bgobbato/spacer_shoulder/research/01_artigo_referencia.md

# 01 — Artigo de referência: Klosterman et al. 2021 (Arthroscopy Techniques), leitura integral + vídeo

> Pesquisa paralela ao SchulterPlan (não é código do produto). Escopo: espaçador umeral de PMMA com
> antibiótico, em dois tempos, com molde de duas metades para o segmento proximal (corpo + cabeça).
> Tudo que não pude confirmar numa fonte primária está marcado **NÃO VERIFICADO**.
> Data da leitura: 25/set/2026.

## 0. Resumo em 12 linhas

1. O artigo **não usa molde impresso nem feito sob medida**. Usa um **molde metálico comercial** da Wright Medical:
   "Aequalis Ascend Flex Convertible Shoulder System Molds", com **4 tamanhos de haste (2, 4, 6, 8)** e
   **3 cabeças (43 × 16, 48 × 18, 52 × 23 mm)**. O "custom" do título é o **comprimento**, feito com um
   **tubo torácico** como forma do segmento distal.
2. O molde tem **4 peças por conjunto montado**: 2 blocos de haste (metades) e 2 meias-cúpulas de cabeça. Cada
   meia-cúpula é **aparafusada** ao seu bloco de haste na face oblíqua proximal (o plano de ressecção), com 2
   parafusos Allen por metade (chave sextavada de 3,5 mm).
3. **Plano de partição**: é o plano que contém o eixo da haste e o eixo do colo. As metades são anterior e
   posterior do implante, exatamente o que o Dr. Bruno quer.
4. **Registro**: há **2 pinos machos de ponta abaulada numa metade** (canto próximo-lateral e canto
   disto-medial, em diagonal) e **2 furos passantes na outra**. Um único **grampo em C de aço inox** fecha
   o molde apertando as faces externas, que são planas e paralelas.
5. **Não há canal de injeção nem respiros**. Cada metade é enchida **a céu aberto**, com o cimento fluido
   ("manteiga de amendoim mole"). O molde é fechado por compressão e o excesso sai pela linha de partição
   e é removido. A extremidade distal tem um **cone (funil)** que **não se enche**: por ali saem o fio-guia
   e o tubo.
6. **Reforço**: é uma **haste de fresagem de 2,5 mm com ponta em bola** (DePuy Synthes). Ela vai da ponta
   distal do tubo até dentro da cabeça. A bola fica na cabeça. **Não há pino de Steinmann** nem outro
   reforço.
7. **Cimento**: Palacos R (pacote de 40,3 g de pó + 20 mL de líquido). Por pacote vão **3,6 g de
   tobramicina + 2,0 g de vancomicina**. Com 2 pacotes usam 2,5 "doses" de monômero, e com 3 pacotes
   usam 3,5. Os antibióticos são misturados primeiro ao monômero. Na primeira vez, planejar 3 pacotes.
8. **Tubo torácico**: tenha à mão tubos de **24 a 34 Fr**. A conversão é **1 mm = 3 Fr**. O texto do
   artigo diz "3 mm = 1 French", mas a Fig 2 e o vídeo dizem o contrário; ver §4.2. Fr é o diâmetro
   **externo**, então a haste de cimento sai **mais fina** que o Fr indica.
9. **Presa em cerca de 16 min** na mesa auxiliar. O **óleo mineral** no molde e dentro do tubo é, nas
   palavras dos autores, "crucial" para a desmoldagem.
10. **Desmoldagem**: abre-se o tubo com lâmina 10 e descola-se com Freer. Tira-se o grampo, soltam-se os
    parafusos e separam-se as metades. O espaçador sai com impactor de cabeça e martelo. O excesso de
    comprimento é cortado com alicate de corte (bolt cutter). A rebarba é lixada com a ponta serrilhada de
    um Darrach ou com lima, **com atenção especial à superfície articular**.
11. A técnica **não tem dados clínicos próprios**. As complicações foram inferidas da literatura de
    espaçadores comerciais: erosão óssea, fratura do espaçador, rotação, luxação e fratura do úmero.
12. Trabalhos posteriores que citam o artigo **criticam a haste feita em tubo torácico**: falta de rigidez,
    fratura do espaçador, poucos diâmetros e instabilidade rotacional. Eles propõem reforço com haste
    intramedular (Rush rod ou haste bloqueada). Ver §12.

---

## 1. Referência e acesso às fontes primárias

- Klosterman EL, Cotter EJ, Squire MW, Grogan BF. *Creation of a Custom-Length, Humeral Antibiotic Cement
  Spacer for Use in Treatment of Shoulder Periprosthetic Joint Infection.* Arthrosc Tech. 2021;10(2):e481–e486.
  doi:10.1016/j.eats.2020.10.027. PMID 33680782. PMCID PMC7917196. Licença CC BY-NC-ND 4.0.
  - Texto: https://pmc.ncbi.nlm.nih.gov/articles/PMC7917196/
  - PubMed: https://pubmed.ncbi.nlm.nih.gov/33680782/
  - DOI: https://doi.org/10.1016/j.eats.2020.10.027
  - XML integral (Europe PMC), usado para reconstruir as tabelas com as colunas certas:
    https://www.ebi.ac.uk/europepmc/webservices/rest/PMC7917196/fullTextXML
  - Vídeo (link do usuário): https://pmc.ncbi.nlm.nih.gov/articles/instance/7917196/bin/mmc1.mp4
    O `curl` direto no PMC devolveu uma página HTML de proteção anti-robô de 1,8 kB, não o vídeo. O arquivo
    foi baixado do pacote de material suplementar do próprio artigo no Europe PMC:
    https://www.ebi.ac.uk/europepmc/webservices/rest/PMC7917196/supplementaryFiles
    (zip de 33,2 MB com `mmc1.mp4`, `mmc2.pdf` = formulários ICMJE e `gr1–gr6`). É o mesmo arquivo do PMC.
  - `mmc1.mp4`: 31.718.342 bytes, MD5 `05728be46ee8528ca3083b8e5aec11c3`, 260,4 s, H.264 960×540 a
    29,97 fps, áudio AAC estéreo 48 kHz.
- Instituição: Department of Orthopedics and Rehabilitation, University of Wisconsin (Madison).
  Conflitos: M.W. Squire recebe royalties da Biomet e é consultor pago de Biomet e Heraeus. Isso aparece no
  cartão de conflitos do vídeo, aos ~12 s. A Heraeus fabrica o Palacos.

## 2. Indicação e racional (o que o artigo defende)

- IAP do ombro tratada em dois tempos, ou com espaçador definitivo. O caso típico é a retirada de uma
  **haste umeral longa bem fixa** que exige **osteotomia umeral estendida**. Nesse caso o espaçador deve ter
  haste "aproximadamente tão longa quanto o material retirado". Com isso a osteotomia pode ser fechada por
  cima dele, com várias cerclagens FiberTape (Arthrex).
- Vantagens (Tabela 3): comprimento e tamanho de cabeça sob medida para manter a tensão de partes moles e o
  comprimento do braço; superfície articular lisa; estabilidade para a osteotomia; depósito de antibiótico
  em todo o comprimento do canal; mistura de antibiótico escolhida conforme o germe.
- Desvantagens: tempo de confecção e de presa do cimento; muitos insumos.
- Limitação declarada: a utilidade clínica **não foi estudada**. Os riscos foram inferidos de McFarland
  2018: erosão óssea, fratura do espaçador, rotação, luxação, fratura na explantação e cimento distal retido.
  O artigo cita um único estudo de desenho de espaçador (Padegimas 2017: haste versus sem haste, sem
  diferença).

## 3. Materiais (lista do artigo, com o que o vídeo mostra)

| Item | Marca/modelo citado | Função | Observação no vídeo/figuras |
|---|---|---|---|
| Moldes de espaçador umeral proximal | *Aequalis Ascend Flex Convertible Shoulder System Molds*, Wright Medical Technology (Escondido, CA) | Moldar corpo + cabeça | Blocos metálicos polidos, "SIZE 2/4/6/8" gravado; meias-cúpulas de cabeça gravadas "43", "52 × 23" |
| Provas de cabeça (azuis) | "associated humeral head trials" (Fig 1) | Escolher o tamanho da cabeça in situ | 3 na Fig 1, 4 na mesa do vídeo, com furo central |
| Haste-guia metálica | *2.5-mm Reaming Rod with ball tip*, DePuy Synthes | Reforço/ligação entre corpo e tubo | Diâmetro da bola e comprimento de fábrica **NÃO VERIFICADOS** |
| Tubos torácicos | *Thoracic Catheter, Straight, Argyle* | Forma do segmento distal | Tubo transparente com linha radiopaca e marcas de profundidade |
| Óleo mineral | *Muri-Lube*, Fresenius Kabi | Desmoldante | Aplicado com seringa no molde e girando dentro do tubo |
| Cimento | *Palacos*, Zimmer Biomet (Warsaw, IN) | Matriz | No vídeo o envelope é **PALACOS®R** com logotipo Heraeus |
| Antibióticos em pó | vancomicina + tobramicina | Carga local | Não usados no vídeo (economia de material, dito no texto) |
| Chave Allen 3,5 mm | DePuy Synthes | Aparafusar cabeça ao bloco | Cabo azul |
| Cortadores de pino | DePuy Synthes, end-biting ou double-action | Cortar a haste-guia | Na mesa |
| Seringa 60 mL, com a ponta cortada | — | Encher o tubo com ~15 mL de cimento | Carregada pela traseira, com o êmbolo retirado |
| Pinça hemostática | — | Fechar a ponta distal do tubo cheio | Visível de 196 a 212 s |
| Grampo em C | não citado no texto; gravado "STAINLESS" | Fechar o molde | Um único grampo |
| Lâmina 10 + Freer, impactor de cabeça (cabo "BIOMET"), martelo, alicate de corte, Darrach ou lima | — | Desmoldar e acabar | Vídeo de 217 a 244 s e Fig 6 |

## 4. Técnica passo a passo (texto do artigo + vídeo)

### 4.1 Anestesia e posição
Cadeira de praia, anestesia geral e bloqueio interescalênico recomendado. Acesso deltopeitoral pela
incisão prévia.

### 4.2 Medição intraoperatória
- Retirada a haste infectada, o **diâmetro e o comprimento** do canal são medidos com as fresas retas do
  *Aequalis Flex Revive* e conferidos com radiografia ou TC pré-operatória.
- O diâmetro distal é convertido em tamanho de tubo. **Errata interna do artigo**: o texto e a legenda da
  Fig 2 dizem "3 millimeters = 1 French Gauge", o que está **invertido**. A tabela da própria Fig 2
  (24 Fr = 8,0 mm … 34 Fr = 11,3 mm) e o letreiro do vídeo aos ~88–92 s ("1 mm = 3 French Gauge") estão
  corretos: **Fr = 3 × diâmetro em mm**.
- Tabela da Fig 2: 24 Fr = 8,0 mm (0,315 in); 26 = 8,7 (0,341); 28 = 9,3 (0,367); 30 = 10,0 (0,393);
  32 = 10,7 (0,419); 34 = 11,3 (0,445).
- **Atenção de projeto**: o French de um tubo torácico é o **diâmetro externo**. No catálogo Argyle
  (Cardinal Health) o tubo reto de PVC vai de 12 a 40 Fr, com O.D. de 4,0 a 13,3 mm, 51 cm de comprimento,
  4 a 6 furos laterais e extremidade de conector chanfrada
  (https://www.henryschein.com/assets/Medical/2690515.pdf). O **diâmetro interno**, que é o diâmetro real da
  haste de cimento, **não é publicado: NÃO VERIFICADO**. Na prática, a haste distal sai mais fina que a
  fresa. O artigo não comenta isso.
- O tamanho do molde proximal sai da **raspa (broach) do Ascend Flex, componente longo**, com cabeça de
  prova, redução e teste de amplitude de movimento. Depois tiram-se da caixa os "jigs" de haste e de cabeça
  correspondentes.

### 4.3 Montagem do molde (vídeo 44–68 s; Fig 3)
Em cada metade, a meia-cúpula da cabeça é aparafusada ao bloco de haste com 2 parafusos Allen de cabeça
cilíndrica. São 4 parafusos por conjunto, e a Fig 1 mostra exatamente 4. A chave é sextavada de 3,5 mm.

### 4.4 Aumento distal com tubo torácico (vídeo 68–106 s; Fig 4)
- Comprimento do tubo = comprimento total desejado − comprimento da haste do molde. "Melhor sobrar; o
  excesso se corta depois."
- **Descarta-se a extremidade cônica do tubo**, a do conector (anotação da Fig 4).
- A **haste-guia** é colocada **dentro do molde aberto** para facilitar a medida, com a bola dentro da
  cúpula da cabeça. A ponta plana é cortada no **comprimento total** do componente.
- No vídeo, o tubo é marcado com caneta ao lado de uma régua de 15 cm e cortado com tesoura (73–101 s).

### 4.5 Desmoldante (vídeo 106–120 s)
As duas metades recebem óleo mineral. O tubo é lubrificado **por dentro**: injeta-se óleo com seringa
pequena e o tubo é invertido e girado. Segundo o texto, isso "facilita a extração e é crucial".

### 4.6 Mistura do cimento (vídeo 120–141 s; Tabela 2)
- O monômero pode ser **refrigerado** para retardar a presa. Antibiótico + monômero entram primeiro na
  cuba, os grumos são desfeitos com Freer e só então entra o pó. No vídeo o monômero vai primeiro, o pó
  depois, e a mistura é feita numa cuba com tampa e manivela. Consistência-alvo: "runny peanut butter".
- Receita da instituição: **2 pacotes de Palacos + 4,0 g de vancomicina + 7,2 g de tobramicina + 2,5 doses
  de monômero**, ou seja, 3,6 g de tobramicina e 2,0 g de vancomicina por pacote. Com 3 pacotes, usam-se
  3,5 doses. Recomenda-se misturar 3 pacotes na primeira vez.
- Contas minhas: 5,6 g de antibiótico por pacote de 40,3 g de pó dá ~13,9 % da massa de pó, ou ~12,2 % da
  massa pó + antibiótico. Uma "dose" deve ser uma ampola de 20 mL (a bula americana do Palacos R traz
  **40,3 g de pó + 20 mL de líquido** por unidade). Se for isso, 2 pacotes levam 50 mL de monômero em vez
  de 40 mL. O artigo **não define "dose": NÃO VERIFICADO**.
- O pó de 3,6 g de tobramicina corresponde a 3 frascos de 1,2 g. Isso é inferência minha e está **NÃO
  VERIFICADO**.

### 4.7 Enchimento e montagem (vídeo 141–212 s; Fig 5)
1. Corta-se a ponta de uma seringa de 60 mL, carregam-se ~15 mL de cimento ainda fluido, **enche-se o
   tubo** e fecha-se uma ponta com hemostática.
2. **Cada metade do molde é enchida** a céu aberto, com espátula ou com os dedos. **"Não encher o cone mais
   distal."**
3. Com o cimento mais viscoso, mas ainda mole, **insere-se a ponta cortada da haste-guia no tubo cheio**,
   centrada. O segmento com a bola fica exposto.
4. A parte da bola é **deitada ao longo da haste de uma metade**. A outra metade é fechada por cima e
   presa com o grampo. O excesso é removido e **confere-se se o tubo está centrado no molde**.
5. Uma amostra de cimento fica na mesa para acompanhar a presa, que é variável e leva "habitualmente
   ~16 min".
- **Alternativa em dois tempos**: primeiro se molda o corpo com a haste-guia saindo pela ponta distal.
  Depois de endurecer e desmoldar, mistura-se o segundo lote, enche-se o tubo e **enfia-se o tubo sobre a
  haste exposta**. É mais fácil, porém mais demorado.

### 4.8 Extração (vídeo 212–245 s)
Abre-se o tubo com lâmina 10 e Freer. Tira-se o grampo e abre-se o molde. No vídeo os parafusos da
cúpula são soltos, a metade superior sai e o espaçador é empurrado para fora da metade inferior com
**impactor de cabeça** e martelo. O comprimento é aparado com bolt cutter. As arestas são alisadas com a
ponta serrilhada de um Darrach ou com lima. "Particular attention is paid to the articulating surface."

### 4.9 Implantação
O espaçador é implantado "da forma padrão". Havendo osteotomia, ela é fechada sobre o implante com várias
cerclagens FiberTape.

## 5. Tabelas do artigo (colunas reconstruídas a partir do XML)

**Tabela 1: Pearls and Pitfalls.** A versão HTML embaralha as colunas; no XML elas estão assim:

| Etapa | Pérolas | Armadilhas |
|---|---|---|
| Planejamento | Combinar com a equipe para ter o material | — |
| Medida intraoperatória | Ter tubos de **24–34 F** | — |
| Montagem do molde | — | — |
| Aumento distal (tubo) | — | Melhor superestimar o comprimento; óleo mineral é essencial para tirar o tubo |
| Mistura do cimento | — | Misturar em 2 lotes ou usar 3 pacotes |
| Enchimento/montagem | — | Óleo mineral é essencial para tirar o espaçador |
| Extração | Ter impactor de cabeça | — |

**Tabela 2: receita.** 3,6 g de tobramicina + 2,0 g de vancomicina por pacote de Palacos; 2 pacotes para
2,5 doses de monômero; 3 pacotes para 3,5 doses; antibiótico + monômero primeiro, depois o Palacos.

**Tabela 3: vantagens e desvantagens.** Resumida no §2.

## 6. Figuras do artigo (vistas uma a uma)

- **Fig 1**: kit. Quatro blocos de haste de tamanhos crescentes, três meias-cúpulas de cabeça, três provas
  azuis, um grampo em C gravado "STAINLESS" e quatro parafusos Allen. Os blocos têm 2 furos grandes, um
  próximo-lateral e outro distal.
- **Fig 2**: tabela Fr → mm → polegadas, de 24 a 34 Fr.
- **Fig 3**: duas metades (esquerda e direita), cada uma com bloco de haste + meia-cúpula e 2 parafusos,
  mais a chave DePuy Synthes. Metade direita: 2 pinos abaulados (próximo-lateral e disto-medial). Metade
  esquerda: 2 furos. Cavidade da haste lisa e polida, com alargamento metafisário, curva medial (calcar) e
  ombro lateral. Na ponta distal fica o **cone em V**.
- **Fig 4**: haste-guia deitada no molde aberto e tubo sendo marcado ao lado da régua. Anotações: "Discard
  conical end of chest tube" e "Lay metal guidewire in mold for easy measuring".
- **Fig 5A–E**: seringa enchendo o tubo; metades cheias de cimento verde; haste-guia no tubo e deitada na
  metade; grampo; conjunto montado com **"SIZE 4"** gravado em letras grandes na face externa do bloco.
- **Fig 6**: espaçador final ao lado de régua Cardinal Health de 15 cm. Segmento distal fino e cilíndrico
  (o tubo). Um degrau/colar na junção com o corpo moldado. Corpo fusiforme sem aletas nem furos. Cabeça em
  calota com borda plana que ultrapassa o colo, como a cabeça de uma prótese.

## 7. Vídeo: linha do tempo pelos letreiros (cortes de cena medidos com ffmpeg)

| Tempo (s) | Letreiro ou conteúdo |
|---|---|
| 0–~12 | Título + autores (UW Orthopedics and Rehabilitation) |
| ~12–17,8 | Conflitos de interesse |
| 17,8–43,7 | Mesa montada: todas as peças, Palacos R, cuba, seringas, grampo, provas azuis |
| 43,7–46,8 | **"Assemble the humeral mold"** |
| 46,8–68,5 | Montagem cabeça + haste com chave Allen, tamanho 4 |
| 68,5–71,3 | **"Prepare the distal chest tube augment"** |
| 71,3–105,9 | Haste-guia no molde, régua, marcação e corte do tubo; letreiro **"1 mm = 3 French Gauge"** aos ~88–92 s |
| 105,9–108,7 | **"Coat chest tube and mold in mineral oil"** |
| 108,7–120,3 | Óleo com seringa nas metades e no tubo |
| 120,3–122,9 | **"Mix antibiotic cement"** |
| 122,9–141,2 | Monômero na cuba, pó por cima, mistura com manivela |
| 141,2–143,6 | **"Fill chest tube and mold with cement"** |
| 143,6–177,6 | Seringa enchendo o tubo; metades enchidas a céu aberto |
| 177,6–180,2 | **"Place guide rod to assemble spacer"** |
| 180,2–212,4 | Haste-guia no tubo, deitada na metade; fechamento; grampo em C; hemostática na ponta do tubo |
| 212,4–214,7 | **"Remove spacer from chest tube and mold"** |
| 214,7–245,5 | Tubo aberto com bisturi; grampo retirado; parafusos soltos; metade retirada; impactor "BIOMET" + martelo |
| 245,5–248,5 | **"Custom length, humeral antibiotic cement spacer"** |
| 248,5–257,4 | Espaçador pronto, cerca de 25–30 cm (estimativa visual) |
| 257,4–260,4 | "Thank you" |

- O áudio tem pausas curtas e irregulares, padrão de **narração falada**. **Não foi transcrito**, porque
  não há ferramenta de reconhecimento de fala instalada e a regra era não instalar nada. O conteúdo narrado
  fica **NÃO VERIFICADO**. Os letreiros na tela batem com os subtítulos do texto.

## 8. Descrição precisa do molde (o que interessa ao nosso gerador)

**Fabricante/produto**: "Aequalis Ascend Flex Convertible Shoulder System Molds", Wright Medical Technology,
segundo o artigo. Não encontrei esses moldes no catálogo de implantes e instrumentais da técnica cirúrgica
Ascend Flex (versão BMG,
https://www.bmgorthopaedics.com/wp-content/uploads/2020/01/95_Ascend-flex-surgical-technique_file1.pdf,
busca por "spacer/mold"). Se é item de catálogo, instrumental especial ou peça fora de linha, e quais
são o número de referência e o material, fica **NÃO VERIFICADO**. O cabo do impactor diz "BIOMET". Nenhuma
marca do fabricante é legível nos blocos do molde.

| Aspecto | O que se vê / o que diz o texto | Confiança |
|---|---|---|
| Material/acabamento | Metal polido espelhado. Parece aço inox no vídeo; nas Figs 1 e 3 o tom dourado deve ser balanço de branco. A liga não é informada | média (aparência); liga NÃO VERIFICADA |
| Número de peças | Por conjunto montado: **2 blocos de haste + 2 meias-cúpulas + 4 parafusos + 1 grampo** | alta |
| Modularidade | 4 blocos de haste (2, 4, 6, 8) × 3 cabeças (43 × 16, 48 × 18, 52 × 23), combináveis porque a cúpula é aparafusada na **face oblíqua proximal do bloco (plano de ressecção)** | alta |
| Plano de partição | Plano que contém o eixo da haste e o eixo do colo, o plano da inclinação cervicodiafisária. As metades são **anterior/posterior do implante**. A partição corta a cabeça num meridiano e **passa pela superfície articular** | alta |
| Registro | **2 pinos machos de ponta abaulada numa metade**, em diagonal (próximo-lateral e disto-medial), e **2 furos passantes** na outra | alta (Fig 3) |
| Fechamento | **1 grampo em C** apertando as faces externas planas e paralelas dos blocos | alta |
| Enchimento | **A céu aberto, metade por metade**, sem canal de injeção (sprue) nem respiros. Fecha-se por compressão e o excesso sai pela partição ("Remove any excess cement") | alta |
| Cone distal | Funil em V na ponta distal (meio cone em cada metade), com orifício estreito na ponta da cavidade. **Não se enche**: é o encaixe/saída do fio-guia e do tubo | alta (texto + Fig 3) |
| Fenda lateral | Ranhura curta de fundo arredondado na face de partição, na borda medial da metade da haste, nas duas metades e na mesma altura. **Não comunica com a cavidade**. Provável fenda para alavanca de abertura; o artigo não diz a função | média; função NÃO VERIFICADA |
| Gravações | "SIZE 2/4/6/8" em letras grandes na face externa do bloco; "43", "52 × 23" na face externa da meia-cúpula (um terceiro número está ilegível no vídeo) | alta |
| Ângulo colo-diáfise | **Não informado**. Pela Fig 3 estimei ~130–140°, com erro de perspectiva grande. Coerente com os 132,5° das hastes Ascend Flex "B", e as hastes longas só existem em "B" (catálogo) | estimativa, NÃO VERIFICADO |
| Forma do corpo | Replica o corpo de uma haste Ascend Flex: alargamento metafisário, calcar medial curvo, ombro lateral, afilamento distal. O espaçador (Fig 6) é **maciço, sem aletas nem furos** | média |
| Cabeça | Calota esférica com base plana (borda) que ultrapassa o colo. O "altura" dos tamanhos é a altura da calota | alta (catálogo: diâmetro × altura) |
| Junção com o tubo | Fio de 2,5 mm contínuo do tubo até a bola dentro da cabeça. O tubo encosta no cone distal. Na Fig 6 há **degrau/colar** na junção | alta |
| Desmoldagem | Abrir o tubo; tirar o grampo; soltar os parafusos da cúpula; separar as metades; **empurrar com impactor e martelo**; aparar e limar a rebarba | alta |

**Medidas estimadas por fotogrametria (Fig 6, régua de 15 cm ≈ 20,6 px/cm)**: base da cabeça ~51 mm e
altura ~19 mm, compatível com a cabeça **48 × 18**, considerando que a cabeça fica mais perto da câmera
que a régua. Segmento moldado (corpo + cabeça) com ~13 cm de comprimento. Espaçador inteiro com ≥ 27 cm.
**Tudo isso é estimativa: NÃO VERIFICADO.**

**Correspondência com o catálogo Ascend Flex (só referência de tamanho, NÃO copiar)**. Pela técnica
cirúrgica (BMG, link acima):
- As hastes **cimentadas** existem justamente nos tamanhos **2, 4, 6, 8**. Standard: 66/74/82/90 mm.
  Longas: 88/98/109/120 mm, só a 132,5°.
- As **cabeças do catálogo** incluem 43 × 16, 48 × 18 e 52 × 23 (diâmetro × altura), com offsets de 1,5,
  3,5 ou 4 mm.
- Inclinações das hastes curtas: 127,5°, 132,5° e 137,5°.
- Qual comprimento de haste cada bloco reproduz fica **NÃO VERIFICADO**.

## 9. Fatos de insumos conferidos em fonte primária

- **Palacos R (bula EUA, Heraeus)**: pó 40,3 g + líquido 20 mL. Pó com 84 % de copolímero de PMMA, 15 % de
  ZrO₂ e 1 % de peróxido de benzoíla. Líquido com 98 % de MMA e 2 % de DMPT. Corante de clorofila (daí o
  verde). A bula **proíbe misturar qualquer substância** ("especially aqueous (e.g., antibiotic containing)
  solutions") e **contraindica o uso na presença de infecção ativa**. Portanto o espaçador artesanal com
  antibiótico é **uso fora da bula**, sob responsabilidade do cirurgião.
  https://www.heraeus-medical.com/dam/jcr:d86b70e4-3d53-457d-9ce6-91f1a107a9a2/palacos-r-ifu-us.pdf
- **Tubo Argyle reto (Cardinal Health)**: O.D. = Fr/3 mm, 51 cm, 4 a 6 furos laterais, conector chanfrado.
  O I.D. não é publicado. https://www.henryschein.com/assets/Medical/2690515.pdf
- **Slane, Gietman, Squire 2018** (Squire é coautor do nosso artigo): em Palacos R, **3 g de tobramicina +
  2 g de vancomicina** deram a **maior liberação acumulada em 28 d**. O custo foi **queda das propriedades
  mecânicas e aumento da porosidade**. Mais antibiótico não significou mais liberação. É a base provável da
  receita 3,6 + 2,0 g. https://pubmed.ncbi.nlm.nih.gov/28876459/

## 10. Fichamento da literatura citada pelo artigo

| # | Referência | Acesso lido | O que importa para o projeto |
|---|---|---|---|
| 5 | Patrick 2019, JSES 28:1658 — https://pubmed.ncbi.nlm.nih.gov/31208895/ | resumo | 47 pacientes: 27 em dois tempos, 20 com espaçador definitivo. Recidiva 3 vs 2 (NS). Constant 58,1 vs 33,3 e elevação 94° vs 49° a favor dos dois tempos |
| 6 | Pellegrini 2018, AOTS 138:605 — https://pubmed.ncbi.nlm.nih.gov/29335894/ | resumo | 19 espaçadores articulados definitivos em idosos de baixa demanda, sem recidiva |
| 7 | Pellegrini 2019, OTSR 105:237 — https://pubmed.ncbi.nlm.nih.gov/30497888/ | resumo | 30 pacientes com seguimento médio de 8 anos: função melhor com revisão, mais complicações; espaçador definitivo para alto risco |
| 8 | Cronin 2020, JSES 29:e325 — https://pubmed.ncbi.nlm.nih.gov/32245728/ | resumo | 12 espaçadores retidos por ≥ 2 anos (média 5,6): ASES 54, EVA 2,8, FE 68° |
| 9 | Fink & Sevelda 2017, Biomed Res Int — https://pmc.ncbi.nlm.nih.gov/articles/PMC5750516/ | integral | O espaçador mantém a tensão de partes moles e o comprimento do braço. No espaçador temporário "a qualidade mecânica não é primária", o que permite mais antibiótico. Antibiótico conforme o germe |
| 10 | Marcheggiani Muccioli 2017, Int Orthop — https://pubmed.ncbi.nlm.nih.gov/28124103/ | resumo | Revisão sistemática com 287 pacientes. Infecção persistente: espaçador 6,1 %, dois tempos 14,3 %, um tempo 3,9 %. Constant do espaçador 31 |
| 11 | McFarland 2018, JSES 27:1996 — https://pubmed.ncbi.nlm.nih.gov/29778591/ | resumo | 60 espaçadores **comerciais**: erosão (6 glenoide, 2 diáfise), **fratura do espaçador (4)**, **rotação (3)**, fratura do úmero (3). Retidos: 3 erosões da diáfise e 1 fratura |
| 12 | Duey 2012, Iowa Orthop J — https://pmc.ncbi.nlm.nih.gov/articles/PMC3565390/ | resumo (PMC só tem PDF) | Área e volume **não** mudaram a taxa de eluição de forma significativa. UCS > 70 MPa em todos os corpos de prova |
| 13 | Citak 2014 (ICM, "Spacers"), J Orthop Res 32 S1 — https://pubmed.ncbi.nlm.nih.gov/24464885/ | sem resumo | Não lido: NÃO VERIFICADO |
| 14 | Slane 2018 | resumo | ver §9 |
| 16 | Padegimas 2017, Clin Orthop Surg 9:489 — https://pmc.ncbi.nlm.nih.gov/articles/PMC5705308/ | integral | 37 espaçadores **artesanais** (22 sem haste, 15 com haste; todos com tobramicina + vancomicina). A haste era moldada à mão "no formato de uma haste umeral, com ou sem fio central pré-dobrado". Sem diferença em reimplante, complicações, tempo cirúrgico e FE |
| 2, 3 | Cooper 2019 (JBJS Rev, https://pubmed.ncbi.nlm.nih.gov/31291202/); Garrigues 2019 (ICM) | sem resumo | contexto diagnóstico; não lidos |

## 11. Trabalhos posteriores que citam o artigo (Europe PMC, "CITES")

- **Beady et al. 2025, "The Frankenspacer"**, JSES Rev Rep Tech — https://pmc.ncbi.nlm.nih.gov/articles/PMC12573618/
  (integral). **Crítica explícita**: hastes longas em tubo torácico "podem fraturar antes ou durante o
  segundo tempo por falta de rigidez", com "diâmetros limitados" e "instabilidade rotacional". A
  alternativa deles: cabeça pré-fabricada (OsteoRemedies, 40/45/50 mm) + **pino de Steinmann rosqueado a
  135°** + haste umeral intramedular canulada + 1 lote de cimento com 1 g de ceftazidima e 3 g de
  vancomicina por 40 g formando o corpo proximal, afilado para encaixar sob pressão no canal residual, a 30°
  de retroversão. Resultados em 18 ombros: nenhuma fratura do espaçador; **luxação em 56 %**, erosão da
  glenoide em 83 %, soltura em 11 %.
- **Adan et al. 2026**, JSES Rev Rep Tech — https://pmc.ncbi.nlm.nih.gov/articles/PMC13332471/ (integral).
  27 espaçadores umerais custom em 306. Usam **Rush rod** como arcabouço intramedular. Pérolas: **centralizar
  o pino para não criar concentrador de tensão na cortical**, confirmar o bypass distal com fluoroscopia,
  construto mais longo em obesos, carga de antibiótico conforme o germe. "Head size is shaped to
  approximate native tension while avoiding overstuffing."
- **Saíz Guzmán & Sarmiento Guzmán 2025**, WJARR 26(1):1964 —
  https://journalwjarr.com/sites/default/files/fulltext_pdf/WJARR-2025-1237.pdf (integral). A haste é uma
  **haste intramedular umeral cortada**, encaixada no núcleo metálico de um espaçador curto comercial e
  revestida de cimento **dentro de um tubo torácico de 36–38 Fr como molde**. O texto descreve o núcleo do
  Klosterman como "Steinman nail", o que é impreciso: é a haste de fresagem de 2,5 mm.
- **Chulsomlee et al. 2026**, Int Orthop — https://pmc.ncbi.nlm.nih.gov/articles/PMC13275629/ (integral).
  Cimento com vancomicina **pré-fabricado e esterilizado em formaldeído** perde atividade só na fase inicial
  (dias 1–7). Com 4 g, dá para guardar por até 7 dias. Diz que moldar o espaçador na hora acrescenta 20–30
  min à cirurgia. Tem relação com fazer o espaçador antes da cirurgia.

Outras fontes clínicas lidas (resumos) que ajudam a situar o desenho:
- Namdari 2022, JAAOS (revisão de espaçadores: com/sem haste, pré-fabricado/artesanal, antibióticos) —
  https://pubmed.ncbi.nlm.nih.gov/35452429/
- Grubhofer 2018, CORR (38 pacientes, controle da infecção em 95 %, espaçador com gentamicina +
  vancomicina) — https://pubmed.ncbi.nlm.nih.gov/29389759/
- Stine 2010, JSES (espaçador articulado fixo, 30 casos, erradicação em 100 %) — https://pubmed.ncbi.nlm.nih.gov/20137977/
- Levy 2015, Orthopedics (espaçador funcional: hemiartroplastia com haste revestida de cimento sem fixar) —
  https://pubmed.ncbi.nlm.nih.gov/26091225/
- Mahure 2016, Orthopedics (9 espaçadores definitivos, ASES 57) — https://pubmed.ncbi.nlm.nih.gov/27359283/
- List 2023, Oper Orthop Traumatol ("patient-specific articulating spacer" para o ombro; só o resumo, a
  técnica de moldagem **NÃO VERIFICADA**) — https://pubmed.ncbi.nlm.nih.gov/37133809/

## 12. Implicações para o gerador paramétrico

1. **O conceito do Dr. Bruno é o mesmo do molde comercial**: duas metades, anterior e posterior, partidas
   no plano haste + colo, com pinos de registro, para o corpo + cabeça, e a haste distal feita em tubo
   torácico. A diferença é que o nosso é paramétrico e impresso. **Não copiar a geometria Ascend Flex**:
   usar os tamanhos só como faixa de referência (cabeças de 43–52 mm, alturas de 16–23 mm).
2. **Registro**: o comercial põe os 2 machos na mesma metade, em diagonal. A especificação do usuário é 1
   macho + 1 fêmea por metade. Manter a **disposição diagonal e afastada** (próximo-lateral e disto-medial)
   para travar a rotação no plano.
3. **Faces externas planas e paralelas**, dimensionadas para um grampo em C, ou prever furos para
   parafusos/porcas passantes. O comercial usa um só grampo sobre a região metafisária.
4. **Enchimento a céu aberto com excesso**: prever uma **faixa de rebarba fina** e canais de escape ao
   redor da cavidade, longe da superfície articular. O comercial não tem, e a rebarba é limada à mão. A
   linha de partição **atravessa a cabeça**, então a precisão do encaixe define a qualidade articular.
5. **Porta distal**: ter um **cone ou funil distal** que receba o tubo torácico (O.D. de 8,0 a 11,3 mm para
   24–34 Fr) e/ou o pino de reforço. Na interface, parametrizar o diâmetro do tubo em Fr.
6. **Canal do reforço**: o comercial deixa o fio solto no cimento, e Adan 2026 recomenda centralizar. Um
   rebaixo ou guia que mantenha o pino **centrado** no eixo da haste até dentro da cabeça faria diferença.
   A bitola do pino é decisão clínica: 2,5 mm (Klosterman), Steinmann rosqueado (Beady) ou haste
   intramedular (WJARR/Beady).
7. **Desmoldagem**: óleo mineral é essencial. Prever **fendas de alavanca** na partição (como a ranhura do
   comercial), **ângulo de saída** e cavidade lisa. Pensar num **acesso para impactor**: o comercial
   precisou de impactor e martelo.
8. **A junção corpo–haste distal é o ponto fraco**, com degrau visível na Fig 6 e fraturas relatadas com
   tubo torácico (Beady). Uma **transição gradual** (sem degrau) na saída distal do molde e um reforço
   contínuo reduziriam o concentrador de tensão.
9. **Corpo maciço, sem furos ou aletas**, como pede o usuário. Coincide com o espaçador da Fig 6.
10. **Volume de cimento**: o artigo gastou de 2 a 3 pacotes de 40 g para molde + tubo. O gerador deve
    **calcular o volume da cavidade (mL)** e mostrar ao cirurgião. Converter em pacotes exige a densidade
    do Palacos curado, que eu **não verifiquei**.
11. **Tempo e temperatura**: presa de ~16 min na mesa. O comportamento térmico do material impresso diante
    da exotermia do PMMA **não foi verificado aqui** (fica para o tópico de materiais do molde).
12. **Cabeça**: calota esférica lisa com base plana e borda que ultrapassa o colo. O cirurgião quer a
    cabeça maior que a de uma prótese. Adan 2026 alerta para evitar o "overstuffing". A decisão é clínica.

## 13. Pontos NÃO VERIFICADOS e perguntas abertas

- Status de catálogo, número de referência, material e disponibilidade atual dos "Ascend Flex spacer molds".
  A Wright Medical foi comprada pela Stryker e não achei página de produto.
- Diâmetro da bola e comprimento da haste de fresagem de 2,5 mm (DePuy Synthes).
- Diâmetro interno dos tubos Argyle por tamanho Fr, que define o diâmetro real da haste distal.
- O que é uma "dose" de monômero (provavelmente uma ampola de 20 mL).
- O ângulo colo-diáfise e o comprimento que cada bloco reproduz. Só tenho estimativa fotográfica e
  inferência pelo catálogo.
- A função da ranhura lateral (alavanca ou outra).
- Qual cabeça foi usada no vídeo. A mais provável é 48 × 18: é a que falta entre as sobras da mesa e bate
  com a medida da Fig 6.
- A narração do vídeo não foi transcrita.
- Como os furos laterais do tubo torácico são tratados (vazamento de cimento). O artigo não comenta.

## 14. Arquivos de quadros usados (e o que cada um mostra)

Os quadros extraídos do artigo e do vídeo **não são publicados neste repositório** (licença CC BY-NC-ND 4.0,
© Arthroscopy Association of North America). Para ver: artigo e vídeo suplementar em
https://pmc.ncbi.nlm.nih.gov/articles/PMC7917196/ . A tabela abaixo só descreve o que cada figura ou trecho
do vídeo mostra.

| Quadro (não publicado) | Origem | Mostra |
|---|---|---|
| `fig1_kit_moldes.jpg` | Fig 1 | Kit: 4 blocos de haste, 3 meias-cúpulas, 3 provas azuis, grampo "STAINLESS", 4 parafusos |
| `fig2_tabela_french_mm.jpg` | Fig 2 | Tabela 24–34 Fr em mm e polegadas |
| `fig3_metades_montadas.jpg` | Fig 3 | As duas metades montadas, pinos × furos, cavidade, cone distal |
| `fig3_zoom_fenda_lateral.jpg` | recorte da Fig 3 | Ranhura cega na borda medial da face de partição (sem ligação com a cavidade) |
| `fig3_zoom_cone_distal_pinos.jpg` | recorte da Fig 3 | Cone em V distal; furo passante (esquerda); pino abaulado (direita) |
| `fig4_medida_tubo_fio.jpg` | Fig 4 | Haste-guia no molde; tubo sendo marcado; "discard conical end" |
| `fig5_enchimento_fechamento.jpg` | Fig 5A–E | Seringa no tubo; metades cheias; fio deitado; grampo; "SIZE 4" |
| `fig6_espacador_final.jpg` | Fig 6 | Espaçador final com régua de 15 cm |
| `fig6_grade_medida_cabeca.jpg` | Fig 6 com grade | Grade de 20 px usada para estimar a cabeça (~51 × 19 mm) |
| `v020s_mesa_setup.jpg` | vídeo 20 s | Mesa completa: blocos, cúpulas, provas, grampo, envelope PALACOS R, cuba |
| `v020s_zoom_blocos_haste_cabeca.jpg` | vídeo 20 s | 4 blocos de haste com furos de registro e cone distal; 4 cúpulas; provas azuis |
| `v045-066s_montagem_cabeca_haste.jpg` | vídeo 45–66 s | Aparafusando a meia-cúpula no bloco com chave Allen |
| `v052s_gravacao_SIZE2_SIZE6.jpg` | vídeo 52 s | Face externa plana com "SIZE 2" e "SIZE 6"; furos passantes |
| `v073-101s_medida_corte_tubo.jpg` | vídeo 73–101 s | Metades em pé; fio no molde; marcação e corte do tubo |
| `v076-098s_gravacao_cabecas_43_52x23.jpg` | vídeo 76–98 s | Cúpulas com "43" e "52 × 23" (primeira ilegível) |
| `v090s_overlay_1mm_3Fr.jpg` | vídeo 90 s | Letreiro "1 mm = 3 French Gauge"; blocos SIZE 2/6/8 |
| `v110-155s_oleo_mistura.jpg` | vídeo 110–155 s | Óleo com seringa nas metades; cimento verde na cuba |
| `v160-177s_enchimento_tubo_metades.jpg` | vídeo 160–177 s | Seringa de 60 mL enchendo o tubo; metades enchidas à mão |
| `v182-202s_fio_guia_fechamento.jpg` | vídeo 182–202 s | Fio-guia entrando no tubo cheio; fechamento das metades |
| `v196-212s_grampo_C.jpg` | vídeo 196–212 s | Grampo em C aplicado; tubo saindo da ponta distal; hemostática |
| `v222s_face_distal_tubo_saindo.jpg` | vídeo 222 s | Face distal do molde fechado; linha de partição; tubo saindo |
| `v217-244s_desmoldagem.jpg` | vídeo 217–244 s | Tubo aberto com bisturi; "SIZE 4"; parafusos soltos; impactor "BIOMET" |
| `v250-253s_espacador_pronto.jpg` | vídeo 250–253 s | Espaçador final na mão (cabeça, corpo, degrau da junção, haste em tubo) |

Licença das figuras e do vídeo: CC BY-NC-ND 4.0 (© Arthroscopy Association of North America).
