bgobbato/spacer_shoulder/research/02_opcoes_comerciais.md

# 02 — Opções comerciais: espaçadores de ombro (úmero) com cimento antibiótico e moldes

Pesquisa feita em 25/09/2026, para apoiar o gerador paramétrico de moldes do espaçador umeral
(cabeça lisa + corpo proximal em duas metades, anterior e posterior, com pinos de registro).
**Este documento não é especificação de produto.** Serve de referência de mercado, de tamanhos e de taxas de falha.

Convenções: medidas em mm. "NÃO VERIFICADO" = não consegui confirmar numa fonte primária.
Fontes primárias usadas: IFUs, catálogos, sumários 510(k) do FDA, base GUDID/openFDA e resumos no PubMed.
Parte do texto completo dos artigos está atrás de paywall; nesses casos só uso o resumo e digo isso.

---

## 0. Resumo em 12 linhas

1. **Pré-formados de ombro no mercado (com núcleo de aço inox e gentamicina):** Tecres **Spacer-S / InterSpace Shoulder** (cabeças de 41 e 46 mm),
   OsteoRemedies **REMEDY Shoulder** (modular, com cabeças de 40, 45 e 50 mm e 3 hastes), Synimed **SYNICEM Shoulder** (40 e 48 mm) e
   G21 **SpaceFix / Arthrex CeMend Shoulder Spacer** (4 tamanhos, liberado pelo FDA em 15/09/2025).
2. **Moldes intraoperatórios de ombro:** Zimmer Biomet **StageOne Shoulder** (silicone, **sem núcleo metálico**, 5 tamanhos, cabeças de 42 a 58 mm),
   G21 **SpaceFlex Shoulder** = Arthrex **CeMend Shoulder Spacer Mold** (**duas meias-moldes plásticas** + haste de aço inox com 2 pinos de centragem) e
   **Osartis Shoulder Spacer Molds** (liberação FDA K240856, 2024; hastes de inox com centralizadores).
   Klosterman 2021 usou moldes da Wright/Tornier (Aequalis Ascend Flex), que não achei em catálogo atual.
3. A **maior cabeça comercial** encontrada é a do StageOne: **58 × 24 mm**. Nos pré-formados, a maior é 50 mm (REMEDY).
4. O ângulo cervicodiafisário dos pré-formados é **130°** (InterSpace e REMEDY). O comprimento total vai de 99 a 131 mm e o diâmetro distal da haste de 7 a 14 mm.
5. **Todos os pré-formados e dois dos três kits de molde levam alma de aço inox.** A Tecres acrescentou o núcleo metálico ao InterSpace Shoulder em 2011 (K112983).
   Na série PROSTALAC de Jawa, as 3 fraturas foram todas em construções com placa um-terço tubular, e a equipe trocou para LC-DCP 3,5.
6. **Falhas publicadas:** fratura do espaçador em cerca de **5–8 %**. As séries: revisão sistemática 5,6 %; McFarland 4 fraturas em 50 espaçadores revisados;
   REMEDY 5,7 %. A **luxação é mais variável**: 0,7 % na revisão sistemática, 13,2 % com o REMEDY e 56 % no Frankenspacer, com perda óssea umeral.
   A **rotação da haste** e a **erosão da glenoide e do úmero** são frequentes.
7. Nenhum estudo comparou marcas de ombro entre si. A única comparação direta encontrada (Porcellini, Itália, 48 pacientes) é **pré-formado modular × feito à mão**:
   função melhor no pré-formado e 1 fratura em cada grupo. A marca do pré-formado não aparece no resumo.
8. **Preço público:** quase nenhum. Achei um único, de revendedor dos EUA: molde StageOne 431408 a **US$ 9.836,99**.
   Moerenhout 2021 (quadril e joelho) calcula que o espaçador feito à mão sai **pelo menos 40–50 % mais barato** que o pré-formado ou o molde comercial.
9. **Patentes vigentes que citam molde de espaçador de ombro:** Heraeus US 11,865,006 (molde em 2 partes, cabeça + haste, com núcleo de flange; até 2041)
   e US 11,998,451 (válvula de enchimento; até 2042). A Tecres tem US 10,123,877 (espaçador de ombro modular anatômico/reverso; até 2035).
   O nosso conceito (metades anterior e posterior com cilindros macho/fêmea) é diferente da reivindicação 1 da Heraeus, mas **precisa de análise de liberdade de operação (FTO)** antes de qualquer uso comercial.
10. **Brasil/ANVISA:** não consegui confirmar nenhum espaçador de **ombro** registrado. A consulta da ANVISA bloqueou o acesso automatizado.
    Existe registro de espaçador pré-formado de **joelho** (Víncula/Subiton, ANVISA 81361440028, PMMA + gentamicina + aço 316L).
11. **"InSpace" NÃO é espaçador antibiótico.** É o balão subacromial biodegradável da OrthoSpace/Stryker para lesão maciça do manguito. Não entra nesta comparação.
12. Implicações de projeto: seção 9 (usar o envelope de tamanhos comercial, prever alma metálica e centragem, porta de injeção, respiro e estimativa de cimento).

---

## 1. Espaçadores PRÉ-FORMADOS de ombro

### 1.1 Tecres Spacer-S / InterSpace Shoulder (Itália; nos EUA, distribuído antes pela Exactech e hoje pela OsteoRemedies)

- **O que é:** hemiartroplastia monobloco de PMMA radiopaco com gentamicina, moldada sobre uma **estrutura de aço inox**.
  O IFU descreve o desenho como imitação de uma prótese de hemiombro.
- **Tamanhos (tabela do IFU OsteoRemedies OST008, 2024):**

  | REF | A = Ø da cabeça | B = altura da cabeça | C = comprimento total | D = Ø distal da haste | Gentamicina base |
  |---|---|---|---|---|---|
  | SPS0021 | 46 | 22 | 125 | 11 | 0,8 g |
  | SPS0121 (small) | 41 | 16 | 99 | 7 | 0,4 g |

  O desenho do IFU marca **130°** entre o eixo do colo e o da haste. A camada externa tem **1,87 % de gentamicina base**.
- **Eluição in vitro em 7 dias:** 49,3 mg (SPS0021) e 34,3 mg (SPS0121). No 1º dia saem 24,8 e 25,5 mg.
- **Técnica (IFU):** posicionar a cabeça com ~40° de retroversão ("como nas próteses metálicas").
  Se a haste ficar instável, **cimentar a parte proximal com Cemex Genta** para evitar rotação. Reconstruir o manguito e o subescapular. Usar órtese de abdução nos casos de risco.
  Uso máximo de **180 dias**.
- **Riscos listados no IFU:** quebra, luxação e soltura do dispositivo, liberação de detritos e dificuldade de remoção.
- **Regulatório:** 510(k) **K060535** (2006, "SPACER-S temporary shoulder spacer") e **K112983** (2011).
  O K112983 foi submetido "para a introdução de uma estrutura metálica de reforço no dispositivo". Ou seja, a versão original não tinha núcleo metálico.
  Há uma prova de tamanho (trial) SPS90Z1 no GUDID.
- **Clínica:** Coffey 2010 (16 ombros, 15 pacientes, sem recidiva de infecção em 20,5 meses). O resumo não traz taxas de fratura e luxação: NÃO VERIFICADO.
  Magnan 2014 (7 ombros, 40,7 meses). O site da Tecres afirma erradicação acima de 91 % em 56 meses (alegação do fabricante).
- Fontes: [Tecres Spacer-S](https://www.tecres.com/product_details/spacer-s) ·
  [IFU InterSpace Shoulder (OsteoRemedies)](https://osteoremedies.com/wp-content/uploads/2024/01/OST008-Rev-00-01-2024_InterSpace-Shoulder-IFU.pdf) ·
  [K112983](https://www.accessdata.fda.gov/cdrh_docs/pdf11/K112983.pdf) · [Coffey 2010, PMID 20392651](https://pubmed.ncbi.nlm.nih.gov/20392651/) ·
  [Magnan 2014, PMID 23670275](https://pubmed.ncbi.nlm.nih.gov/23670275/)

### 1.2 OsteoRemedies REMEDY Shoulder Spacer (EUA)

- **O que é:** espaçador **modular** pré-formado: a cabeça é **rosqueada** no munhão da haste, e a rosca ajusta offset e altura em até 9 mm.
  PMMA com gentamicina. **Só a haste tem alma de aço inox** (AISI 316 ESR, segundo o 510(k)).
- **Tamanhos (ficha MKT020, 2019, cotas numeradas do desenho):**

  | Peça | Catálogo | Ø cabeça (1) | Altura cabeça (2) | Comprimento (3) | Ø distal (4) | ML prox. (5) | AP prox. (6) | Colo (7) | Munhão/rosca (8) | Gentamicina |
  |---|---|---|---|---|---|---|---|---|---|---|
  | Cabeça 40 | RSHHSM | 40 | 25 | | | | | | | 0,5 g |
  | Cabeça 45 | RSHHMD | 45 | 25 | | | | | | | 0,5 g |
  | Cabeça 50 | RSHHLG | 50 | 25 | | | | | | | 0,6 g |
  | Haste S | RSHSSM | | | 101 | 7 | 9,4 | 7,8 | 19 | 9 | 0,1 g |
  | Haste M | RSHSMD | | | 116 | 10,5 | 12,6 | 10,5 | 19 | 9 | 0,3 g |
  | Haste L | RSHSLG | | | 131 | 14 | 15,8 | 14 | 19 | 9 | 0,5 g |

  O 510(k) K152267 confirma: cabeças de 40, 45 e 50 mm, hastes 101/7, 116/10,5 e 131/14, **ângulo haste–colo de 130°** e alma de aço só na haste.
  Da Silva 2025 relata **2,8 % de gentamicina em peso**, ou 0,8 g por espaçador.
- **Técnica:** molhar a rosca da cabeça com o monômero e rosqueá-la até passar a "linha de segurança".
  **O cimento na parte proximal da haste é obrigatório**, para evitar rotação, luxação e soltura. O kit tem provas em Radel (PPSU).
- **Clínica (Da Silva 2025, Utah, 55 ombros e 53 com radiografia):** fratura **3/53 (5,7 %)**, luxação **7/53 (13,2 %)** e soltura 4/53 (7,5 %).
  Houve desgaste superior da glenoide em 13/53. A reinfecção, com definição conservadora, foi de **38,2 %**.
- Fontes: [REMEDY Shoulder](https://osteoremedies.com/remedy-shoulder-system/) ·
  [Ficha técnica MKT020](https://osteoremedies.com/wp-content/uploads/2019/11/WEB-Shoulder-Product-Info_MKT020.pdf) ·
  [Técnica MKT000](https://osteoremedies.com/wp-content/uploads/2019/11/MKT000_Shoulder-Technique.pdf) ·
  [IFU das provas em Radel](https://osteoremedies.com/wp-content/uploads/2025/05/OST152-Rev-05-04-2025_RADEL-SHOULDER-IFU.pdf) ·
  [K152267](https://www.accessdata.fda.gov/cdrh_docs/pdf15/K152267.pdf) · [Da Silva 2025, PMC12490687](https://pmc.ncbi.nlm.nih.gov/articles/PMC12490687/)

### 1.3 Synimed SYNICEM Shoulder (França; distribuído pela Biocomposites; 510(k) K242865 de 2025)

- **O que é:** hemiartroplastia pré-formada com **alma de aço inox 316L**, gentamicina e cabeça "perfeitamente esférica e polida".
  Tem **pontos de ancoragem para sutura** do manguito. O distribuidor francês descreve o perfil como "NEER" (arredondado).
- **Tamanhos:** **40H** com cabeça de 40 mm, haste de 120 mm e 1,0 g de gentamicina (código 885446).
  **48H** com cabeça de 48 mm, haste de 120 mm e 1,5 g de gentamicina (885447). O conteúdo varia ±5 %. Há bandeja de provas reutilizável (882052).
- **Clínica específica de ombro:** nenhuma série encontrada (NÃO VERIFICADO).
- Fontes: [Folheto EUA MA0500R1 (2025)](https://smithbucklin.expocad.com/Events/25aahks/ex/T0000020/docs/USA%20Synicem%20spacer%20brochure%20MA0500R1.pdf) ·
  [Biocomposites](https://biocomposites.com/our-products/synicem-spacers/synicem-shoulder-spacer/) ·
  [Prothys (FR)](https://www.prothys.com/product/spacer-d-epaule-synicem/) · GUDID via [openFDA UDI](https://api.fda.gov/device/udi.json?search=brand_name:%22SYNICEM%22)

### 1.4 G21 SpaceFix Shoulder = Arthrex CeMend Shoulder Spacer (pré-moldado)

- **O que é:** a versão **pré-moldada de fábrica** do SpaceFlex. Leva cimento G3A com gentamicina e **núcleo de aço inox AISI 316LVM**, o mesmo do SpaceFlex.
  O sumário 510(k) **K252443** (15/09/2025) diz que existem **4 tamanhos** (combinações de Ø da haste, Ø da cabeça e comprimento da haste).
- O GUDID lista as referências **AR-902-0842, -1042, -1048 e -1248** como "CeMend Shoulder Spacer", com a G21 SRL como fabricante.
  A leitura "Ø da haste–Ø da cabeça" (8/42, 10/42, 10/48, 12/48) é minha inferência pela nomenclatura dos moldes (seção 2.2): NÃO VERIFICADO.
- **Clínica:** nenhuma (produto novo).
- Fontes: [K252443](https://www.accessdata.fda.gov/cdrh_docs/pdf25/K252443.pdf) · [openFDA UDI "CeMend"](https://api.fda.gov/device/udi.json?search=brand_name:%22CeMend%22&limit=100)

---

## 2. KITS DE MOLDE intraoperatório de ombro

### 2.1 Zimmer Biomet StageOne Shoulder Cement Spacer Molds (EUA)

- **Material:** silicone de grau médico, descartável e estéril. **Não tem núcleo metálico.**
  O 510(k) K131135 registra textualmente que o InterSpace tem reforço de aço e o StageOne não.
  Mesmo assim, o StageOne foi julgado equivalente ao InterSpace em fadiga, resistência estática e eluição de gentamicina.
- **Tamanhos (folheto 5426.1, 2025).** Os tamanhos seguem a haste padrão do Comprehensive:

  | Código | Haste | Cabeça (como o folheto escreve) | Nº de misturas de 40 g |
  |---|---|---|---|
  | 431406 | 6 mm | 42 × 18 × 46 | 1 |
  | 431408 | 8 mm | 46 × 18 × 53 | 2 |
  | 431410 | 10 mm | 50 × 21 × 57 | 2 |
  | 431412 | 12 mm | 54 × 21 × 64 | 2 |
  | 431414 | 14 mm | 58 × 24 × 64 | 2 |

  Um revendedor descreve a haste como "Standard Stem (122 mm)".
  O primeiro número deve ser o Ø da cabeça e o segundo a altura, como nas cabeças Comprehensive. **O significado do 3º número (46–64) é NÃO VERIFICADO.**
- **Recursos:** porta rosqueada para encaixar a pistola de cimento, textura com covinhas ("dimpled") para aumentar a área de eluição, gabarito radiográfico XRAY000256.
- **Cimento:** Cobalt HV G em 2013; Palacos R+G ou Refobacin R a partir de 2016 (K160071); só Refobacin Bone Cement R a partir de 2022 (K221968).
- **Preço público:** US$ 9.836,99 pelo 431408 (revendedor Grayline). Não se sabe se é o preço praticado pela Zimmer.
- Fontes: [Folheto StageOne Shoulder](https://www.zimmerbiomet.com/content/dam/zb-corporate/en/products/specialties/cement/stageone-cement-spacer-molds/5426.1-US-en%20StageOne%20Shoulder%20Brochure%20fin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) ·
  [K131135](https://www.accessdata.fda.gov/cdrh_docs/pdf13/K131135.pdf) · [K160071](https://www.accessdata.fda.gov/cdrh_docs/pdf16/K160071.pdf) ·
  [K221968](https://www.accessdata.fda.gov/cdrh_docs/pdf22/K221968.pdf) ·
  [Grayline 431408](https://www.graylinemedical.com/products/zimmer-biomet-stageone-shoulder-cement-spacer-mold-8-mm-standard-stem-122-mm-shoulder-mold-with-46-mm-x-18-mm-x-53-mm-head-4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)

### 2.2 G21 SpaceFlex Shoulder = Arthrex CeMend Shoulder Spacer Mold (Itália/EUA) — o mais próximo do nosso conceito

- **O que é:** "**duas meias-moldes plásticas e uma haste de aço inox com dois pinos de centragem**", preenchidas com PMMA de baixa viscosidade.
  A descrição é do guia de reembolso da Arthrex, que cita o 510(k) **K202338** do SpaceFlex.
  O kit reutilizável traz base de molde, prensas de inserção por tamanho, parafuso de compressão da base, insertos de cabeça de 42 e 48 mm, raspa e alicate.
  O GUDID registra a **G21 SRL como fabricante do CeMend**, o que confirma que CeMend é a marca Arthrex do SpaceFlex.
- **Tamanhos:** hastes de 8, 10, 12 e 14 mm. Cabeças de **42 mm (offset 15)** e **48 mm (offset 18)**. Comprimentos de haste de 90 a 170 mm, de 10 em 10.
  O fabricante fala em 46 configurações. Os moldes descartáveis são 900001 08 42 15, 10 42 15, 10 48 18, 12 42 15, 12 48 18 e 14 48 18; o kit reutilizável é o 900012.
  A CeMend tem ainda fresas de 8, 10, 12 e 14 mm.
- **Cimento:** só G3A de baixa viscosidade com gentamicina (Arthrex Bone Cement MVG). O fabricante diz que o espaçador fica pronto em 15 min.
- **Testes do 510(k):** fadiga, dimensional, usabilidade e eluição, com equivalência ao InterSpace (K112983).
- **Clínica:** Porcellini e colaboradores (Forlì/Modena) compararam "modular tailored preformed" (n = 35) com "hand-made" (n = 13).
  Tiveram 2 fraturas (1 em cada grupo) e 2 luxações, e Constant de 34 × 20. Que o espaçador modular seja o SpaceFlex é **inferência NÃO VERIFICADA**.
- Fontes: [G21 SpaceFlex](https://www.g-21.it/en/product/orthopedic-spaceflex-modular-spacers/) · [K202338](https://www.accessdata.fda.gov/cdrh_docs/pdf20/K202338.pdf) ·
  [Arthrex AR-902-S](https://www.arthrex.com/products/AR-902-S) ·
  [Guia de reembolso CeMend 2026](https://www.arthrex.com/resources/DOC1-002153-en-US/cemend-shoulder-spacer-mold-2026-coding-and-reimbursement-guidelines) ·
  [Osteotec (UK)](https://osteotec.com/product/spaceflex-shoulder/) · [Porcellini, Bone & Joint 2022](https://boneandjoint.org.uk/Article/10.1302/1358-992X.2022.10.046) ·
  [Semin Arthroplasty 2023 (resumo)](https://www.sciencedirect.com/science/article/abs/pii/S1045452723000421)

### 2.3 Osartis Shoulder Spacer Molds (Alemanha; grupo Tecres) — 510(k) K240856 (20/11/2024)

- Moldes estéreis e descartáveis, com **hastes de reforço em aço inox, centralizadores e insertos de cabeça**. O sistema é modular e usa o cimento Cemex Genta LV.
  Detalhe relevante para nós: na biocompatibilidade, o molde de ombro foi classificado como **"implant device" em contato indireto por mais de 30 dias (categoria C)**.
  Tamanhos e material do molde: NÃO VERIFICADO. O site da Osartis não mostra o produto.
- Fonte: [K240856](https://www.accessdata.fda.gov/cdrh_docs/pdf24/K240856.pdf)

### 2.4 Wright Medical/Tornier (hoje Stryker): moldes "Aequalis Ascend Flex Convertible Shoulder System"

- Klosterman 2021 (o artigo-base) usou "commercially available proximal humerus antibiotic spacer molds (Aequalis Ascend Flex … Molds; Wright Medical)".
  O artigo cita 4 tamanhos de haste (2, 4, 6, 8) e 3 cabeças: **43 × 16, 48 × 18 e 52 × 23 mm**.
  A parte distal é feita com dreno de tórax (Argyle) e guia de fresagem de 2,5 mm (DePuy Synthes) como alma.
- As técnicas cirúrgicas do Ascend Flex e do Tornier Flex que baixei não mencionam molde de espaçador.
  **Não há 510(k) de "shoulder spacer mold" da Wright/Tornier/Stryker no openFDA.**
  O status comercial atual e o material (metal ou silicone) são NÃO VERIFICADOS. Pode ser instrumental reutilizável fora da lista de 510(k).
- Fonte: [Klosterman 2021, PMC7917196](https://pmc.ncbi.nlm.nih.gov/articles/PMC7917196/)

### 2.5 Fabricantes pedidos sem produto de OMBRO encontrado

| Empresa | O que achei | Ombro? |
|---|---|---|
| Heraeus Medical | COPAL knee moulds, COPAL exchange G (quadril e joelho pré-formados), cimento COPAL spacem | Nenhum produto. **Há patentes que cobrem molde de ombro** (seção 7) |
| implantcast | Moldes de silicone Cempadic para quadril e joelho | Não encontrado |
| LimaCorporate | — | Não encontrado |
| DePuy Synthes | PROSTALAC é sistema de quadril e joelho. O "PROSTALAC de ombro" da literatura é montagem feita à mão (seção 3.1) | Não encontrado |
| Stryker | Só os moldes Ascend Flex da Wright citados em 2021 (seção 2.4) | NÃO VERIFICADO |
| Exactech | Distribuiu o InterSpace da Tecres nos EUA | Sem produto próprio |
| Arthrex | CeMend = G21 SpaceFlex/SpaceFix | Sim (seções 1.4 e 2.2) |

Fontes: [Heraeus COPAL](https://www.heraeus-medical.com/en/healthcare-professionals/brands/copal/) ·
[implantcast Cempadic](https://www.implantcast.de/en/medical-professionals/products/additional-products-/-miscellaneous/cempadicr-cement-spacer-knee/) ·
[Exactech op. technique (link morto hoje, listado em busca)](https://www.exac.com/wp-content/uploads/2021/12/715-06-30_Rev_F_InterSpace_Hip_Knee_Shoulder_Operative_Technique_Web.pdf)

**Atenção, "InSpace":** o InSpace™ (Ortho-Space/Stryker) é um **balão subacromial biodegradável** para lesão maciça do manguito, não um espaçador antibiótico.
O GUDID o lista como "shoulder spacer" só por causa do nome. Fonte: [protocolo NCT02493660](https://cdn.clinicaltrials.gov/large-docs/60/NCT02493660/Prot_SAP_000.pdf).

---

## 3. Técnicas feitas à mão e espaçadores com prótese

| Técnica | Como é feita | Dados | Fonte |
|---|---|---|---|
| **PROSTALAC de ombro (MGH/Warner)** | Molde hemisférico de 44 mm (custom) + **placa LC-DCP 3,5 dobrada a ~125°**. Na variante, um tubo de cultura estéril recheado de cimento reveste a haste. Antibióticos por pacote de 40 g: 2 g gentamicina + 3 g tobramicina + 1 g vancomicina | Jawa 2011: 28 pacientes, 9 complicações em 8 (29 %): **1 luxação e 3 fraturas**. **As 3 fraturas foram com placa um-terço tubular**, e a equipe trocou para LC-DCP | [Spang 2015 (PDF)](https://orthojournalhms.org/16/pdfs/volume16_107_111.pdf) · [Jawa 2011, JBJS](https://journals.lww.com/jbjsjournal/abstract/2011/11020/prosthesis_of_antibiotic_loaded_acrylic_cement.7.aspx) |
| **Klosterman (UW)** | Molde comercial proximal (Ascend Flex) + dreno de tórax para a haste de comprimento sob medida + alma de 2,5 mm. Palacos com 4 g vancomicina + 7,2 g tobramicina para 2 pacotes | Nota técnica, sem série | [PMC7917196](https://pmc.ncbi.nlm.nih.gov/articles/PMC7917196/) |
| **Frankenspacer (Utah)** | Cabeça pré-formada REMEDY (40/45/50) + haste intramedular reta, unidas por Steinmann rosqueado a 135°. Corpo proximal de cimento com 1 g ceftazidima + 3 g vancomicina por 40 g | 18 ombros com perda óssea umeral: **luxação 56 %**, erosão glenoidal 83 %, soltura 11 %, **nenhuma fratura** | [PMC12573618](https://pmc.ncbi.nlm.nih.gov/articles/PMC12573618/) |
| **Haste de Rush + cimento (Minnesota)** | Rush rod central e cimento com vancomicina moldado à mão. Cabeça dimensionada "sem overstuffing" | 5 casos, sem taxas | [PMC13332471](https://pmc.ncbi.nlm.nih.gov/articles/PMC13332471/) |
| **Molde anatômico intraoperatório (Mayo)** | Molde anatômico; marca NÃO VERIFICADA no resumo | 27 ombros; erradicação de 85 %. Houve **instabilidade rotacional em 3** com perda óssea proximal (o resumo diz "4 %", o que não bate com 3/27 = 11 %) | [Aibinder 2019, PMID 31323104](https://pubmed.ncbi.nlm.nih.gov/31323104/) |
| **Molde de silicone caseiro (Vietnã)** | Silicone de adição moldado sobre a prótese retirada e esterilizado com óxido de etileno. Casos de joelho | 3 casos, sem fratura ou luxação | [SICOT-J 2023](https://doi.org/10.1051/sicotj/2023032) |
| **Molde impresso em 3D** | Silicone ou molde impresso a partir de CAD/TC. Publicado em joelho, quadril, rádio e ulna, **não achei em ombro** | Quadril: 20 × 20 pacientes, Harris Hip Score melhor no grupo 3D | [Zhang 2024, PMID 38163551](https://pubmed.ncbi.nlm.nih.gov/38163551/) · [Kong 2021, PMC7884112](https://pmc.ncbi.nlm.nih.gov/articles/PMC7884112/) · [Exner 2021, PMID 34019491](https://pubmed.ncbi.nlm.nih.gov/34019491/) |
| **Espaçador "paciente-específico" de ombro** | Técnica de moldagem sob medida. O método exato (se usa impressão 3D) é NÃO VERIFICADO; só o resumo está disponível | Técnica, sem série | [List 2023, PMID 37133809](https://pubmed.ncbi.nlm.nih.gov/37133809/) |
| **"Functional composite spacer" (hemiartroplastia metálica com cimento só na haste)** | Haste fina + cabeça metálica, com Simplex P + tobramicina + vancomicina em volta da haste, sem cimentar no osso | Levy 2015: 9 mantidos, sem migração. Schodlbauer 2025: 13 com ≥ 5 anos, 0 reinfecção, 2/13 reoperados. Healio 2020: 31 pacientes, 74 % evitaram o 2º tempo | [PMID 26091225](https://pubmed.ncbi.nlm.nih.gov/26091225/) · [PMID 39089416](https://pubmed.ncbi.nlm.nih.gov/39089416/) · [Healio](https://www.healio.com/news/orthopedics/20201111/functional-antibiotic-spacer-can-be-used-to-treat-shoulder-prosthetic-joint-infection) |
| **Pirocarbono como espaçador (PISA/InSpyre)** | Esfera de pirocarbono interposta, sem cimento | 15 pacientes, 0 reinfecção em 55 meses | [PMC10837719](https://pmc.ncbi.nlm.nih.gov/articles/PMC10837719/) |

---

## 4. Taxas publicadas de fratura e luxação por tipo

Poucas séries identificam a marca. Onde o resumo não diz qual espaçador foi usado, marquei como NÃO VERIFICADO.

| Estudo | Tipo / marca | n | Fratura do espaçador | Luxação | Outras falhas mecânicas | Reinfecção |
|---|---|---|---|---|---|---|
| Alessio-Mazzola 2020, revisão sistemática (espaçadores permanentes) | 55 % comerciais (InterSpace e outros), 38 % feitos à mão, 6 % hemiartroplastia com cimento | 143 | **8 (5,6 %)** | **1** (o artigo imprime "0,1 %"; 1/143 = 0,7 %) | Fratura periprotética 3 (2,1 %) | 7,0 % |
| McFarland 2018 (Johns Hopkins) | "Comercialmente disponíveis"; marca NÃO VERIFICADA no resumo | 60 espaçadores, 50 revisados | **4** | não relatada no resumo | Erosão 8 (6 glenoide, 2 diáfise), **rotação 3**, fratura umeral 3 | — |
| Da Silva 2025 (Utah) | REMEDY (OsteoRemedies) | 53 | **3 (5,7 %)** | **7 (13,2 %)** | Soltura 4 (7,5 %) | 38,2 % (definição conservadora) |
| Beady 2025, Frankenspacer (Utah) | Cabeça REMEDY + haste intramedular | 18 | **0** | **10 (56 %)** | Erosão glenoidal 83 %, soltura 11 % | 16,7 % |
| Jawa 2011, PROSTALAC ombro | Feito à mão, molde de cabeça + placa | 28 | **3** (todas com placa um-terço tubular) | 1 | — | 5 reoperados por infecção |
| Porcellini 2022/2023 | Pré-formado modular (marca NÃO VERIFICADA) × feito à mão | 35 × 13 | 1 × 1 | 2 no total | — | — |
| Aibinder 2019 (Mayo) | Molde anatômico intraoperatório | 27 | não relatada | não relatada | Instabilidade rotacional 3 | 15 % |
| Themistocleous 2007 / Stine 2010 (USC) | Feito à mão | 11 / 30 | 0 (2007) / não relatada | — | — | 9/11 livres de infecção / 30/30 erradicados |
| Padegimas 2017 | Com haste × sem haste | 37 | não relatada | — | Paralisias nervosas | — |

Referência cruzada de quadril (não é ombro): Emmer 2023 viu que os espaçadores **pré-fabricados luxaram mais**
(10 × 6) e **quebraram menos** (0 × 4) que os feitos sob medida ([PMID 37750259](https://pubmed.ncbi.nlm.nih.gov/37750259/)).

Outros dados de contexto:
- **Mortalidade** com espaçador permanente: 52,9 % (9/17) em ≥ 2 anos ([Rondon 2021, PMID 34087272](https://pubmed.ncbi.nlm.nih.gov/34087272/)).
- Espaçador permanente × artroplastia de ressecção: erradicação de 85 % × 82 %, com função melhor no espaçador ([Xiao 2022, PMID 34774777](https://pubmed.ncbi.nlm.nih.gov/34774777/)).

Fontes: [Alessio-Mazzola, PMC7534885](https://pmc.ncbi.nlm.nih.gov/articles/PMC7534885/) ·
[McFarland, PMID 29778591](https://pubmed.ncbi.nlm.nih.gov/29778591/) · [Jawa, Semantic Scholar](https://www.semanticscholar.org/paper/Prosthesis-of-antibiotic-loaded-acrylic-cement-use-Jawa-Shi/1617884fbfd420da08f1ca71024be2fa1097fe8b) ·
[Themistocleous, PMID 17931905](https://pubmed.ncbi.nlm.nih.gov/17931905/) · [Stine, PMID 20137977](https://pubmed.ncbi.nlm.nih.gov/20137977/) ·
[Padegimas, PMID 29201302](https://pubmed.ncbi.nlm.nih.gov/29201302/) · [Pellegrini 2018, PMID 29335894](https://pubmed.ncbi.nlm.nih.gov/29335894/)

---

## 5. Comparação das abordagens

| | **Pré-formado** (InterSpace, REMEDY, SYNICEM, SpaceFix/CeMend) | **Kit de molde** (StageOne, SpaceFlex/CeMend, Osartis) | **Feito à mão** (bola de cimento, Rush/Steinmann, placa, dreno de tórax) | **Com prótese** (hemiartroplastia com cimento na haste; PROSTALAC-like; pirocarbono) |
|---|---|---|---|---|
| Geometria | Fixa, 2 a 3 tamanhos (REMEDY é modular: 3 × 3) | 5 a 46 configurações | Livre, depende do cirurgião | A da prótese |
| Cabeça (Ø) | 40–50 mm | 42–58 mm (StageOne); 42/48 (SpaceFlex) | Qualquer (44 mm no PROSTALAC do MGH) | A da prótese |
| Alma metálica | Sim, aço inox em todos | StageOne não; SpaceFlex, CeMend e Osartis sim | Improvisada (Steinmann, Rush, placa, guia de fresagem) | A haste metálica |
| Antibiótico | **Fixo: só gentamicina** (0,4–1,5 g; 1,87–2,8 %). O IFU da Tecres proíbe acrescentar antibiótico | Escolhido pelo cirurgião, mas o 510(k) limita o cimento (Refobacin, G3A, Cemex Genta LV) | Livre (vancomicina, tobramicina, gentamicina, ceftazidima) | Livre, na camada da haste |
| Tempo intraoperatório | ~1 min, segundo o fabricante | ~15 min (SpaceFlex) | ~14–16 min em quadril e joelho (Moerenhout) | Semelhante a uma hemiartroplastia |
| Uniformidade mecânica | Alta, controlada em fábrica | Intermediária | Baixa: depende da mistura, da porosidade e da alma | Alta (metal) |
| Custo | Alto; preço não público | Alto (um molde a US$ 9.836,99 no revendedor) | O mais barato: ≥ 40–50 % menos em quadril e joelho | Custo de uma prótese nova |
| Falha típica | Luxação (REMEDY 13 %), rotação | Rotação; fratura se não houver alma | Fratura com alma fraca (placa 1/3 tubular) | Pouca falha mecânica; o metal fica em contato com a glenoide |
| Regulatório | 510(k) classe II como prótese de ombro com cimento (KWS/HSD/MBB) | 510(k) classe II (MBB) com testes de fadiga e eluição comparados ao InterSpace | Uso do cimento fora do rótulo, sob responsabilidade do cirurgião | Uso fora do rótulo da prótese |

---

## 6. Preços públicos

- StageOne Shoulder 431408: **US$ 9.836,99** (Grayline Medical, revendedor; data da consulta 25/09/2026). É o único preço de produto de ombro que encontrei.
- InterSpace SPS0021 aparece em marketplaces de excedente (DOTmed, Synergy Surgical), mas **as páginas bloquearam a leitura (403)**: NÃO VERIFICADO.
- REMEDY: a RevMed não mostra preço.
- Custos de referência (quadril e joelho, Suíça): espaçador feito à mão a 450–760 EUR, **pelo menos 40–50 % mais barato** que o pré-formado ou o molde ([Moerenhout 2021, PMID 34808733](https://pubmed.ncbi.nlm.nih.gov/34808733/)).
- O reembolso nos EUA (CPT +20704 e C1602) está no guia da Arthrex. Não há código específico para o espaçador de ombro.

---

## 7. Regulatório e patentes (não é parecer jurídico)

**Todos os moldes comerciais de ombro foram liberados como dispositivo médico classe II nos EUA:**
K131135, K160071 e K221968 (StageOne), K202338 (SpaceFlex), K240856 (Osartis).
Os pré-formados também: K060535, K112983, K152267, K242865 e K252443.
Os testes exigidos se repetem: **fadiga, resistência estática, eluição de gentamicina, biocompatibilidade, esterilização e validade**.
O predicado é sempre o InterSpace (K112983).

**Patentes relevantes para um molde de ombro:**

| Patente | Titular | Validade estimada | O que protege | Relevância para o nosso projeto |
|---|---|---|---|---|
| [US 11,865,006 B2](https://patents.google.com/patent/US11865006B2/en) | Heraeus Medical | ~09/2041 | Molde em 2 partes (**molde de haste + molde de cabeça**) + núcleo metálico com **flange** entre haste e cabeça, que serve de batente para os dois moldes. Cobre ombro explicitamente | O nosso divide em metades **anterior e posterior** e registra por cilindros macho/fêmea, sem flange. É outra arquitetura, mas pede FTO |
| [US 11,998,451 B2](https://patents.google.com/patent/US11998451B2/en) | Heraeus Medical | ~04/2042 | Molde com **válvula rotativa** na abertura de enchimento. Cobre ombro | Evitar válvula rotativa na porta de injeção |
| [US 10,123,877 B2](https://patents.google.com/patent/US10123877B2/en) | Tecres | ~08/2035 | Espaçador de ombro modular que serve em configuração anatômica e reversa | O nosso é monobloco e anatômico |
| [US 7,789,646 B2](https://patents.google.com/patent/US7789646B2/en) | Zimmer | ~12/2028 | Molde de **quadril** com módulos de cabeça intercambiáveis | Não cobre ombro |
| [US 9,937,047 B2](https://patents.google.com/patent/US9937047B2/en) | Zimmer | Expirada (taxa) | Molde modular de quadril e joelho | Livre |

---

## 8. Brasil / ANVISA

- **Não consegui confirmar nenhum espaçador de ombro nem molde de ombro registrado na ANVISA.**
  A consulta pública (consultas.anvisa.gov.br) devolveu bloqueio Cloudflare ao acesso automatizado.
  O download do CSV de dados abertos (`TA_PRODUTO_SAUDE_SITE.csv`) falhou por certificado. Status: **NÃO VERIFICADO**.
- Existe registro ANVISA **81361440028** de "Espaçador Temporário para Joelho" (Víncula/Subiton): PMMA + gentamicina + aço 316L, tamanhos RF58, RF65 e RF79.
  Hip Charnley e Müller também estão no catálogo, mas a Víncula **não lista ombro**.
  Os tamanhos de joelho coincidem com os do SYNICEM (58/65/79). Que a Víncula seja a detentora do registro da Synimed no Brasil é inferência NÃO VERIFICADA.
- O Spacer-S da Tecres aparece em distribuidores da América Latina (Surgicorp, Peru), mas não achei distribuidor no Brasil (NÃO VERIFICADO).
- Como verificar: consultar "espaçador" e "ombro" em https://consultas.anvisa.gov.br (produtos para saúde),
  ou baixar `https://dados.anvisa.gov.br/dados/TA_PRODUTO_SAUDE_SITE.csv` num navegador.

---

## 9. Implicações para o gerador paramétrico (anatômico, só úmero, duas metades A/P)

1. **Faixas dos controles, pelo mercado:**
   - Ø da cabeça de 40 a 58 mm (o StageOne chega a 58 × 24).
   - Altura da cabeça de 16 a 25 mm.
   - Ângulo colo–haste de 130° como padrão (InterSpace e REMEDY).
   - Ø distal do corpo de 7 a 14 mm; ML/AP proximal de 9,4 × 7,8 a 15,8 × 14 mm (REMEDY).
   - Comprimento total pré-formado de 99 a 131 mm.

   Uma "cabeça maior que o normal", como o cirurgião quer, cabe no intervalo que o StageOne já oferece. Não precisa extrapolar além de 58 mm sem motivo clínico.
2. **Prever alma metálica** (Steinmann, Rush ou barra), com canal e **centragem** no molde: pinos ou espigas de centragem (CeMend) e centralizadores (Osartis).
   A literatura é consistente: alma fraca ou ausente acompanha as fraturas. O InterSpace ganhou alma em 2011, e as fraturas do PROSTALAC vieram com a placa um-terço tubular.
   O StageOne sem alma passou no teste de fadiga do FDA, então a alma é recomendável e não obrigatória. **Decisão do cirurgião.**
3. **Arquitetura do molde:** o CeMend confirma que **duas meias-moldes plásticas + alma com pinos de centragem** é um conceito aceito pelo FDA.
   Faltam ao nosso **porta de injeção compatível com o bico da pistola de cimento** (o StageOne tem "threaded port fitment"), **respiros** e **ângulo de saída** para desmoldar.
   **Evitar válvula rotativa** (patente Heraeus US 11,998,451).
4. **Superfície:** a cabeça deve sair **lisa e esférica** (o SYNICEM destaca cabeça "polida" para poupar o osso), e a impressão 3D precisa de acabamento.
   O StageOne usa textura de covinhas **no corpo** para aumentar a eluição. Pode virar uma opção só no corpo, nunca na cabeça.
5. **Estabilidade rotacional:** rotação e instabilidade rotacional aparecem em McFarland, Aibinder e nos IFUs; o REMEDY torna a cimentação proximal obrigatória.
   Como o cirurgião vetou aletas e furos, a seção do corpo proximal **não deve ser circular** (oval ou retangular arredondada, como a ML ≠ AP do REMEDY).
6. **Luxação é a principal falha do espaçador de ombro** (13 % com REMEDY; 56 % com perda óssea).
   Isso reforça poder escolher uma cabeça maior e mais alta. O SYNICEM tem pontos de sutura para o manguito; isso **conflita com a regra "sem furos"**, então fica como opção que o cirurgião decide.
7. **Volume de cimento:** mostrar o volume da cavidade e o número estimado de pacotes de 40 g. Referência: o StageOne pede 1 mistura no tamanho menor e 2 nos demais.
   A conversão de volume para massa precisa da densidade informada pelo fabricante do cimento escolhido. Não inventar esse número.
8. **Antibiótico:** o molde deixa o antibiótico livre. Exemplos da literatura: vancomicina + tobramicina (Klosterman), gentamicina + tobramicina + vancomicina (Spang).
   Carga alta de antibiótico reduz a resistência do cimento: o folheto SYNICEM cita Dunne 2007, **NÃO VERIFICADO** no original. A página deveria deixar esse aviso visível.
9. **Material do molde impresso:** a Osartis classificou o molde de ombro como biocompatibilidade de implante por mais de 30 dias (categoria C).
   Um molde impresso (PLA, PETG, resina) exige material biocompatível e esterilizável, e validação. Isso está fora do escopo do gerador, mas precisa constar como aviso.
10. **Regulatório:** um molde produzido no hospital é dispositivo sob medida. Os comerciais passaram por testes de fadiga, estática e eluição.
    O gerador deve se apresentar como **ferramenta de pesquisa e planejamento**, não como dispositivo liberado.
11. **Não copiar produto comercial:** as dimensões desta nota servem de **faixa de referência**. A geometria sai das entradas paramétricas e da anatomia normal, não de um produto específico.

---

## 10. Perguntas em aberto e itens NÃO VERIFICADOS

- ANVISA: existe algum espaçador pré-formado ou molde de **ombro** registrado no Brasil? Quem é o detentor do registro do SYNICEM e da Tecres no país?
- Significado do 3º número das cabeças do StageOne (42×18×**46** … 58×24×**64**).
- Tamanhos exatos dos 4 SpaceFix/CeMend pré-moldados (a leitura AR-902-0842 = haste 8 / cabeça 42 é inferência).
- Tamanhos e material dos moldes Osartis (K240856) e se já são vendidos.
- Status e material (metal ou silicone) dos moldes Wright/Tornier Ascend Flex usados por Klosterman. O vídeo do artigo mostra um molde metálico de duas metades? A outra pesquisa pode confirmar.
- Marca do espaçador em McFarland 2018 e Pellegrini 2018/2019 (provável Tecres/InterSpace) e em Porcellini (provável SpaceFlex): NÃO VERIFICADO.
- Taxas de fratura e luxação específicas de InterSpace, StageOne, SYNICEM e SpaceFlex. Não existe série comparativa entre marcas de ombro.
- Preços reais do InterSpace, REMEDY, SYNICEM, CeMend e SpaceFlex no Brasil e nos EUA.
- FTO formal sobre as patentes Heraeus (US 11,865,006; US 11,998,451) e Tecres (US 10,123,877) antes de qualquer distribuição do gerador ou dos moldes.

---

## Referências (URLs)

Produtos e regulatório
- Tecres Spacer-S — https://www.tecres.com/product_details/spacer-s
- InterSpace Shoulder IFU (OsteoRemedies OST008, 2024) — https://osteoremedies.com/wp-content/uploads/2024/01/OST008-Rev-00-01-2024_InterSpace-Shoulder-IFU.pdf
- FDA K060535 / K112983 (Tecres) — https://www.accessdata.fda.gov/cdrh_docs/pdf11/K112983.pdf
- REMEDY Shoulder — https://osteoremedies.com/remedy-shoulder-system/ ; ficha https://osteoremedies.com/wp-content/uploads/2019/11/WEB-Shoulder-Product-Info_MKT020.pdf ; técnica https://osteoremedies.com/wp-content/uploads/2019/11/MKT000_Shoulder-Technique.pdf
- FDA K152267 (REMEDY) — https://www.accessdata.fda.gov/cdrh_docs/pdf15/K152267.pdf
- SYNICEM (folheto EUA 2025) — https://smithbucklin.expocad.com/Events/25aahks/ex/T0000020/docs/USA%20Synicem%20spacer%20brochure%20MA0500R1.pdf ; https://biocomposites.com/our-products/synicem-spacers/synicem-shoulder-spacer/
- FDA K242865 (SYNICEM) — https://www.accessdata.fda.gov/cdrh_docs/pdf24/K242865.pdf
- G21 SpaceFlex — https://www.g-21.it/en/product/orthopedic-spaceflex-modular-spacers/ ; FDA K202338 https://www.accessdata.fda.gov/cdrh_docs/pdf20/K202338.pdf
- G21 SpaceFix — FDA K252443 https://www.accessdata.fda.gov/cdrh_docs/pdf25/K252443.pdf
- Arthrex CeMend — https://www.arthrex.com/products/AR-902-S ; https://www.arthrex.com/resources/DOC1-002153-en-US/cemend-shoulder-spacer-mold-2026-coding-and-reimbursement-guidelines
- openFDA UDI (GUDID) — https://api.fda.gov/device/udi.json?search=brand_name:%22CeMend%22&limit=100
- openFDA 510(k) — https://api.fda.gov/device/510k.json?search=device_name:shoulder+AND+device_name:spacer&limit=50
- Zimmer Biomet StageOne Shoulder — https://www.zimmerbiomet.com/content/dam/zb-corporate/en/products/specialties/cement/stageone-cement-spacer-molds/5426.1-US-en%20StageOne%20Shoulder%20Brochure%20fin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 ; K131135 https://www.accessdata.fda.gov/cdrh_docs/pdf13/K131135.pdf ; K160071 https://www.accessdata.fda.gov/cdrh_docs/pdf16/K160071.pdf ; K221968 https://www.accessdata.fda.gov/cdrh_docs/pdf22/K221968.pdf
- Grayline (preço StageOne 431408) — https://www.graylinemedical.com/products/zimmer-biomet-stageone-shoulder-cement-spacer-mold-8-mm-standard-stem-122-mm-shoulder-mold-with-46-mm-x-18-mm-x-53-mm-head-4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
- Osartis K240856 — https://www.accessdata.fda.gov/cdrh_docs/pdf24/K240856.pdf
- implantcast Cempadic — https://www.implantcast.de/en/medical-professionals/products/additional-products-/-miscellaneous/cempadicr-cement-spacer-knee/
- Heraeus COPAL — https://www.heraeus-medical.com/en/healthcare-professionals/brands/copal/
- Víncula (joelho, ANVISA 81361440028) — https://vincula.com.br/loja/product/espacador-temporario-para-joelho/
- Surgicorp (Tecres, Peru) — https://surgicorperu.com/productos/espaciador-de-hombro/
- Patentes: US11865006B2 https://patents.google.com/patent/US11865006B2/en ; US11998451B2 https://patents.google.com/patent/US11998451B2/en ; US10123877B2 https://patents.google.com/patent/US10123877B2/en ; US7789646B2 https://patents.google.com/patent/US7789646B2/en ; US9937047B2 https://patents.google.com/patent/US9937047B2/en

Literatura clínica e técnica
- Klosterman 2021 — https://pmc.ncbi.nlm.nih.gov/articles/PMC7917196/
- Spang/Warner 2015 (PROSTALAC de ombro) — https://orthojournalhms.org/16/pdfs/volume16_107_111.pdf
- Jawa 2011 — https://journals.lww.com/jbjsjournal/abstract/2011/11020/prosthesis_of_antibiotic_loaded_acrylic_cement.7.aspx
- Alessio-Mazzola 2020 (revisão sistemática) — https://pmc.ncbi.nlm.nih.gov/articles/PMC7534885/
- McFarland 2018 — https://pubmed.ncbi.nlm.nih.gov/29778591/
- Da Silva 2025 (REMEDY) — https://pmc.ncbi.nlm.nih.gov/articles/PMC12490687/
- Beady 2025 (Frankenspacer) — https://pmc.ncbi.nlm.nih.gov/articles/PMC12573618/
- Adan 2026 (custom com Rush rod) — https://pmc.ncbi.nlm.nih.gov/articles/PMC13332471/
- Porcellini (pré-formado modular × feito à mão) — https://boneandjoint.org.uk/Article/10.1302/1358-992X.2022.10.046 ; https://www.sciencedirect.com/science/article/abs/pii/S1045452723000421
- Coffey 2010 — https://pubmed.ncbi.nlm.nih.gov/20392651/
- Magnan 2014 — https://pubmed.ncbi.nlm.nih.gov/23670275/
- Aibinder 2019 — https://pubmed.ncbi.nlm.nih.gov/31323104/
- Stine 2010 — https://pubmed.ncbi.nlm.nih.gov/20137977/ ; Themistocleous 2007 — https://pubmed.ncbi.nlm.nih.gov/17931905/
- Padegimas 2017 (com × sem haste) — https://pubmed.ncbi.nlm.nih.gov/29201302/
- Pellegrini 2018/2019 (espaçador permanente) — https://pubmed.ncbi.nlm.nih.gov/29335894/ ; https://pubmed.ncbi.nlm.nih.gov/30497888/
- Levy 2015 / Schodlbauer 2025 (functional composite spacer) — https://pubmed.ncbi.nlm.nih.gov/26091225/ ; https://pubmed.ncbi.nlm.nih.gov/39089416/
- Barret & Boileau 2024 (pirocarbono) — https://pmc.ncbi.nlm.nih.gov/articles/PMC10837719/
- Rondon 2021 (mortalidade) — https://pubmed.ncbi.nlm.nih.gov/34087272/ ; Xiao 2022 — https://pubmed.ncbi.nlm.nih.gov/34774777/
- Namdari 2022 (revisão JAAOS, só resumo) — https://pubmed.ncbi.nlm.nih.gov/35452429/
- Moerenhout 2021 (custo) — https://pubmed.ncbi.nlm.nih.gov/34808733/
- Emmer 2023 (quadril, pré-fabricado × sob medida) — https://pubmed.ncbi.nlm.nih.gov/37750259/
- Moldes 3D / silicone: SICOT-J 2023 https://doi.org/10.1051/sicotj/2023032 ; Zhang 2024 https://pubmed.ncbi.nlm.nih.gov/38163551/ ; Kong 2021 https://pmc.ncbi.nlm.nih.gov/articles/PMC7884112/ ; Exner 2021 https://pubmed.ncbi.nlm.nih.gov/34019491/ ; List 2023 https://pubmed.ncbi.nlm.nih.gov/37133809/
- InSpace (balão subacromial, não é espaçador antibiótico) — https://cdn.clinicaltrials.gov/large-docs/60/NCT02493660/Prot_SAP_000.pdf
