bgobbato/spacer_shoulder/research/04_requisitos_clinicos.md

# 04 — Requisitos clínicos do espaçador umeral de cimento com antibiótico

Pesquisa de apoio ao gerador de moldes (fase 1: corpo proximal + cabeça, molde em duas metades
anterior/posterior; haste distal pela técnica do dreno de tórax). Escopo travado pelo cirurgião:
espaçador **só umeral**, tuberosidades **presentes**, forma de **prótese anatômica** (haste
intramedular abaixo do plano de ressecção do colo anatômico + uma cabeça lisa em calota esférica,
unidas por um colo de cimento robusto, sem cone Morse).

Convenções deste documento:
- Cada número vem com a fonte (URL na seção 16). Quando li só o resumo, está dito.
- **NÃO VERIFICADO** = não consegui confirmar na fonte primária, ou é inferência minha.
- "Cálculo próprio" = conta geométrica feita aqui, não vem de artigo.
- Nomes comerciais aparecem só como **referência de tamanho/prática publicada**; o gerador não deve
  copiar a forma de nenhum produto.

---

## 0. Resumo executivo (o que muda no desenho)

1. **Cabeça**: a literatura de espaçador escolhe a cabeça por **prova no glenoide** ("o tamanho que
   preenche a cavidade", Frankenspacer) ou "aproximar a tensão nativa **sem overstuffing**" (Adan 2026).
   Não achei **nenhum** estudo que defina quanto maior do que o anatômico a cabeça de um espaçador deve
   ser. Os espaçadores comerciais/moldes publicados vão de **40 a 58 mm** de diâmetro; o úmero normal
   (Hertel, p10–p90) tem raio frontal 21–26,5 mm (diâmetro ≈ 42–53 mm). Cabeça maior = menos translação
   e mais estabilidade, mas menos arco de movimento (Harryman 1995, Blevins 1998) e cabeça alta em
   relação à tuberosidade maior tira abdução (Nyffeler 2004). → **parâmetro livre, com alerta
   quando sair da faixa normativa**.
2. **Complicações mecânicas que o molde pode mitigar**: fratura do espaçador (≈4–11% nas séries),
   rotação do espaçador no canal (3/50; 3/27 com perda óssea proximal), luxação (0,7–56% conforme
   perda óssea e manguito), erosão glenoidal (12–83%), fratura umeral na implantação (7,3%) e na
   remoção (cimento distal retido).
3. **Reforço metálico central** é quase universal nos espaçadores feitos à mão/molde publicados
   (fio-guia 2,5 mm com ponta em bola, Steinmann 2,4 mm, Steinmann rosqueado + haste, Rush rod,
   placa LC-DCP). Placa 1/3 tubular: todas as 3 fraturas de Jawa 2011. → o molde precisa de um
   **canal para a haste metálica** que atravesse corpo, colo e entre na cabeça.
4. **Haste lisa, cônica, sem furos/aletas, "solta" no canal** (colocada frouxa ou press-fit leve);
   o controle rotacional vem do **corpo proximal não circular** encaixado na metáfise (e, se o
   cirurgião quiser, de uma camada de cimento pastoso só no proximal — a REMEDY diz que é
   "compulsório" para evitar rotação). Remoção no 2º tempo deve ser "bater e sair" (Frankenspacer).
5. **Antibiótico**: "dose alta" = ≥3,6 g de antibiótico por 40 g de PMMA, com ≥2 g de vancomicina;
   não passar de ~8 g/40 g (resistência cai). Receita de Klosterman: **3,6 g tobramicina + 2,0 g
   vancomicina por pacote de Palacos**. Toda formulação com vancomicina adicionada cai abaixo de
   50 MPa de flexão em 6 semanas (Lunz 2022) → **seções robustas**.
6. **Volume**: moldes comerciais de ombro pedem **1–2 pacotes de 40 g**; Klosterman usa 2 (planejar 3
   na primeira vez). 1 pacote de Palacos R+G curado pesa **57 g**. O gerador deve calcular o volume
   da peça e propor o número de pacotes.
7. **Cura/desmoldagem**: Klosterman ~**16 min** (monômero gelado); molde de silicone de joelho
   8–10 min. Espessura grande (cabeça de 45–55 mm) esquenta muito mais (pico varia ~75 °C entre
   6 mm e 40 mm de espessura em molde de PTFE, Li 2004) → material do molde precisa aguentar a
   exotermia; testar com termopar. Desmoldante: **óleo mineral** é "crucial" (Klosterman).
8. **Furos de sutura**: não achei literatura de espaçador de ombro que use furos no espaçador para
   tuberosidade/manguito. Com tuberosidades preservadas (fator de bom prognóstico, Verhelst 2011),
   o reparo do subescapular é osso-osso. → **sem furos por padrão** (coerente com "robusto").

---

## 1. Papel do espaçador e tempo de permanência

- ICM 2018 (Garrigues et al., JSES 2019, seção de ombro): o espaçador com cimento e antibiótico
  "pode ser usado" no 2 tempos para entrega local de antibiótico em alta concentração e pode ser
  definitivo em casos selecionados; voto 100% (segundo o resumo da pergunta no site ICM Philly,
  hoje redirecionado para icmortho.org — texto completo **NÃO VERIFICADO**, JSES bloqueou acesso).
- Batailler, Cance, Lustig (OTSR 2025, revisão): espaçador tem 2 funções — antibiótico local em dose
  alta e manter o espaço articular (menos retração de partes moles); **reimplante após ≥6 semanas**
  (sem janela de antibiótico) ou 3 meses após 2 semanas de janela; no ombro os espaçadores são
  articulados; complicações mais frequentes = **luxação** (articulados) e **quebra**.
- Tempo real entre os tempos: McFarland 2018 média **6 meses (2–18)**; REMEDY (OsteoRemedies)
  rotulado para **≤180 dias**; Frankenspacer ≥6 semanas de antibiótico IV antes do 2º tempo.
- Muitos pacientes ficam com o espaçador **definitivo**: 43% em Jawa 2011; 4/16 em Coffey 2010;
  séries de espaçador definitivo com mortalidade de 52,9% em 4,7 anos (Rondon 2021, pacientes frágeis).
  → O espaçador precisa sobreviver mecanicamente **meses a anos**, não só 6 semanas.

## 2. A referência principal — Klosterman et al., Arthrosc Tech 2021 (texto completo lido)

| Item | O que o artigo diz |
|---|---|
| Molde proximal | Molde metálico comercial de 2 metades (Aequalis Ascend Flex Convertible Shoulder System Molds, Wright): 4 hastes (2, 4, 6, 8) × 3 cabeças **43×16, 48×18, 52×23 mm** (diâmetro × altura) |
| Escolha do tamanho | Brocha + cabeça de prova do sistema padrão; reduz, faz arco de movimento, confirma tamanho |
| Haste distal | Dreno de tórax (Argyle), 24–34 F; comprimento = comprimento total − haste do molde; "melhor superestimar" e cortar depois com cortador de pino |
| Conversão | O texto diz "3 millimeters = 1 French Gauge". **Isso está invertido**: na escala Charrière 1 F = 1/3 mm (diâmetro externo em mm = F/3). 24–34 F = 8–11,3 mm de diâmetro **externo**; o cimento moldado dentro do tubo tem o diâmetro **interno** (parede do tubo não informada — **NÃO VERIFICADO**) |
| Reforço | Fio-guia de fresagem 2,5 mm com ponta em bola (DePuy Synthes); a bola fica dentro da cabeça; o fio passa pelo molde e entra no tubo |
| Desmoldante | Óleo mineral nas 2 metades e dentro do tubo — "crucial" / "key" |
| Cimento | Palacos; **3,6 g tobramicina + 2,0 g vancomicina por pacote**; 2 pacotes + 2,5 doses de monômero (3 pacotes + 3,5 doses); antibiótico misturado ao monômero antes do pó; consistência de "pasta de amendoim mole" |
| Enchimento | Seringa de 60 mL cortada, ~15 mL de cimento no tubo; encher cada metade; **não encher o cone mais distal** do molde; deitar o fio-guia na metade, fechar e prender com grampo |
| Cura | "variável, mas geralmente ~16 min" (monômero pode ser refrigerado para ganhar tempo) |
| Desmoldagem | Bisturi 10 + descolador para tirar o tubo; abrir o molde; às vezes precisa de impactor de cabeça para soltar a peça |
| Acabamento | Excesso cortado com alicate de corte; bordas lisas com lima/Darrach; "atenção especial à superfície articular" |
| Implante | "da forma padrão" (não diz se cimenta no canal); em osteotomia estendida, fecha a osteotomia sobre o espaçador com cerclagens |
| Complicações citadas | fratura da diáfise umeral, erosão óssea, fratura do espaçador, rotação, luxação; "explante pode ser complicado por fratura e cimento distal retido" |

Fonte: https://pmc.ncbi.nlm.nih.gov/articles/PMC7917196/

## 3. Complicações — números por estudo

| Estudo (tipo, n) | Tipo de espaçador | Fratura do espaçador | Luxação / instabilidade | Rotação | Erosão glenoidal | Fratura umeral | Outros |
|---|---|---|---|---|---|---|---|
| McFarland 2018, JSES (60 espaçadores comerciais; 50 no 2º tempo) — só resumo | comerciais | 4 | — | 3 | 6 (+2 erosões da diáfise) | 3 | 18 complicações em 14 pacientes; complicações "comuns especialmente entre 1º e 2º tempo" |
| Jawa 2011, JBJS Am (28) — resumo + dica técnica | PROSTALAC feito à mão: cabeça em molde hemisférico 44 mm; placa 1/3 tubular (14) ou LC-DCP 3,5 (11) ou sem arcabouço (3) | 3 (**todas com placa semitubular**) | 1 | — | — | — | 9 complicações em 8 (29%) |
| Alessio-Mazzola 2020, HSS J (revisão sistemática, 143, espaçador definitivo) | 55% comerciais, 38,5% feitos à mão (14 com placa DCP dobrada), 6,3% haste de hemi revestida | 8 (5,6%) | 1 ("0,1%" no texto; 1/143 = 0,7% — erro aritmético do artigo) | — | — | 3 periprotéticas (2,1%) | reinfecção 7,0% |
| Da Silva/Tashjian 2025, JSES Int (55; 53 com RX) | pré-fabricado REMEDY | 3/53 (5,7%) | 7/53 (13,2%) | — | 19/53 com desgaste (35,8%): superior 24,5%, anterior 7,5%, central 3,8% | **4/55 (7,3%) na implantação** | soltura 4/53 (7,5%), 21% vs 0% em reinfectados vs não |
| Beady/Tashjian 2025 "Frankenspacer", JSES RRT (18, perda óssea umeral proximal) | cabeça pré-fabricada + Steinmann rosqueado + haste intramedular (Zimmer) + cimento | **0** | **10/18 (56%)**: 20% em PHAROS 1 vs 69% em PHAROS 2–3 | — | 15/18 (83%, TC), mais anterior (subescapular deficiente) | 1 pós-op (Cofield C) | soltura 2/18 (11%); 8/9 fraturas prévias consolidaram |
| Aibinder/Sperling 2019, Orthopedics (27, molde anatômico intraoperatório) — só resumo | moldado no intraoperatório | — | — | **3 rotacionalmente instáveis, todos com perda óssea proximal** (o resumo diz "3 (4%)"; 3/27 = 11%) | — | — | erradicação 85%; movimento precoce seguro com manguito presente |
| Porcellini 2022 (48; resumo de congresso) | 35 pré-formados modulares × 13 feitos à mão | 2 (1+1) | 2 | — | — | — | pré-formados com melhor função |
| Kim 2022, CiSE (11) | feito à mão, 4 g vanco + Steinmann 2,4 mm | 0 | 0 | — | 0 | 2 após a RTSA (ponta da haste) | — |
| Themistocleous 2007, JSES (11, definitivo) — resumo | — | 0 | — | — | "sem alterações degenerativas progressivas" | — | sem soltura |
| Padegimas 2017, CiOS (37: 22 sem haste, 15 com haste) | todos feitos à mão, tobra + vanco; com haste = cimento em forma de haste ± fio central dobrado | — | — | — | — | — | 2 paralisias radiais (sem haste); sem diferença de desfecho entre com/sem haste |

Leituras para o desenho:
- **Fratura do espaçador** fica em ~4–11% nas séries com espaçador feito à mão/comercial; o Frankenspacer
  (núcleo metálico rígido + haste) teve 0/18. A dica técnica do PROSTALAC mostra que núcleo fraco
  (placa 1/3 tubular) concentra as fraturas. O local exato das fraturas (colo × haste) **não está nos
  resumos — NÃO VERIFICADO**.
- **Luxação** depende mais de perda óssea/partes moles do que do espaçador: 20% × 69% por PHAROS
  (Frankenspacer). Com tuberosidades presentes (nosso caso) o risco deve ser o das séries sem perda
  óssea (13% em Da Silva) — inferência.
- **Erosão glenoidal** é comum (12–83% conforme método) → superfície da cabeça precisa ser **lisa**
  e sem aresta; cabeça em **valgo** se associa a destruição glenoidal na hemiartroplastia
  (Herschel 2017).
- Revisão de espaçadores de **quadril** (Sambri 2023, 40 estudos): moldes padronizados tiveram mais
  complicação mecânica (37,2%) que pré-formados (13,8%); presença de metal **não** mudou
  significativamente a taxa. Extrapolação para o ombro = **NÃO VERIFICADO**.

## 4. Cabeça — tamanho × desfecho

### 4.1 Valores normativos do úmero normal (referência para o padrão "anatômico")

| Parâmetro | Valor | Fonte |
|---|---|---|
| Raio de curvatura (coronal) | 24 ± 2,1 mm (19–28) | Iannotti 1992, 140 ombros |
| Espessura (altura) da cabeça | 19 ± 2,4 mm (15–24) | Iannotti 1992 |
| Topo da cabeça acima do topo da tuberosidade maior | 8 ± 3,2 mm (3–20) | Iannotti 1992 |
| Offset lateral do úmero | 56 ± 5,7 mm (43–67) | Iannotti 1992 |
| Contorno periférico | raio axial 2 mm menor que o coronal (elíptico, razão 0,92) | Iannotti 1992 |
| Raio frontal (p10–p90) | 21–26,5 mm | Hertel 2002, 200 úmeros |
| Diâmetro da base da cabeça (plano do colo) | 39,4–50 mm | Hertel 2002 |
| Altura da cabeça | 14,4–18,8 mm | Hertel 2002 |
| Razão altura/raio | 0,64–0,77 ("uma altura por raio basta") | Hertel 2002 |
| Inclinação (ângulo colo-diáfise) | 132–142° ("surpreendentemente constante") | Hertel 2002 |
| Offset medial | 3,9–8,6 mm | Hertel 2002 |
| Offset posterior | −0,4 a 3,2 mm | Hertel 2002 |
| Retrotorção | 7–38,5° | Hertel 2002 |
| Raio / altura / ângulo cabeça-diáfise / offset | 25,3 mm / 18,5 mm / 40,7° / 9,7 mm | Pearl & Volk 1996 (21 úmeros). O ângulo de 40,7° é medido entre o plano do colo e a diáfise? Se for, equivale a ~130,7° de colo-diáfise — **interpretação NÃO VERIFICADA** |
| Arco articular | 159 ± 8,5° coronal, 160 ± 11° transverso | Jobe & Iannotti 1995 |
| Conformidade | índice (raio cabeça / raio glenoide) 0,72 coronal, 0,63 sagital; glenoide mais plano | McPherson 1997 |
| Boileau & Walch 1997 | inclinação, retroversão, offsets medial e posterior variam individualmente | Só resumo — **números NÃO VERIFICADOS** (acesso fechado) |

Cálculo próprio útil para o gerador (calota esférica de raio R e altura h):
- arco articular = 2·acos(1 − h/R). Ex.: R 24, h 19 → 156° (bate com os 159° de Jobe & Iannotti).
- volume da calota = π·h²·(3R − h)/3. Ex.: R 24, h 18 → 18,3 cm³; R 26, h 20 → 24,3 cm³.
- diâmetro da base da calota = 2·√(h·(2R − h)). Ex.: R 24, h 17 → 45,4 mm (dentro dos 39,4–50 de Hertel).

### 4.2 O que o tamanho da cabeça faz (biomecânica e clínica)

- **Harryman 1995 (cadáver)**: cabeça não anatômica grande → **todos** os movimentos diminuem
  (flexão, rotações, elevação máxima) e a frouxidão (gaveta, sulco) cai muito; a translação obrigatória
  aparece em ângulos menores.
- **Blevins 1998 (6 cadáveres, 6 tamanhos)**: relação linear inversa entre tamanho da cabeça e elevação,
  rotação, translação AP e inferior. Trocar a cabeça nativa por componente de **mesmo diâmetro** reduziu
  elevação 20%, rotação 40%, translação AP 50% e inferior 60%; por componente de **mesmo volume**:
  8%, 20%, 25%, 40%. "Tamanho da cabeça se descreve melhor por **volume** do que por diâmetro ou offset."
- **Nyffeler 2004**: cabeça 5 mm alta → −10° de abdução máxima; 10 mm alta → −16°; braços de momento
  do infra e subescapular caem 4–10 mm. → a **altura do topo da cabeça em relação à tuberosidade maior**
  é parâmetro crítico (normal: 8 ± 3,2 mm acima, Iannotti).
- **Pearl & Kurutz 1999**: sistemas press-fit deslocaram o centro de rotação 14,7 mm em média e
  reduziram o arco articular em 26°, sempre deslocando para cima e lateral.
- **Sheth & Hsu 2026 (revisão JBJS)**: desvio do centro de rotação **> 3–4 mm** do "círculo perfeito"
  se associa a pior resultado clínico; às vezes se usa tamanho não anatômico para acertar a tensão.
- **Matsen 2025**: overstuffing é causa principal de dor, rigidez e função ruim na artroplastia anatômica.
- **Herschel 2017 (118 hemiartroplastias)**: tamanho da cabeça **não** correlacionou com erosão
  glenoidal; cabeça em **valgo**, cistos glenoidais, cartilagem lesada e manguito deficiente sim.

### 4.3 Tamanhos usados em espaçadores publicados/comerciais (só referência de faixa)

| Origem | Cabeças | Observação |
|---|---|---|
| Molde Ascend Flex (Klosterman) | 43×16, 48×18, 52×23 mm | diâmetro × altura |
| StageOne Shoulder (Zimmer Biomet), 5 tamanhos | 42×18×46, 46×18×53, 50×21×57, 54×21×64, 58×24×64 mm; hastes 6–14 mm, "standard stem 122 mm" | 3ª dimensão sem legenda — **NÃO VERIFICADO**; pede **1** pacote de 40 g no menor e **2** nos demais |
| REMEDY (OsteoRemedies) | cabeças 40, 45, 50 mm; hastes S/M/L de 101/116/131 mm (1ª coluna da tabela), com hastes de aço inox; ajuste de colo "até 9 mm" | gentamicina base 0,5/0,5/0,6 g por cabeça e 0,1/0,3/0,5 g por haste; significado das outras colunas **NÃO VERIFICADO**; Da Silva cita 0,8 g/espaçador (2,8% p/p) |
| Spacer-S (Tecres) | 41 e 46 mm | estrutura de aço inox; gentamicina (quantidade **NÃO VERIFICADA**) |
| SYNICEM Shoulder (Biocomposites) | tamanhos não publicados na página | núcleo de aço inox uniforme; gentamicina |
| PROSTALAC (Spang/Warner, dica técnica) | molde hemisférico de 44 mm | — |
| Frankenspacer | provas 40, 45, 50 mm "no glenoide residual, o tamanho que preenche a cavidade" | — |

→ Faixa praticada: **40–58 mm**. A mediana normativa (R 24 → 48 mm) cai no meio dessa faixa.

### 4.4 O racional da "cabeça maior e lisa" — prós, contras e o que falta

A favor (com evidência indireta):
- Mais estabilidade/menos translação (Harryman, Blevins) num cenário em que luxação é frequente
  (13% com tuberosidades/sem grande perda óssea; até 56–69% com perda óssea).
- Preencher a cavidade glenoidal/espaço morto (critério do Frankenspacer).
- No ombro com manguito deficiente, a cabeça "CTA" de superfície estendida articula com o arco
  coracoacromial; o grande offset medial reduz em 54% as forças de contato acrômio-umerais (Smith 2021,
  citando estudo biomecânico). **Mas** essa cabeça cobre a tuberosidade maior — no nosso escopo
  (tuberosidades presentes) isso não se aplica diretamente.

Contra:
- Menos movimento e mais tensão (Harryman, Blevins); cabeça alta tira abdução (Nyffeler); overstuffing
  dá dor e rigidez (Matsen; Sheth & Hsu).
- Maior volume de cimento → mais exotermia (seção 11) e mais pacotes.
- Fechamento de partes moles sobre cabeça grande: fala-se em "restaurar a tensão", mas nenhum
  artigo lido quantifica dificuldade de fechamento — **NÃO VERIFICADO**.

**Lacuna:** nenhum artigo de espaçador de ombro compara cabeça sobredimensionada × anatômica em
luxação, erosão glenoidal ou acromial. Qualquer "+X mm" é decisão clínica do cirurgião, não da
literatura.

## 5. Geometria cabeça-colo (desenho de prótese anatômica)

- **Ângulo colo-diáfise**: normal 132–142° (Hertel); Frankenspacer fixou o Steinmann em **135°**;
  PROSTALAC dobra a placa em **~125°** "para imitar o ângulo anatômico" (dica técnica). Cabeça em valgo
  → destruição glenoidal na hemi (Herschel). → faixa sugerida do parâmetro 125–145°, padrão 135°.
- **Offsets**: medial 3,9–8,6 mm, posterior −0,4 a 3,2 mm (Hertel). O Frankenspacer não controla
  offset; o REMEDY permite "até 9 mm" de posicionamento da cabeça.
- **Retroversão**: normal 7–38,5° (Hertel); Frankenspacer implantado em **30°**. No espaçador ela é
  definida **na implantação**, não no molde → útil uma **marca de versão** (linha/entalhe raso na face
  lateral do corpo alinhada ao eixo da cabeça) — inferência, **NÃO VERIFICADO** na literatura.
- **Altura**: topo da cabeça ~8 mm acima da tuberosidade maior (Iannotti); cabeça alta tira abdução
  (Nyffeler). Com tuberosidades presentes, a altura do espaçador no canal decide isso — o gerador pode
  mostrar a distância plano de corte → topo da cabeça.
- **Junção cabeça-corpo**: nenhum espaçador publicado usa cone; ou a cabeça é moldada junto com o corpo
  (Klosterman, PROSTALAC, Adan), ou é colada com cimento (Frankenspacer, REMEDY com rosca + cimento).
  Não achei dados sobre diâmetro mínimo do colo nem sobre onde os espaçadores de ombro quebram —
  **NÃO VERIFICADO**. Desenho sugerido (inferência): colo curto e largo, concordância com raio generoso
  (sem entalhe), e a **haste metálica atravessando o colo até dentro da cabeça** (a bola do fio-guia
  de Klosterman fica dentro da cabeça; o Steinmann do Frankenspacer entra na cabeça).
- **Borda da calota**: arredondar a aresta calota-colo (sem aresta viva contra glenoide/partes moles)
  — inferência.

## 6. Haste: comprimento, diâmetro e ajuste no canal

- **Ajuste frouxo, não cimentado em toda a extensão**, é a regra quando se quer remover depois:
  - Da Silva 2025: proximal do espaçador revestido de cimento com antibiótico e **"colocado frouxo no
    canal ... facilitando a remoção"**.
  - Levy 2015 / Schodlbauer 2025: haste de hemi revestida de cimento **sem cimentar no úmero**.
  - PROSTALAC (dica técnica): **nenhum cimento em volta da placa dentro do canal**, nenhuma fixação
    placa-osso.
  - Frankenspacer: haste **press-fit** distal + corpo de cimento que "intussuscepta" no canal proximal
    (estabilidade rotacional); no 2º tempo "simplesmente batido para fora".
  - REMEDY (técnica do fabricante): **cimento no proximal da haste é "compulsório" para evitar
    rotação e reduzir luxação/soltura** — mas isso é num espaçador de haste pré-fabricada.
- **Remoção**: Klosterman alerta para fratura e **cimento distal retido** no explante; Adan 2026 cita
  osteotomia/janela quando a haste está fixa. → haste **lisa, cônica, sem furos, sem aletas finas,
  sem retenções** (nenhum rebaixo em que osso ou cimento pastoso trave).
- **Fratura na implantação**: 7,3% com espaçador pré-fabricado (Da Silva); 3 fraturas umerais em
  McFarland. → não forçar haste larga no canal; ponta distal arredondada — inferência.
- **Diâmetro**: Klosterman mede o canal com fresas retas e escolhe o dreno pelo diâmetro (ver erro de
  conversão na seção 2); Adan: em canal alargado, mais cimento para aumentar o diâmetro; hastes fixas
  de pré-fabricados podem não preencher canais osteolíticos (Adan). Não achei regra numérica de
  "folga" (ex.: fresa − 1 mm) — **NÃO VERIFICADO**.
- **Comprimento**: StageOne "standard stem 122 mm"; REMEDY 101/116/131 mm; Frankenspacer ≥10 cm além
  da perda óssea ou 5 cm além da fratura; Klosterman = comprimento do componente retirado. Na fase 1
  do gerador o molde cobre só o corpo proximal; o restante vem do dreno de tórax.
- Padegimas 2017: com haste × sem haste (bola) sem diferença de erradicação, reimplante ou elevação;
  mas 2 paralisias radiais no grupo sem haste (bola solta).

## 7. Corpo proximal e estabilidade rotacional

- Rotação do espaçador: 3/50 (McFarland), 3/27 todos com perda óssea proximal (Aibinder); Klosterman
  lista "rotação e luxação" entre as complicações.
- Mecanismos que funcionaram: corpo de cimento que se encaixa no canal proximal (Frankenspacer),
  cimento proximal (REMEDY), haste press-fit com bloqueio distal opcional (Frankenspacer, 1 caso).
- Com **tuberosidades presentes**, a metáfise é um envelope contido → um corpo **não circular**
  (secção trapezoidal/oval achatada, ombro lateral largo) dá antirrotação sem aletas — inferência
  coerente com as fontes, sem estudo específico.
- Klosterman argumenta que o espaçador deve dar "preenchimento adequado do osso metafisário e
  diafisário" (vantagem sobre os curtos pré-fabricados).
- Resistência: todas as preparações com vancomicina adicionada ficaram **abaixo de 50 MPa em flexão
  após 6 semanas** (Lunz 2022) → evitar seções finas; o requisito do cirurgião ("sem furos, sem
  aletas finas") é consistente com isso.

## 8. Reforço metálico

| Reforço | Fonte | Resultado relatado |
|---|---|---|
| Fio-guia de fresagem 2,5 mm com ponta em bola, da cabeça até a ponta distal | Klosterman 2021 | não estudado clinicamente |
| Steinmann 2,4 mm | Kim 2022 (11) | 0 fraturas/luxações do espaçador |
| Steinmann rosqueado (cabeça a 135°) dentro de haste intramedular canulada | Frankenspacer (18) | 0 fraturas; 11% soltura |
| Rush rod centralizado (fluoroscopia, "evitar concentrador de tensão cortical") | Adan 2026 (5 casos de 27 customizados de 306) | 2 com falha mecânica persistente em perda óssea grave |
| Placa LC-DCP 3,5 dobrada ~125° / placa 1/3 tubular / nenhum | Jawa 2011, Spang 2015 | 3 fraturas, todas com 1/3 tubular |
| Placa DCP dobrada | Alessio-Mazzola 2020 (14 casos) | — |
| Hastes/estrutura de aço inox de fábrica | REMEDY, Spacer-S, SYNICEM | — |
| Nail + cabeça de PMMA ("hybrid spacer") | Brodt 2010 (caso) | definitivo, satisfatório |

→ Implicação: o molde deve prever **um canal central** para uma haste de 2,4–3,2 mm (faixa das fontes;
diâmetro exato é escolha do cirurgião), **no plano de partição**, do fundo da cabeça até a saída
distal onde encaixa o dreno de tórax. Centralizar a haste (Adan).

## 9. Antibióticos e doses por 40 g de PMMA

| Regra/receita | Valor | Fonte |
|---|---|---|
| Definição de "dose alta" para espaçador | ≥3,6 g de antibiótico por 40 g | Samelis 2022 (revisão); Warwick 2024 |
| Combinação típica | 1–3 g vancomicina + 1,2–4,8 g aminoglicosídeo (genta ou tobra) por 40 g | Samelis 2022 |
| Teto | evitar >8 g/40 g; antibiótico ≤10–15% (ou 20%) da massa | Samelis 2022 |
| Clínico (hip/knee, 202 pacientes) | >3,6 g total reduziu falha em infecção de artroplastia primária (OR 0,37); vanco ≥2 g reduziu falha infecciosa (OR 0,31) | Warwick 2024 — **quadril/joelho**, extrapolar com cautela |
| Klosterman (ombro) | 3,6 g tobra + 2,0 g vanco por pacote de Palacos | Klosterman 2021 |
| Frankenspacer (ombro) | 1 g ceftazidima + 3 g vancomicina por 40 g | Beady 2025 |
| PROSTALAC (ombro) | "tipicamente 2 g gentamicina, 3 g tobramicina e 1 g vancomicina por pacote de 40 g" | Spang/Warner 2015 (dica técnica) |
| Kim 2022 (ombro) | 4 g vancomicina por espaçador (+ Steinmann) | Kim 2022 |
| Da Silva 2025 (ombro) | REMEDY (genta 0,8 g) + cimento proximal com vanco/ceftriaxona/tobra a critério | Da Silva 2025 |
| Mecânica | vanco 4 g em Palacos R+G (0,5 g genta) = melhor equilíbrio; todas <50 MPa flexão em 6 semanas | Lunz 2022 |
| Mecânica/eluição | 3 g tobra + 2 g vanco = melhor eluição, mas menos resistência e mais porosidade | Slane, Gietman, Squire 2018 (Squire é coautor de Klosterman) |
| Mecânica | compressão: vanco −13%; genta **líquida** −37%; ambos −45% → usar **pó**, nunca líquido | Samelis 2022 |
| Sinergia | aminoglicosídeo em dose alta (>3,6 g tobra + 1 g vanco por pacote) aumenta a liberação de vanco; recomenda-se a combinação mesmo com germe resistente a aminoglicosídeo | Samelis 2022 |
| Estabilidade térmica | antibiótico deve aguentar ~82–83 °C por 12–13 min da polimerização (Samelis); termoestável, hidrossolúvel, estável no cimento; genta e vanco preferidos | Batailler 2025; Samelis 2022 |
| Estabilidade térmica | tobra, amicacina, fosfomicina estáveis; meropenem perde atividade em 7 dias; minociclina em 48 h | Levack 2021 |
| Superfície × eluição | eluição depende de área/volume; mais antibiótico = mais massa e taxa de eluição | Duey 2012 |
| Toxicidade | creatinina +50% em 20% com espaçador de tobramicina na 1ª semana | Samelis 2022 |
| Toxicidade | erupção por espaçador de ombro com vancomicina (relato) | Xu 2016 |
| Microbiologia do ombro | *C. acnes*, *S. epidermidis*, *S. aureus* mais frequentes | Klosterman 2021; Porcellini 2022 (*C. acnes* 37,5%) |

Cimentos de alta viscosidade com antibiótico pré-misturado (conteúdo por unidade):
- **PALACOS R+G** (Heraeus/Zimmer Biomet): 0,5 g gentamicina por 40 g (Lunz 2022; página Heraeus);
  SSCP: pó = PMMA copolímero 82%, ZrO₂ 15%, BPO 1%, sulfato de gentamicina 2%; pacotes 10, 20, 40, 60 g.
  Indicação no SSCP: fixação de endopróteses (quadril, joelho, tornozelo, **ombro**, cotovelo) e técnica
  de membrana induzida — espaçador de artroplastia **não** está listado (situação regulatória do uso
  como espaçador **NÃO VERIFICADA**).
- **COPAL G+C** (Heraeus): 1 g gentamicina + 1 g clindamicina; alta viscosidade.
- **COPAL G+V** (Heraeus): 0,5 g gentamicina + 2 g vancomicina por 40 g (Lunz 2022).
- **Refobacin Bone Cement R** (Zimmer Biomet): com gentamicina (quantidade **NÃO VERIFICADA**);
  é o cimento listado junto ao StageOne.
- Palacos R+G foi recomendado sobre Copal spacem para espaçador genta+vanco (Boelch 2018).

## 10. Volume de cimento

- 1 pacote de Palacos (44 g de pó incluindo antibiótico + 20 mL de líquido), curado e seco = **57 g**
  (Satish 2018).
- StageOne: **1 pacote** (haste 6 mm + cabeça 42) e **2 pacotes** (demais tamanhos).
- Klosterman: 2 pacotes usuais; "planeje 3 na primeira vez"; ~15 mL só para o dreno.
- Frankenspacer: 1 pacote só para o corpo proximal/ligação.
- Densidade do cimento curado (com 15% de ZrO₂) **NÃO VERIFICADA** nesta pesquisa. Estimativa própria
  com ρ ≈ 1,2–1,3 g/cm³: 1 pacote ≈ 44–48 cm³ de peça. Uma cabeça R 24/h 18 (18,3 cm³) + corpo proximal
  (~15–25 cm³, depende do desenho) ≈ 35–45 cm³ → coerente com "1–2 pacotes" dos moldes comerciais.
- → o gerador deve mostrar **volume (cm³)** e **pacotes sugeridos** com uma constante calibrável
  (pesar a peça curada no 1º teste de bancada), com margem para perda na mistura/transferência.

## 11. Cura, exotermia, desmoldagem e esterilização do molde

- Klosterman: cura "variável, geralmente ~16 min"; guardar um pouco de cimento na mesa para testar;
  monômero refrigerado dá mais tempo de trabalho.
- Kong 2021 (joelho, molde de silicone feito a partir de molde de náilon impresso): cimento na
  temperatura ambiente **8–10 min**; molde de silicone **autoclavado 140 °C por 60 min**.
- Moldes de resina (não médica) impressos, esterilizados por **plasma de peróxido de hidrogênio**
  (Alaseem 2025 ulna; Alaseem 2026 calcâneo); o molde não toca o paciente.
- ISO 5833 (via Nottrott 2010): compressão ≥70 MPa, módulo de flexão ≥1800 MPa, flexão ≥50 MPa;
  a norma define tempo de massa, tempo de presa e temperatura máxima de cura (limites numéricos de
  tempo/temperatura **NÃO VERIFICADOS** — não li a norma). Tempo de presa encurta com sala mais quente
  e varia muito na mesma faixa de temperatura (Langdown, citado por Nottrott).
- **Espessura e material do molde mudam a exotermia**: em molde de PTFE o pico de temperatura variou
  ~**75 °C** entre 6 mm e 40 mm de altura, e o tempo de presa ~**740 s**; em espuma de PU (isolante)
  só 28 °C e 130 s (Li 2004). Material do molde altera a conversão de monômero e, portanto, a
  resistência final (Vallo 2002). Discos de PMMA mais grossos → temperaturas maiores (Golz 2010).
  → A cabeça de 45–55 mm é uma massa espessa: o molde (ex.: plástico impresso) precisa suportar o
  pico e não deformar; **medir com termopar em bancada** antes do uso clínico. Temperatura de
  transição vítrea de cada plástico de impressão **não pesquisada aqui**.
- Desmoldante: **óleo mineral** (Klosterman, "crucial"). Outros desmoldantes **NÃO VERIFICADOS**.
- Soltar do molde pode exigir impactor (Klosterman) → prever **ponto de apoio para extração** e
  ângulo de saída; acabamento da superfície articular depois (lima).
- Molde de 2 metades com grampo (Klosterman) → o gerador deve prever **pinos de registro**
  (o cirurgião pediu 1 macho + 1 fêmea) e área plana para grampo — inferência.

## 12. Furos de sutura / fixação de tuberosidades e manguito

- Não achei nenhum espaçador de ombro publicado com furos para sutura de tuberosidade/manguito; os
  comerciais citam "textura com covinhas para mais área e eluição" (StageOne), não furos.
- Klosterman: quando houve osteotomia umeral, ela é fechada **sobre** o espaçador com cerclagens
  (fitas), sem passar pelo espaçador.
- Verhelst 2011: **preservar as tuberosidades** foi fator prognóstico de bom resultado na artroplastia
  de ressecção; espaçador não melhorou o resultado vs. ressecção nessa série (21 pacientes).
- → Com tuberosidades presentes: **sem furos** (coerente com "robusto, sem furos"). Se algum dia
  quiserem passar sutura, um sulco raso e largo no colo seria menos frágil que furo — **inferência, NÃO
  VERIFICADO**.

## 13. Superfície

- Cabeça: lisa (Klosterman: "superfície articular lisa" é vantagem listada; acabamento com lima,
  "atenção especial à superfície articular"). Molde impresso deixa camadas → a cavidade da cabeça
  precisa sair lisa (pós-processamento do molde) — inferência.
- Não articulares: StageOne usa "textura com covinhas para aumentar área e eluição"; Duey 2012 mostra
  eluição dependente de área/volume. **Mas** textura na haste pode prender no osso/cimento e atrapalhar
  a remoção → textura só no corpo proximal (se quiserem), haste lisa — inferência.

## 14. Remoção no 2º tempo — regras que viram geometria

1. Haste lisa, cônica, sem furos/aletas/rebaixos (Frankenspacer "bater e sair"; Klosterman: cimento
   distal retido complica).
2. Não cimentar a haste inteira; no máximo cimento pastoso proximal (REMEDY, Da Silva).
3. Corpo antirrotação por forma, não por retenção.
4. Cabeça grande o bastante para ser agarrada/impactada? — **NÃO VERIFICADO** (nenhuma fonte fala).

## 15. Mapa complicação → requisito do molde

| Complicação | Frequência nas fontes | Requisito de desenho |
|---|---|---|
| Fratura do espaçador | 4/50; 3/28; 8/143; 3/53; 0/18 com núcleo rígido | canal para haste metálica central através do colo até a cabeça; colo curto e largo; sem furos, aletas finas ou entalhes; cimento com antibiótico ≤8 g/40 g |
| Rotação no canal | 3/50; 3/27 (perda óssea) | corpo proximal não circular preenchendo a metáfise; opção de cimento proximal |
| Luxação | 0,7–13% sem grande perda óssea; 56% com perda | cabeça escolhida por prova/tensão; parâmetro de diâmetro e altura; ângulo colo-diáfise e altura em relação à tuberosidade |
| Erosão glenoidal | 12–83% | cabeça lisa, sem aresta na borda; evitar valgo (NSA muito alto) |
| Fratura umeral na implantação/remoção | 7,3% na implantação; 3/50 | haste levemente menor que o canal, ponta arredondada, sem rebaixos |
| Soltura | 7,5–11% (21% nos reinfectados) | — (marcador de reinfecção, não de desenho) |

## 16. Implicações diretas para o gerador (propostas)

1. Parâmetros de cabeça: **diâmetro** (faixa 38–60 mm; padrão = anatômico normal, ex.: 48 mm),
   **altura** (padrão = 0,7 × raio, faixa 0,64–0,77 de Hertel; ou arco articular), mostrar **arco**,
   **volume** e **diâmetro da base**; alerta visual fora de p10–p90 de Hertel (raio 21–26,5 mm).
2. **Ângulo colo-diáfise** 125–145°, padrão 135°. **Offset medial** 0–9 mm (Hertel 3,9–8,6),
   **offset posterior** 0–3 mm.
3. Colo de cimento curto e largo, com concordância arredondada; borda da calota arredondada.
4. **Corpo proximal**: secção não circular, sem furos/aletas; medidas (largura ML, espessura AP,
   comprimento abaixo do plano de corte) como parâmetros; ângulo de saída para desmoldar.
5. **Canal central** para haste de 2,4–3,2 mm no plano de partição, do interior da cabeça à saída
   distal; saída distal que receba o dreno de tórax (conversão correta: Ø externo mm = French / 3).
6. **Partição** anterior/posterior no plano que contém o eixo diafisário e o eixo da cabeça; 2 pinos
   de registro (1 macho, 1 fêmea); área plana para grampo; canal de enchimento e respiro.
7. Mostrar **volume da peça** e **pacotes de 40 g sugeridos** (constante calibrável; referência 57 g
   curado por pacote Palacos).
8. Marca de **retroversão** (entalhe raso) na face lateral do corpo.
9. Sem furos de sutura por padrão.
10. Texto de uso na página: óleo mineral, monômero gelado, cura ~16 min (variável), não desmoldar antes
    da presa completa, acabamento da cabeça, dose de antibiótico ≤8 g/40 g — com as fontes.

## 17. Questões em aberto / NÃO VERIFICADO

- Quanto sobredimensionar a cabeça num espaçador (nenhum estudo).
- Onde fraturam os espaçadores de ombro (colo × haste) e diâmetro mínimo do colo de cimento.
- Folga ideal haste × canal; se cimentar o proximal no nosso desenho.
- Densidade do cimento curado (volume por pacote); espessura de parede dos drenos 24–34 F.
- Limites de tempo/temperatura da ISO 5833; pico de exotermia numa cabeça de 45–55 mm dentro do
  plástico escolhido.
- Esterilização do molde impresso (autoclave × plasma de H₂O₂ × óxido de etileno) para o material
  escolhido; status regulatório de um molde impresso no hospital.
- Texto completo do ICM 2018 (ombro) e da revisão de Namdari 2022 (JAAOS) — só resumos.
- Números de Boileau & Walch 1997 (acesso fechado).
- Discrepâncias nas fontes: "3 (4%)" em Aibinder (3/27 = 11%); "0,1%" em Alessio-Mazzola (1/143 = 0,7%);
  conversão French invertida em Klosterman.

## 18. Referências (com URL)

Espaçador de ombro — técnica e séries
1. Klosterman EL, Cotter EJ, Squire MW, Grogan BF. Creation of a custom-length, humeral antibiotic cement spacer. Arthrosc Tech 2021;10(2):e481-e486. https://pmc.ncbi.nlm.nih.gov/articles/PMC7917196/ (vídeo: https://pmc.ncbi.nlm.nih.gov/articles/instance/7917196/bin/mmc1.mp4)
2. Beady ND, Guy C, Chalmers PN, Joyce CD, Tashjian RZ. The Frankenspacer. JSES Rev Rep Tech 2025. https://pmc.ncbi.nlm.nih.gov/articles/PMC12573618/
3. Adan FO, Wethington MA, Wethington AL, Harrison AK, Rao AJ. Custom humeral antibiotic spacers for complex shoulder arthroplasty revision. JSES Rev Rep Tech 2026;6(4):100787. https://pmc.ncbi.nlm.nih.gov/articles/PMC13332471/
4. McFarland EG, Rojas J, Smalley J, Borade AU, Joseph J. Complications of antibiotic cement spacers used for shoulder infections. JSES 2018;27(11):1996-2005. https://doi.org/10.1016/j.jse.2018.03.031 (resumo: https://europepmc.org/article/MED/29778591)
5. Da Silva A, Moverman MA, McCutcheon CL, Soule SM, Joyce CD, Chalmers PN, Tashjian RZ. Recurrence and radiological outcomes with a premade antibiotic cement hemiarthroplasty. JSES Int 2025. https://pmc.ncbi.nlm.nih.gov/articles/PMC12490687/
6. Alessio-Mazzola M et al. Permanent spacers ... systematic review. HSS J 2020. https://pmc.ncbi.nlm.nih.gov/articles/PMC7534885/
7. Jawa A et al. PROSTALAC for infection after shoulder arthroplasty. JBJS Am 2011;93(21):2001-2009. https://doi.org/10.2106/JBJS.J.00833 (resumo)
8. Spang R, Beamer B, Sood A, Warner JJP. Technical tip for PROSTALAC use for infection after shoulder arthroplasty. Orthop J Harvard Med School 2015. https://orthojournalhms.org/16/article107_111.html
9. Aibinder WR, Lee J, Shukla DR, Cofield RH, Sanchez-Sotelo J, Sperling JW. An anatomic intraoperatively prepared antibiotic spacer. Orthopedics 2019;42(4):211-218. https://doi.org/10.3928/01477447-20190701-01 (resumo)
10. Padegimas EM et al. Antibiotic spacers in shoulder arthroplasty: stemmed vs stemless. Clin Orthop Surg 2017;9(4):489-496. https://pmc.ncbi.nlm.nih.gov/articles/PMC5705308/
11. Kim DH, Bek CS, Cho CH. Two-stage RTSA with antibiotic-loaded cement spacer. Clin Shoulder Elb 2022;25:202-209. https://pmc.ncbi.nlm.nih.gov/articles/PMC9471815/
12. Porcellini G, Giorgini A, Montanari M. Modular tailored preformed vs hand-made spacer (resumo de congresso). Bone Joint Proc 2022. https://boneandjoint.org.uk/Article/10.1302/1358-992X.2022.10.046
13. Stine IA et al. Fixed articulating antibiotic-loaded spacer. JSES 2010;19(5):739-748. https://doi.org/10.1016/j.jse.2009.10.002 (resumo)
14. Themistocleous G et al. Prolonged implantation of an antibiotic cement spacer. JSES 2007;16(6):701-705. https://doi.org/10.1016/j.jse.2007.02.118 (resumo)
15. Coffey MJ, Ely EE, Crosby LA. Commercially produced antibiotic-impregnated cement spacer. JSES 2010;19(6):868-873. https://doi.org/10.1016/j.jse.2010.01.012 (resumo)
16. Levy JC, Triplet J, Everding N. Functional antibiotic spacer. Orthopedics 2015;38(6):e512-9. https://doi.org/10.3928/01477447-20150603-60 (resumo)
17. Schodlbauer DF et al. Functional composite spacer, minimum 5-year. JSES 2025;34(3):785-793. https://doi.org/10.1016/j.jse.2024.05.055 (resumo)
18. Rondon AJ et al. Spacers for life: high mortality. JSES 2021;30(12):e732-e740. https://doi.org/10.1016/j.jse.2021.05.005 (resumo)
19. Cronin KJ, Hayes CB, Sajadi KR. Spacer retention ≥2 years. JSES 2020;29(9):e325-e329. https://doi.org/10.1016/j.jse.2020.01.065 (resumo)
20. Verhelst L et al. Resection arthroplasty: does a cement spacer improve outcome? JSES 2011;20(8):1224-1233. https://doi.org/10.1016/j.jse.2011.02.003 (resumo)
21. Torrens C et al. Cement spacer sonication, second stage. J Orthop Surg Res 2018. https://pmc.ncbi.nlm.nih.gov/articles/PMC5859682/
22. Sabesan VJ et al. Two-stage reimplantation for prosthetic shoulder infections. CORR 2011;469:2538-2543. https://pmc.ncbi.nlm.nih.gov/articles/PMC3148358/ (resumo)
23. Assenmacher AT et al. Two-stage reimplantation, Mayo. JSES 2017;26(11):1978-1983. https://doi.org/10.1016/j.jse.2017.05.005 (resumo)
24. Brodt S, Hofmann GO, Tiemann AH. Hybrid-spacer (nail + PMMA head). Strategies Trauma Limb Reconstr 2010. https://pmc.ncbi.nlm.nih.gov/articles/PMC2918744/ (resumo)
25. Xu S et al. Drug eruption secondary to vancomycin-laden shoulder spacer. JSES 2016;25(8):e236-40. https://doi.org/10.1016/j.jse.2016.04.033 (só título)

Consenso e revisões
26. Garrigues GE et al. ICM 2018: management of periprosthetic shoulder infection. JSES 2019;28(6S):S67-S99. https://doi.org/10.1016/j.jse.2019.04.015 (só resumo)
27. Batailler C, Cance N, Lustig S. Spacers in two-stage strategy. OTSR 2025;111(1S):104074. https://doi.org/10.1016/j.otsr.2024.104074 (resumo)
28. Namdari S, Sudah SY, Menendez ME, Denard PJ. Antibiotic spacers for shoulder PJI: a review. JAAOS 2022;30(19):917-924. https://doi.org/10.5435/JAAOS-D-21-00984 (só resumo)
29. Samelis PV et al. Antibiotic-loaded cement spacers: current concepts. Cureus 2022. https://pmc.ncbi.nlm.nih.gov/articles/PMC8815820/
30. Sambri A et al. Mechanical complications of hip spacers: systematic review. Arch Orthop Trauma Surg 2023;143:2341-2353. https://pmc.ncbi.nlm.nih.gov/articles/PMC10110705/ (resumo)

Antibiótico e cimento
31. Warwick HS et al. Effect of antibiotic spacer dosing. JAAOS Glob Res Rev 2024. https://pmc.ncbi.nlm.nih.gov/articles/PMC10883627/ (resumo)
32. Lunz A et al. Mechanical strength of antibiotic-loaded PMMA spacers. BMC Musculoskelet Disord 2022;23:945. https://pmc.ncbi.nlm.nih.gov/articles/PMC9617327/
33. Boelch SP et al. Copal spacem vs Palacos R+G with vancomycin. BioMed Res Int 2018. https://pmc.ncbi.nlm.nih.gov/articles/PMC6206524/
34. Slane J, Gietman B, Squire M. High-dose tobramycin and vancomycin elution. J Orthop Res 2018;36(4):1078-1085. https://doi.org/10.1002/jor.23722 (resumo)
35. Duey RE et al. Elution vs surface area and volume. Iowa Orthop J 2012;32:104-115. https://pmc.ncbi.nlm.nih.gov/articles/PMC3565390/ (resumo)
36. Levack AE et al. Thermal stability of alternative antibiotics in PMMA. JBJS Am 2021;103(18):1694-1704. https://doi.org/10.2106/JBJS.20.00011 (resumo)
37. Heraeus Medical. SSCP PALACOS R+G (Doc. 61339). https://www.heraeus-medical.com/dam/jcr:f48fc76c-0cd6-4f86-8f7f-70c3e88dd952/sscp-palacos-rg-hcp-en.pdf
38. Heraeus Medical. COPAL G+C. https://www.heraeus-medical.com/en/healthcare-professionals/products/copal-gc/
39. Satish BRJ et al. How much bone cement is utilized in primary TKA? Arch Bone Jt Surg 2018;6(5):381-389. https://pmc.ncbi.nlm.nih.gov/articles/PMC6168233/
40. Nottrott M. Acrylic bone cements (tese). Acta Orthop Suppl 2010;81(341). https://actaorthop.org/actao/article/download/11138/14901
41. Li C, Mason J, Yakimicki D. Thermal characterization of PMMA bone cement curing. J Mater Sci Mater Med 2004;15(1):85-89. https://doi.org/10.1023/B:JMSM.0000010101.45352.d1 (resumo)
42. Vallo CI. Effect of mold characteristics on temperature and monomer conversion. J Biomed Mater Res 2002;63(5):627-642. https://doi.org/10.1002/jbm.10334 (resumo)
43. Golz T et al. Temperature elevation during PMMA cranioplasty. J Clin Neurosci 2010;17(5):617-622. https://doi.org/10.1016/j.jocn.2009.09.005 (resumo)

Material de fabricantes (só referência de tamanho)
44. Zimmer Biomet. StageOne Shoulder Cement Spacer Molds (5426.1-US-en, 2025). https://www.zimmerbiomet.com/content/dam/zb-corporate/en/products/specialties/cement/stageone-cement-spacer-molds/5426.1-US-en%20StageOne%20Shoulder%20Brochure%20fin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
45. OsteoRemedies. REMEDY Shoulder — Product Information. https://osteoremedies.com/wp-content/uploads/2017/08/REMEDY-Shoulder-Product-Information.pdf ; Surgical Technique: http://osteoremedies.com/wp-content/uploads/2018/02/Shoulder-Surgical-Technique.pdf ; página: https://osteoremedies.com/remedy-shoulder-system/
46. Tecres. Spacer-S. https://www.tecres.com/product_details/spacer-s
47. Biocomposites. SYNICEM Shoulder Spacer. https://biocomposites.com/our-products/synicem-spacers/synicem-shoulder-spacer/

Moldes impressos
48. Kong L et al. 3D printing-assisted articulating spacer (knee). BioMed Res Int 2021:3948638. https://pmc.ncbi.nlm.nih.gov/articles/PMC7884112/
49. Alaseem A et al. 3D printed cement mold, proximal ulna. Curr Oncol 2025;32(8):411. https://pmc.ncbi.nlm.nih.gov/articles/PMC12384866/
50. Alaseem A et al. 3D-printed cement spacer, calcaneus. Front Surg 2026;13:1864578. https://pmc.ncbi.nlm.nih.gov/articles/PMC13381017/
51. Exner GU et al. Cement spacer formed in a 3D-printed mold (radius). JBJS Case Connect 2021;11(2). https://europepmc.org/article/MED/34019491 (resumo)

Anatomia normal e tamanho da cabeça
52. Iannotti JP et al. The normal glenohumeral relationships. JBJS Am 1992;74(4):491-500. https://doi.org/10.2106/00004623-199274040-00004 (resumo)
53. Hertel R, Knothe U, Ballmer FT. Geometry of the proximal humerus. JSES 2002;11(4):331-338. https://doi.org/10.1067/mse.2002.124429 (resumo)
54. Pearl ML, Volk AG. Coronal plane geometry of the proximal humerus. JSES 1996;5(4):320-326. https://doi.org/10.1016/S1058-2746(96)80060-7 (resumo)
55. Pearl ML, Kurutz S. Geometric analysis of prosthetic systems. JBJS Am 1999;81(5):660-671. https://doi.org/10.2106/00004623-199905000-00007 (resumo)
56. McPherson EJ et al. Anthropometric study of normal glenohumeral relationships. JSES 1997;6(2):105-112. https://doi.org/10.1016/S1058-2746(97)90030-6 (resumo)
57. Jobe CM, Iannotti JP. Limits imposed on glenohumeral motion by joint geometry. JSES 1995;4(4):281-285. https://doi.org/10.1016/S1058-2746(05)80021-7 (resumo)
58. Boileau P, Walch G. The three-dimensional geometry of the proximal humerus. JBJS Br 1997;79(5):857-865. https://doi.org/10.1302/0301-620X.79B5.7579 (resumo; números NÃO VERIFICADOS)
59. Harryman DT et al. Articular conformity and humeral head size. JBJS Am 1995;77(4):555-563. https://doi.org/10.2106/00004623-199504000-00008 (resumo)
60. Blevins FT et al. Humeral head component size and hemiarthroplasty translations/rotations. JSES 1998;7(6):591-598. https://doi.org/10.1016/S1058-2746(98)90006-4 (resumo)
61. Nyffeler RW et al. Humeral prosthesis height and abduction. JBJS Am 2004;86(3):575-580. https://doi.org/10.2106/00004623-200403000-00017 (resumo)
62. Sheth MM, Hsu JE. Humeral head reconstruction in anatomic arthroplasty. JBJS Am 2026;108(1):25-34. https://doi.org/10.2106/JBJS.24.01583 (resumo)
63. Matsen F III. Avoiding overstuffing. Int Orthop 2025;49(12):2845-2849. https://doi.org/10.1007/s00264-025-06688-w (resumo)
64. Herschel R et al. Risk factors for glenoid erosion in hemiarthroplasty. JSES 2017;26(2):246-252. https://doi.org/10.1016/j.jse.2016.06.004 (resumo)
65. Smith TJ et al. The modern use of the extended humeral head (CTA) hemiarthroplasty. JSES Int 2021;5(1):142-148. https://pmc.ncbi.nlm.nih.gov/articles/PMC7846679/
