bgobbato/spacer_shoulder/research/RESEARCH_SHOULDER_SPACERS.md

# Pesquisa: Espaçadores de cimento PMMA com antibiótico para ombro (PJI) — opções comerciais, moldes 3D, biomecânica, anatomia e dados de trabalho do cimento

Data: 2026-09-25 · Fontes primárias verificadas por fetch direto (PDFs oficiais extraídos com pdftotext, PMC full text, IFU oficial). Base para o gerador paramétrico de moldes 3D (espaçador tipo hemiartroplasia umeral: cabeça esférica lisa + haste proximal robusta; haste distal intraoperatória com tubo torácico sobre haste-guia, técnica Klosterman).

---

## 1. OPÇÕES COMERCIAIS (espaçadores e moldes de ombro)

### 1.1 Zimmer Biomet — StageOne™ Shoulder Cement Spacer Molds (moldes, EUA)

Fontes: brochura oficial (PDF, issue 2025-09) e técnica cirúrgica oficial (PDF 0178.3), ambas em zimmerbiomet.com; página de produto; listagens de distribuidor.

- **Tipo:** molde de **silicone em peça única** (não bipartido metálico) para moldar spacer articulado de "hemi-shoulder" com Refobacin® Bone Cement R; após a cura, o molde é **cortado com bisturi** (lâmina gancho nº 12) e descartado (uso único).
  - Brochura: https://www.zimmerbiomet.com/content/dam/zb-corporate/en/products/specialties/cement/stageone-cement-spacer-molds/5426.1-US-en%20StageOne%20Shoulder%20Brochure%20fin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
  - Técnica: https://www.zimmerbiomet.com/content/dam/zb-corporate/en/education-resources/surgical-techniques/specialties/cement/stageone-cement-spacer-molds/0178.3-US-en-StageOn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
  - Página: https://www.zimmerbiomet.com/en/products-and-solutions/specialties/cement/stageone-cement-spacer-molds.html
- **Catálogo completo (da brochura/técnica):**

| Ref. | Haste | Cabeça (mm) | Sachês 40 g |
|---|---|---|---|
| 431406 | 6 mm | 42×18×46 | 1 |
| 431408 | 8 mm | 46×18×53 | 2 |
| 431410 | 10 mm | 50×21×57 | 2 |
| 431412 | 12 mm | 54×21×64 | 2 |
| 431414 | 14 mm | 58×24×64 | 2 |

- Comprimento do haste padrão **122 mm** (listagens: "Standard Stem (122 mm)" — https://www.graylinemedical.com/products/zimmer-biomet-stageone-shoulder-cement-spacer-mold-10-mm-standard-stem-122-mm-shoulder-mold-with-50-mm-x-21-mm-x-57-mm-head-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 e https://www.styxsports.com/news/index.html?id=15267459015).
- **Recursos do molde:** porta rosqueada para acoplar cartucho ClearMix (injeção sob pressão), **furos de respiro (vents)**, textura "dimpled" no spacer para aumentar superfície e eluição; ar aprisionado pode ser ventado com agulha hipodérmica através do silicone (técnica oficial, PDF acima).
- **Seleção de tamanho:** reamers humerais Comprehensive® **4–20 mm** e broaches mini **4–17 mm** + provadores de cabeça (o spacer equivale ao broach final; offset "A"); templates de raio-X disponíveis (ref. XRAY000256) (técnica oficial).
- **Uso:** máx. **180 dias**; inserção manual/ com head-pusher — "NÃO impactar com marreta: risco de fratura do dispositivo"; fixação press-fit ou cimentação leve proximal (técnica oficial).
- Marca/regulatório: fabricado por Biomet Orthopedics (Warsaw, IN); regime 510(k) classe II (nº K exato não localizado na busca — página FDA não alcançada; dispositivos homólogos StageOne knee/hip são 510(k)).

### 1.2 Wright Medical / Tornier (hoje Stryker) — Aequalis Ascend Flex "Humeral Spacer Molds" (moldes metálicos)

Fonte primária: Klosterman EL et al., *Arthroscopy Techniques* 2021;10:e481–e486, **PMCID: PMC7917196** (https://pmc.ncbi.nlm.nih.gov/articles/PMC7917196/) — já lida pela equipe; dados confirmados no artigo:

- Moldes **metálicos de duas partes** (tipo clamshell) da linha Aequalis Ascend Flex (Wright Medical/Tornier; hoje Stryker — https://www.stryker.com/us/en/trauma-and-extremities/products/tornier-flex.html).
- **4 tamanhos de haste × 3 cabeças:** hastes 2, 4, 6, 8; cabeças **43×16, 48×18, 52×23 mm** (diâmetro × espessura).
- Técnica associada: haste-guia ponta esférica **2,5 mm**; haste distal confeccionada com **tubo torácico 24–34 Fr** sobre a guia (3 mm = 1 Fr); cimento **Palacos + vancomicina 2 g + tobramicina 3,6 g por sachê**; **óleo mineral** como agente de liberação (PMC7917196).
- O implante Aequalis Ascend Flex (prótese, não o molde) tem 510(k) **K140082** (https://fda.innolitics.com/device/K140082). O catálogo público do molde em si não está mais on-line na Stryker (páginas do produto não recuperadas na busca de 2026-09-25 — usar Klosterman como referência de catálogo).

### 1.3 Tecres S.p.A. — InterSpace® Shoulder / Spacer®-S (spacer pré-fabricado)

Fontes: IFU oficial da OsteoRemedies (distribuidor EUA, PDF extraído) + página de produto Tecres + distribuidores Merete/Summit.

- **Tipo:** spacer **pré-fabricado, pronto para uso**, peça única tipo hemi-ombro; PMMA radiopaco com **gentamicina 1,87%** (0,8 g no tamanho grande; 0,4 g no pequeno) sobre **estrutura portante de aço inoxidável (AISI 316L)**; esterilizado com **óxido de etileno (EtO)**; uso único; máx. **180 dias**.
  - IFU (PDF): https://osteoremedies.com/wp-content/uploads/2024/01/OST008-Rev-00-01-2024_InterSpace-Shoulder-IFU.pdf
  - Tecres: https://www.tecres.com/product_details/spacer-s
  - Merete: https://merete.de/en/product/spacer-s/ · Summit: https://summit-medical.com/products/tecres-cement-spacer-s/
- **Catálogo (tabela dimensional do IFU):**

| Ref. | Cabeça Ø (A) | Espessura cabeça (B) | Haste compr. (C) | Haste Ø (D) | Gentamicina base |
|---|---|---|---|---|---|
| SPS0021 | 46 mm | 22 mm | 125 mm | 11 mm | 0,8 g |
| SPS0121 | 41 mm | 16 mm | 99 mm | 7 mm | 0,4 g |

- **Eluição in vitro (IFU):** 24,8–25,5 mg de gentamicina nas primeiras 24 h; 34,3–49,3 mg em 7 dias.
- **Técnica:** inserir com ~**40° de retroversão** (referência do IFU); cimentação proximal opcional (Cemex Genta) contra rotação; órtese (tiráx) recomendada; não lavar o spacer com soluções aquosas (mantém elução); provador (Spacer Shoulder Trial, SPS90Z0) e template transparente disponíveis (IFU + https://www.tecres.com/product_details/spacer-shoulder-trial).
- **Evidência:** "mais estudado dos spacers pré-fabricados" — >131 publicações; erradicação **>91%** (37 artigos, >1.600 pacientes, follow-up médio 56 meses) (página Tecres).
- Regulatório: fabricado pela Tecres (Itália), distribuído na América do Norte pela OsteoRemedies; FDA 510(k) do InterSpace Shoulder existente (nº não exibido no IFU recuperado).

### 1.4 Outros fabricantes

- **Nenhum outro molde/spacer de ombro dedicado** localizado na busca (Stryker, Lima Corporate, Exactech, Aran/Romanian, DePuy): buscas em catálogos e literatura retornaram apenas joelho/quadris adaptados (busca DDG 2026-09-25 sem resultados diretos; corroborado por Adan 2026: "prefabricated devices offer simplicity… fixed geometry limits utility" — https://pmc.ncbi.nlm.nih.gov/articles/PMC13332471/).
- Moldes de outros sítios que servem de referência de projeto:
  - **Zimmer StageOne Knee/Hip molds** (mesma plataforma silicone): técnica joelho https://www.zimmerbiomet.com/content/dam/zb-corporate/en/education-resources/surgical-techniques/specialties/cement/stageone-cement-spacer-molds/0440.3-US%20StageOne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 (manualslib: https://www.manualslib.com/manual/1704331/Zimmer-Biomet-Stageon-Series.html); hip "StageOne Select Reinforced 11×200 mm" ref. 431196 (https://www.brightmolar.com/products/zimmer-biomet-stageone-select-hip-spacer-molds-stageone-select-reinforced-hip-spacer-mold-11-mm-x-200-mm-stem-431196/).
  - **Heraeus Copal knee molds** (usados no estudo biomecânico de Lallinger 2025, molde M, 80 g Palacos R por componente — https://pmc.ncbi.nlm.nih.gov/articles/PMC12627201/).
  - **restor3D (EUA):** moldes customizados impressos em CoCr (ver §2) — serviço comercial ativo de molde custom (https://restor3d.com — via PMC8447608).

---

## 2. LITERATURA DE MOLDES 3D-IMPRESSOS PARA ESPAÇADORES DE CIMENTO COM ANTIBIÓTICO

Busca PubMed "3D printed mold antibiotic cement spacer" (2026-09-25): 8 resultados (https://pubmed.ncbi.nlm.nih.gov/?term=3D+printed+mold+antibiotic+cement+spacer). Detalhes de projeto extraídos dos textos completos:

### 2.1 Broughton et al. 2021 — tálus (3D Print Med 7:30; PMC8447608)
https://pmc.ncbi.nlm.nih.gov/articles/PMC8447608/
- **Material do molde:** liga **CoCrMo por SLM** (fusão a laser), interna **altamente polida** → minimiza irregularidades da superfície do spacer e facilita liberação. Precisão dimensional de 100 µm; camadas de 20–100 µm.
- **Duas metades ("clamshell")** com **linha de partição NÃO planar** (necessária para extração de geometria complexa); versões 95/100/105% de volume impressas para escolha intraoperatória.
- **Portas:** caso 1 = 2 portas cilíndricas (injeção dimensionada para bico de seringa de 60 cc + linha de vácuo para retirar ar); caso 2 = 1 porta única grande (injeção + escape de ar), posicionada **na linha de partição** e em região **não articular**; portas paralelas para facilitar retirada.
- **Preenchimento:** cimento misturado a vácuo, ainda viscoso → seringa 60 cc → injeção até transbordar em todas as portas; **moldes externamente fixados com clamps (Kocher)** para pressurização; 2 sachês de cimento + 2 g vancomicina por molde.
- **Agente de liberação: óleo mineral estéril** na superfície interna.
- **Custo/tempo:** ~US$ 8.000 por conjunto de moldes custom; **<5 dias** do design à produção; via FDA **custom device exemption** (sem predicado comercial).

### 2.2 Zheng et al. 2023 — tíbia proximal (Orthop Surg 15:2724; PMC10549869)
https://pmc.ncbi.nlm.nih.gov/articles/PMC10549869/
- **Molde híbrido em 4+1 componentes:** corpo impresso em **nylon (PA)**, extremidade articular usinada em **liga de titânio** (melhor superfície articular), fixados com **parafusos**; conceito de estrutura montável.
- **Agente de liberação: óleo de parafina** + **desmoldar antes da polimerização completa** (duas medidas anti-adesão).
- **Reforço estrutural do spacer:** liga de titânio envolta por cimento (aumenta resistência) + haste intramedular como suporte interno.
- Tabela-resumo dos casos prévios (Kong, Broughton, Exner, Teschke) incluída no artigo.

### 2.3 Kong et al. 2021 — joelho, molde de silicone 3D (Biomed Res Int 2021:3948638; PMC7884112)
https://pmc.ncbi.nlm.nih.gov/articles/PMC7884112/ (PMID 33628779)
- Spacer articulável desenhado em CAD e confeccionado **intraoperatoriamente em molde de silicone impresso em 3D**; 42 pacientes (22 estáticos vs 20 articuláveis). Motivação: preservar mobilidade/espaço e facilitar reimplantação.

### 2.4 Demais casos
- **Exner 2021** (raio, sarcoma; JBJS Case Connect; PMID 34019491): molde impresso a partir de TC do próprio osso, spacer endoprostético. https://pubmed.ncbi.nlm.nih.gov/34019491/
- **Qu 2023** (fêmur distal; Eur Rev Med Pharmacol Sci; PMID 37667927): spacer personalizado com molde 3D para infecção periarticular. https://pubmed.ncbi.nlm.nih.gov/37667927/
- **Liu 2021** (quadril; World J Clin Cases; PMC): spacer custom impresso para moldar cimento. https://pubmed.ncbi.nlm.nih.gov/34616833/
- **Zhang 2024** (quadril; Int J Antimicrob Agents 63:107080; PMID 38163551): avaliação clínica de spacers ALBC personalizados por impressão 3D em PJI de ATQ. https://pubmed.ncbi.nlm.nih.gov/38163551/
- **Alaseem 2026** (calcâneo, Ewing; Front Surg 13:1864578; PMC13381017): molde custom 3D, spacer PMMA fixado com 2 parafusos canulados; viável e de baixo custo. https://pmc.ncbi.nlm.nih.gov/articles/PMC13381017/
- **Teschke 2021** (mandíbula/ATM; J Craniomaxillofac Surg; PMID 34238634): spacer digitalmente desenhado. https://pubmed.ncbi.nlm.nih.gov/34238634/

### 2.5 Exotermia do cimento × material do molde impresso
- Cimento em **esferas de 2 cm** a 21 °C ambiente: pós-cura com núcleo a **~37–39 °C** (Palacos: 97,9±1,95 °F aquecido / 69,99±1,40 °F ambiente); temperatura máx registrada 107,2 °F (~42 °C), abaixo do limiar de termonecrose **53 °C/1 min** (Parikh et al., JAOAO 2024: https://journal.aoao.org/?p=973, citando Eriksson & Albrektsson 1984).
- Massas espessas de cimento (>3 cm) podem exceder 60–70 °C no núcleo e causar lesão térmica — espessura do manto importa (Li et al. 2023, citado em JAOAO 2024, ref. 18).
- Implicação para o molde: **PLA (Tg ~60 °C)** pode amolecer em cabeças grandes durante o pico exotérmico; literatura de moldes 3D preferiu **CoCrMo (SLM)**, **titânio** ou **nylon** quando a superfície articular importa (PMC8447608; PMC10549869). Para FDM doméstico, PETG/nylon/resina com Tg alto e paredes grossas (≥3–4 mm) são mais seguros; PLA aceitável para geometrias finas. Especificações de Tg do PLA: https://ultimaker.com/materials/pla (~60 °C).
- **Esterilização de moldes impressos:** a literatura recuperada não padroniza (Broughton/Zheng não descrevem ciclo de esterilização; molde restor3D usado em campo estéril com óleo mineral estéril). A prática relatada é molde de uso único manipulado em mesa estéril; PLA não tolera autoclave (121 °C > Tg) — alternativa: embalagem estéril pré-feita, EtO ou gama (compatíveis com PLA/PETG/resina), ou material metálico autoclavável. (Fonte: consideração de engenharia alinhada a PMC8447608 §técnica e material specs Ultimaker; nenhum estudo primário de esterilização de molde PLA recuperado — lacuna declarada.)
- **Agentes de liberação relatados:** óleo mineral (Broughton PMC8447608; Klosterman PMC7917196), óleo de parafina (Zheng PMC10549869).

---

## 3. BIOMECÂNICA DO ESPAÇADOR DE PMMA

### 3.1 Cimento com antibiótico × resistência
- **"Regra dos 10%":** adições de antibiótico acima de ~10% do volume do PMMA comprometem a resistência mecânica em corpos de prova (Lautenschlager et al. 1976, citado e discutido em Lallinger 2025, https://pmc.ncbi.nlm.nih.gov/articles/PMC12627201/).
- **Em espacers moldados, concentração importou pouco:** vancomicina 5% vs 20% (2 g vs 8 g por 40 g) não mudou força de ruptura (38,7±9,3 kN vs 35,5±5,8 kN, posição padrão; p=0,42). **Posição deslocada (10°) derrubou a carga de ruptura ~17×** (2,2±0,7 vs 2,0±0,3 kN) — posicionamento domina sobre dose de antibiótico (Lallinger 2025, acima).
- Contraexemplos em corpos de prova: 6 g vanco/40 g reduz resistência vs 2 g (Kwong, citado em Lallinger); vancomicina 2,5% v/v derruba resistência em cilindros (Gandomkarzadeh, citado em Lallinger — mínimo medido ~50 MPa, clinicamente tolerável); revisão geral de eluição×mecânica: von Hertzberg-Boelch 2022 (PMC9404960, https://pmc.ncbi.nlm.nih.gov/articles/PMC9404960/) e resistência de spacers PMMA: Lunz 2022 (BMC Musculoskelet Disord 23:945, PMC9617327, https://pmc.ncbi.nlm.nih.gov/articles/PMC9617327/).
- Fratura de spacer de joelho em séries clínicas: **5% (7/154)**, todas em componente femoral (porção mais fina) — Struelens, citado em Lallinger 2025.
- Cimento com ceftazidima+vancomicina: propriedades biomecânicas mantidas em doses clínicas (Reduan 2026, Indian J Orthop 60:93–99, https://pmc.ncbi.nlm.nih.gov/articles/PMC12799831/).

### 3.2 junção cabeça-haste, seção mínima e reforço
- Zimmer adverte: **não impactar o spacer com marreta → fratura**; 180 dias máx.; limitação mecânica inerente ao PMMA (técnica StageOne, PDF §1.1).
- InterSpace: **núcleo metálico (aço 316L)** como estrutura portante; sem impactação; órtese; qualquer dano/alteração reduz a resistência à fadiga (IFU §1.3).
- **Cimento puro tem durabilidade estrutural limitada e não distribui carga em osso comprometido** → spacer custom deve levar **reforço intramedular (haste de Rush central)**, princípio de *fracture bypass* (estender o constructo além de fratura/osteotomia/lise) e *load sharing* (Adan 2026, https://pmc.ncbi.nlm.nih.gov/articles/PMC13332471/ — 27/306 spacers da instituição eram custom com haste; 5 casos ilustrativos).
- "Frankenspacer" (cabeça pré-fabricada + haste intramedular umeral): **0 fraturas do spacer de haste longa** em 18 ombros (reinfeção 21,4%; **luxação glenoumeral 56%**; erosão glenoidal 83%; afrouxamento 11%; luxação sobe com gravidade de perda óssea PHAROS 2–3: 69% vs 20%) (Beady 2025, JSES Rev Rep Tech 5:685–692, https://pmc.ncbi.nlm.nih.gov/articles/PMC12573618/).
- Espacer definitivo permanente de ombro: erradicação **93%** (143 pacientes, 12 estudos) — opção em idosos de baixa demanda (Alessio-Mazzola 2020, HSS J 16:272–279, https://pmc.ncbi.nlm.nih.gov/articles/PMC7534885/).
- Dose típica nos moldes: vancomicina 2 g + tobramicina 3,6 g por sachê de 40 g (Klosterman PMC7917196); 2 g vanco por sachê em Broughton (PMC8447608); InterSpace usa 1,87% de gentamicina (IFU §1.3).

### 3.3 Complicações consolidadas
- Luxação/desgaste/afrouxamento/fratura listados como riscos do dispositivo no IFU InterSpace (PDF §1.3); taxa de luxação clínica altamente dependente de perda óssea e tensão de partes moles (Beady, acima); erosão glenoidal quase universal em seguem série (83%, Beady).

---

## 4. ANATOMIA — CABEÇA HUMERAL, CANAL, NSA, RETROVERSÃO

- **Diâmetro de resseção anatômica (sistema Aequalis Ascend Flex/Stryker):** cut protectors de **35, 40 e 45 mm**, com **múltiplas espessuras de cabeça por diâmetro** para tensionar a articulação sem mudar o diâmetro de resseção (técnica oficial: https://www.bmgorthopaedics.com/wp-content/uploads/2020/01/95_Ascend-flex-surgical-technique_file1.pdf; idem Stryker: https://www.stryker.com/content/dam/stryker/trauma-and-extremeties/products/tornier-flex/resources/Tornier%2520Flex%2520Shoulder%2520System%2520Operative%2520Techniq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).
- **Envelope comercial de cabeças de spacer:** Ø 41–58 mm; espessura 16–24 mm; razão espessura/diâmetro ~**0,37–0,44** (Zimmer 42×18→58×24, brochura §1.1; Tecres 41×16 e 46×22, IFU §1.3; Wright 43×16/48×18/52×23, PMC7917196).
- **Cabeça "oversized":** os catálogos de molde já vão a 58 mm (Zimmer 431414) e 46 mm (Tecres) — prática corrente de ligeiro aumento; porém **overstuffing** deve ser evitado e a cabeça deve permitir **subluxação de ~50%** no teste de estabilidade (técnica Ascend Flex, PDF acima; Adan 2026 "head size shaped to approximate native tension while avoiding overstuffing"). Luxação do spacer correlaciona-se com perda óssea, não com superdimensionamento isolado (Beady 2025).
- **Inclinação (NSA):** corte anatômico médio **130–135°**; o sistema Ascend Flex usa guia de inclinação ajustável e opção fixa **132,5°**; 145° é o grammont reverso (técnica Ascend Flex PDF, linhas "fixed inclination of 132.5°" / "145° humeral inclination").
- **Retroversão:** referência **20–40°** — InterSpace manda posicionar "aproximadamente **40° de retroversion**" (IFU §1.3); técnica Ascend usa vareta de versão. **Não mensurável sem TC com cotovelo** (referência transepicondilar) — apenas nota de planejamento.
- **Canal umeral / reamers:** reamers Comprehensive **4–20 mm**, broaches mini **4–17 mm** (técnica StageOne, PDF §1.1) — hastes de spacer comerciais cobrem 6–14 mm (Zimmer) e 7–11 mm (Tecres); Klosterman usa tamanhos 2/4/6/8 (Wright) + tubo torácico distal 24–34 Fr (Ø 8–11,3 mm; 1 Fr = 1/3 mm) (PMC7917196).

---

## 5. DADOS DE TRABALHO DO CIMENTO (Palacos e congêneres)

- **Composição do sachê:** Palacos R/ HV: ~40,3 g pó + 20 g/20 ml líquido (Parikh/JAOAO 2024, https://journal.aoao.org/?p=973); Palacos R pro 1×40 g similar (IFU Heraeus — PDF oficial bloqueado ao fetch; espelho manual.plus: https://manuals.plus/m/f47f4b3c68505833ed15e426bf94c18d8dd43f4d355a74876ae16b3b1e38e727.pdf).
- **Tempos (medida direta, esfera 2 cm, 21 °C/70 °F):** Palacos LV/HV **endureceu em 813±91 s (~13,6 min)**; em banho salino a 41 °C/106 °F: **326±23 s (~5,4 min)** — banho quente acelera ~8 min (Parikh/JAOAO 2024). Fases (espera → massa/dough → aplicação → cura): aplicação quando não adere à luva ("doctor finger test"); armazenamento recomendado 23 °C (IFU Palacos espelhado em manuals.plus; revisão de manuseio: Funk 2021, https://link.springer.com/article/10.1186/s13018-015-0320-7 para efeito de temperatura).
- **Exotermia:** pós-cura em esfera de 2 cm: núcleo ~**21 °C (ambiente) a 37–39 °C (aquecido)**, pico máx registrado ~42 °C; termonecrose óssea >53 °C por >1 min; >47 °C já reduz formação óssea (Parikh/JAOAO 2024, citando Eriksson/Albrektsson).
- **Volume por sachê de 40 g:** ≈ **20–25 cm³** de cimento moldado (estimativa derivada dos catálogos: molde 6 mm + cabeça 42 mm consome 1 sachê; 8–14 mm consomem 2 sachês — Zimmer brochura §1.1; tálus anatômico adulto consome 2 sachês — Broughton PMC8447608). *Nenhum fabricante publica cm³/sachê na documentação recuperada — valor por dedução das tabelas oficiais.*
- **Demanda do spacer umeral (cabeça + haste proximal):** **2 sachês de 40 g (≈40–55 cm³)** para os tamanhos 8–14 mm; 1 sachê para 6 mm (Zimmer brochura). Klosterman: Palacos + vanco 2 g + tobra 3,6 g por sachê (PMC7917196).
- Mistura a vácuo recomendada (PALAMIX/ClearMix) para reduzir porosidade (Lallinger PMC12627201; Zimmer técnica).

---

## Implicações para o design (gerador paramétrico)

| Parâmetro | Recomendação | Fonte-chave |
|---|---|---|
| Diâmetro da cabeça | **40–58 mm, passo 2–3 mm (5–7 opções)**, esfera lisa; envelope comercial 41–58 | Zimmer brochura; Tecres IFU; PMC7917196 |
| Espessura da cabeça | **16–24 mm**; razão espessura/Ø ≈ **0,38–0,43**; evitar overstuffing (subluxação ~50%) | catálogos §1; técnica Ascend Flex |
| Cabeça maior que a nativa | Permitir **+2–4 mm** para articulação/estabilidade; benefício não comprovado, luxação depende mais de perda óssea/tensão | Beady 2025; Adan 2026 |
| NSA (inclinação do colo) | **130–135° (default 132,5°)** | técnica Ascend Flex |
| Retroversão | **20–40° só como nota** (referência; não mensurável sem TC de cotovelo) | IFU InterSpace |
| Ø do haste proximal | **8–14 mm, passo 2 mm** (= diâmetro do reamer usado; canal reável 4–20 mm) | Zimmer técnica; Tecres IFU |
| Comprimento do haste proximal | **100–125 mm** (Zimmer 122; Tecres 125/99) | Zimmer; Tecres |
| Extensão distal | Canal central para **haste-guia 2,5 mm (ponta esférica)** + tubo torácico 24–34 Fr (Ø 8–11,3 mm) | PMC7917196 |
| Junção cabeça-haste | Corpo metafisário robusto contínuo; **filete/radius ≥ 6–8 mm** na transição (fratura ocorre na seção fina — análogo femoral 5%); sem impactação com marreta | Lallinger; Zimmer técnica |
| Reforço opcional | Canal axial para **haste intramedular (Rush)** quando bypass de fratura/lise for necessário | Adan 2026 |
| Volume/cimento | **2× sachês 40 g** (tamanhos ≥8 mm); dose típica vanco 2 g + tobra 3,6 g/sachê; manter antibiótico total ≤ ~10% p/p quando a resistência for crítica (em spacer moldado, evidência tolera até 20% vanco) | Zimmer; PMC7917196; PMC12627201 |
| Molde: partição | **Duas metades (ant./post.) com linha de partição preferencialmente não plana** através do equador da cabeça e do eixo do haste; pinos cônico-troncocilíndricos **Ø 4–6 mm, profundidade 8–10 mm, 3–4 pinos** | PMC8447608 |
| Molde: portas | 1 porta de injeção **Ø 8–12 mm** (bico de seringa/cartucho) em região não articular (ápice da cabeça) + **1–2 vents Ø 2–3 mm** na extremidade distal do haste e na linha de partição; encher até transbordar; clamp externo | PMC8447608; Zimmer técnica |
| Molde: parede | **≥3–4 mm** (polímero FDM/resina); interna lisa/polida; considerar metal (CoCr/Ti) ou nylon para produção de superfície articular crítica | PMC8447608; PMC10549869 |
| Material do molde vs exotermia | PLA (Tg ~60 °C) só para geometrias finas; **PETG/nylon/resina Tg alta** para cabeças grandes (massa >3 cm pode superar 60–70 °C) | JAOAO 2024; spec PLA Ultimaker |
| Esterilização | Molde de uso único: embalagem estéril/EtO/gama; **PLA não vai à autoclave**; metal pode | lacuna na literatura (declarado §2.5) |
| Liberação | **Óleo mineral estéril** (ou parafina) na interna; desmoldar após cura completa (corte do flash com lâmina 12) | PMC8447608; PMC10549869; PMC7917196 |
| Instruções do dispositivo | Máx. **180 dias**; inserção manual; órtese; sem lavagem aquosa do spacer | Zimmer; IFU InterSpace |

### Fontes inacessíveis / substituídas
- tecres.it e tecres.com `/products/interspace` → 404; substituído pela subcategoria `spacer-for-shoulder` + IFU OsteoRemedies (PDF extraído integralmente).
- IFU Palacos em heraeus-medical.com → bloqueio (HTML); substituído por espelho manuals.plus + dados medidos JAOAO 2024.
- pubmed.ncbi.nlm.nih.gov direto → reCAPTCHA; usado Europe PMC REST + PMC full text.
- Catálogo Stryker do molde Aequalis spacer → indisponível on-line; catálogo tomado de Klosterman 2021 (PMC7917196).
- Orthobullets shoulder arthroplasty → URL resolveu página errada (ALS); anatomia obtida via técnica oficial Ascend Flex + catálogos.
