bgobbato/spacer_shoulder/molde/render/C_h44_28Fr_closed.png

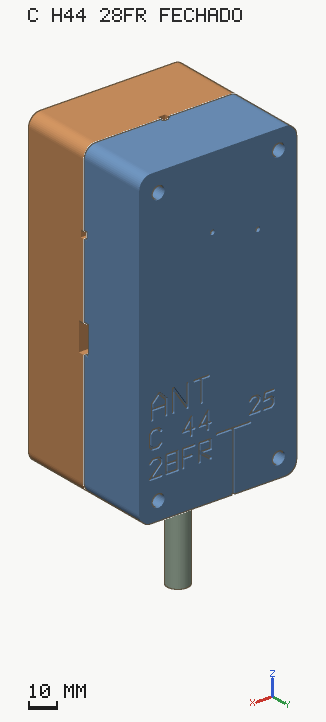
molde/render/C_h44_28Fr_closed.png
