bgobbato/spacer_shoulder/molde/render/C_h44_28Fr_distal.png

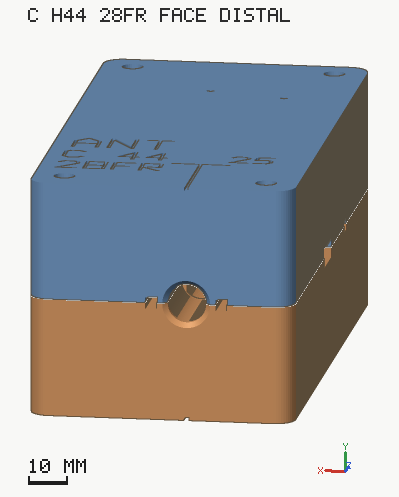
molde/render/C_h44_28Fr_distal.png
