bgobbato/spacer_shoulder/molde/render/C_h44_28Fr_exploded.png

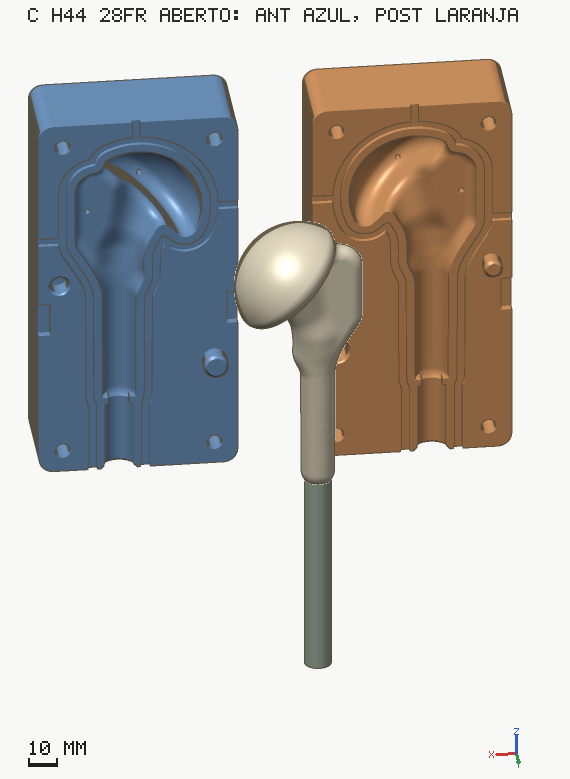
molde/render/C_h44_28Fr_exploded.png
