bgobbato/spacer_shoulder/molde/render/C_h44_28Fr_face_ANT.png

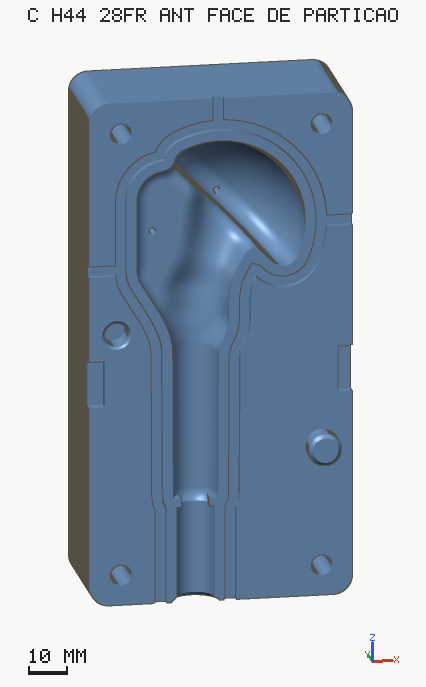
molde/render/C_h44_28Fr_face_ANT.png
