bgobbato/spacer_shoulder/molde/render/C_h44_28Fr_outer_ANT.png

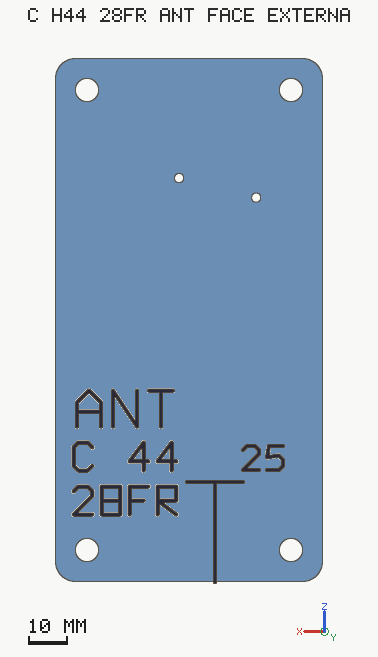
molde/render/C_h44_28Fr_outer_ANT.png
