bgobbato/spacer_shoulder/molde/render/C_h44_28Fr_outer_POST.png

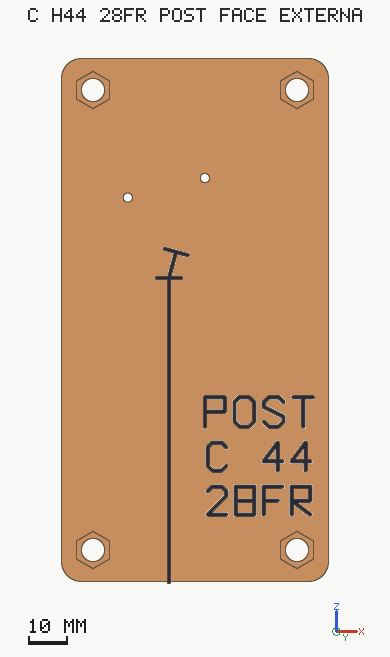
molde/render/C_h44_28Fr_outer_POST.png
