bgobbato/spacer_shoulder/molde/render/C_h44_28Fr_sheet.png

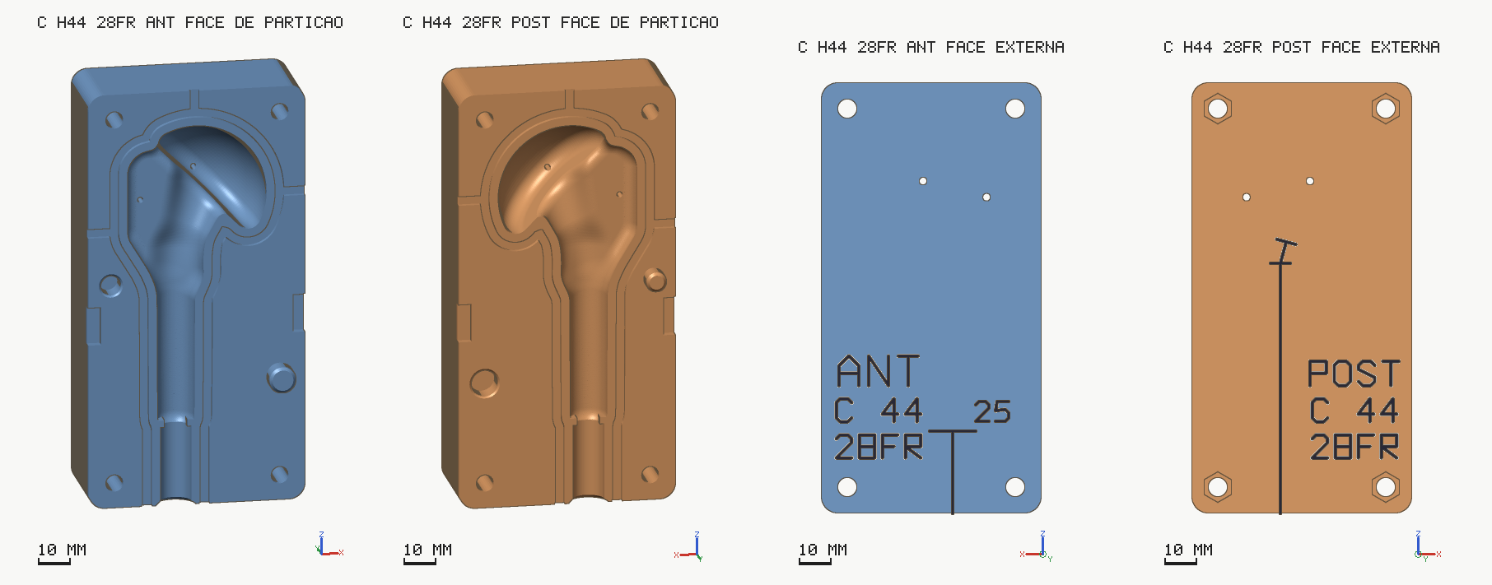
molde/render/C_h44_28Fr_sheet.png
