bgobbato/spacer_shoulder/molde/render/C_h52_28Fr_distal.png

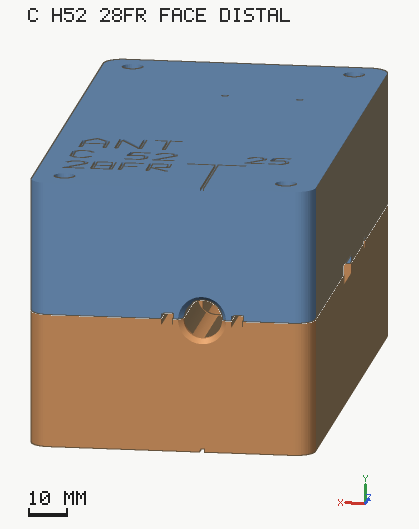
molde/render/C_h52_28Fr_distal.png
