bgobbato/spacer_shoulder/molde/render/C_longo_h44_closed.png

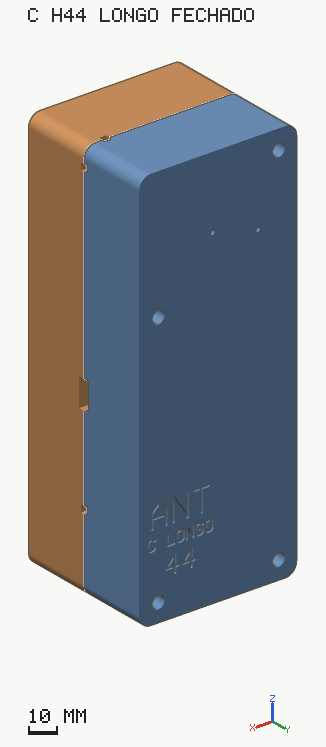
molde/render/C_longo_h44_closed.png
