bgobbato/spacer_shoulder/molde/render/C_longo_h44_distal.png

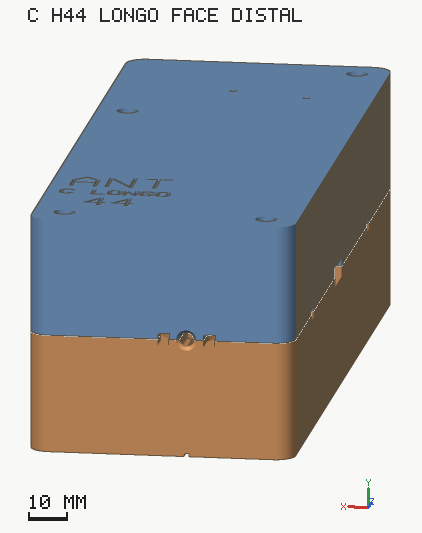
molde/render/C_longo_h44_distal.png
