bgobbato/spacer_shoulder/molde/render/C_longo_h44_face_POST.png

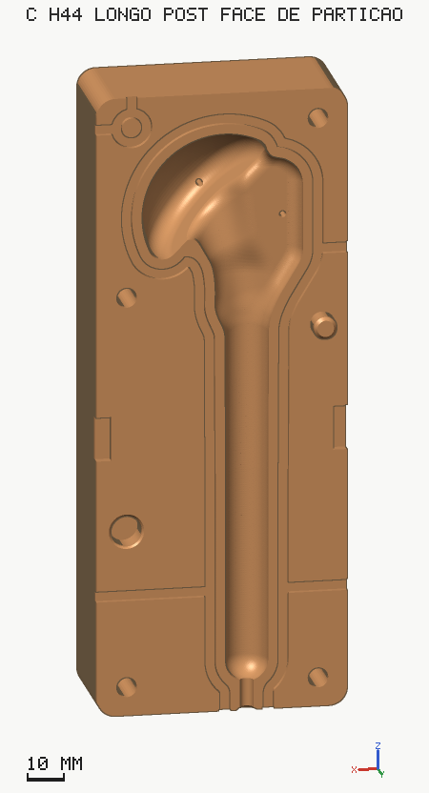
molde/render/C_longo_h44_face_POST.png
