bgobbato/spacer_shoulder/molde/render/C_longo_h44_mesa_ANT.png

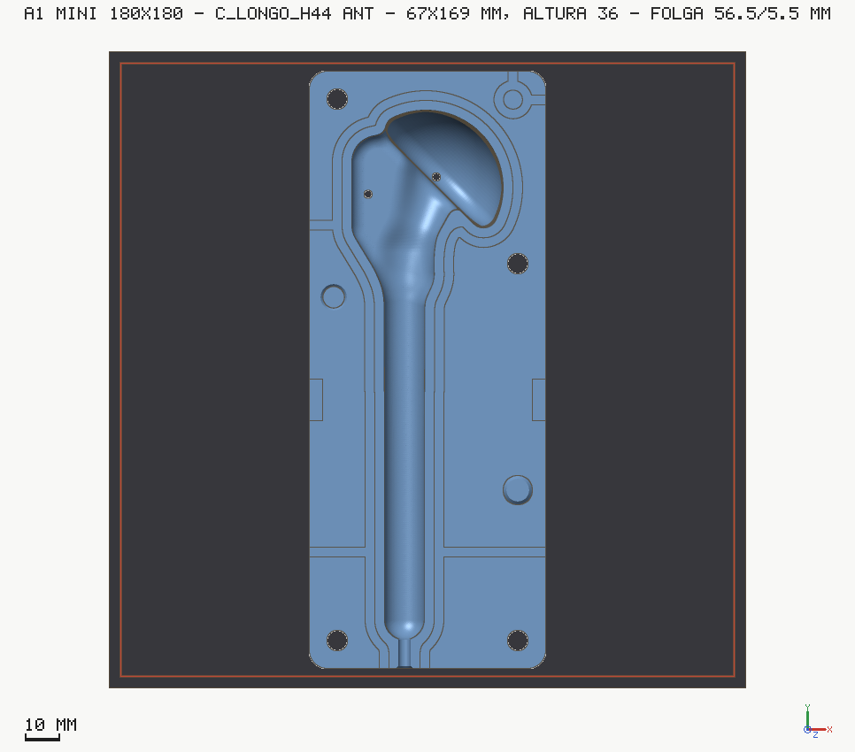
molde/render/C_longo_h44_mesa_ANT.png
