bgobbato/spacer_shoulder/molde/render/C_longo_h44_outer_ANT.png

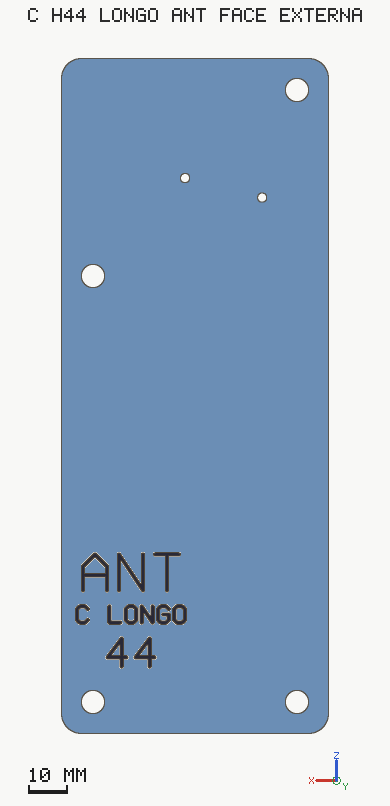
molde/render/C_longo_h44_outer_ANT.png
