bgobbato/spacer_shoulder/molde/render/C_longo_h44_outer_POST.png

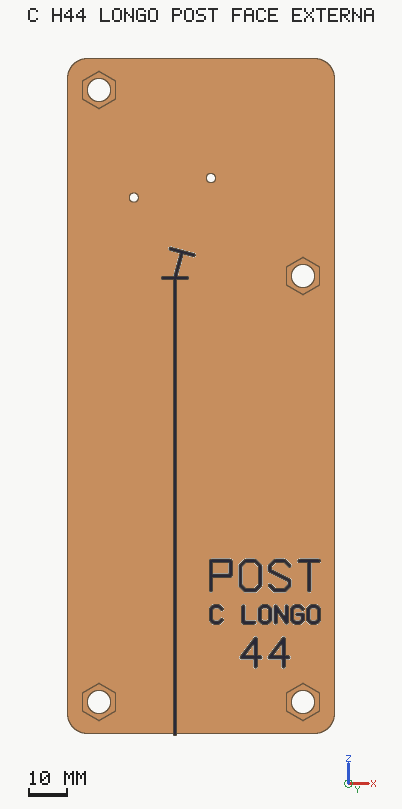
molde/render/C_longo_h44_outer_POST.png
