bgobbato/spacer_shoulder/molde/render/C_longo_h48_face_ANT.png

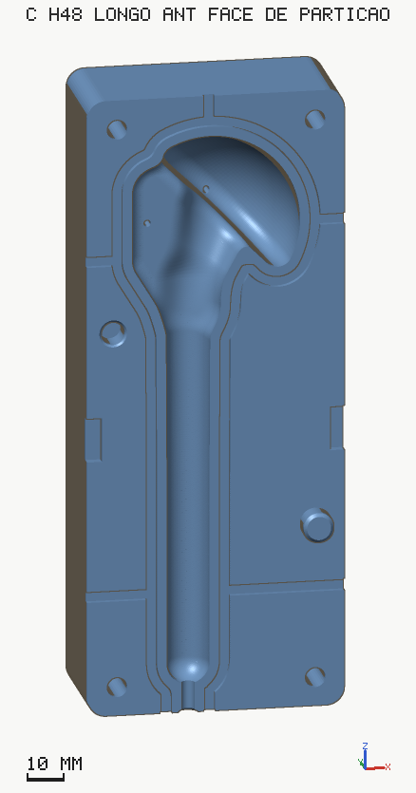
molde/render/C_longo_h48_face_ANT.png
