bgobbato/spacer_shoulder/molde/render/C_longo_h48_outer_POST.png

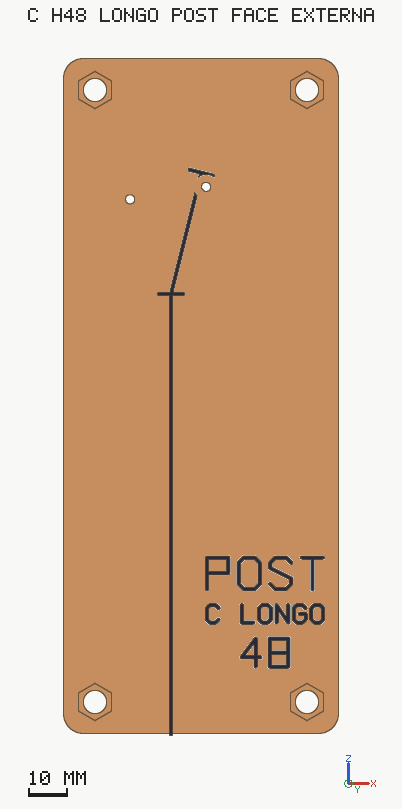
molde/render/C_longo_h48_outer_POST.png
