bgobbato/spacer_shoulder/molde/render/C_longo_h52_distal.png

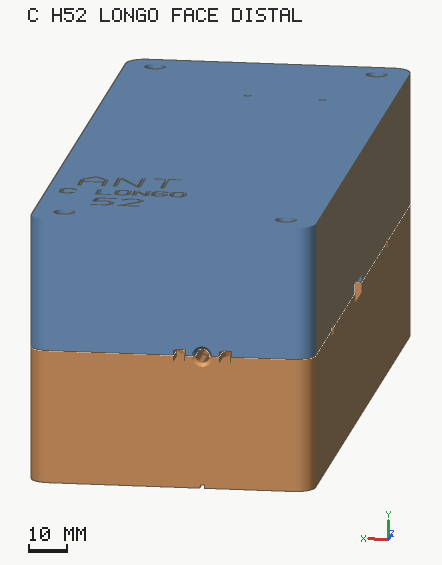
molde/render/C_longo_h52_distal.png
