bgobbato/spacer_shoulder/positivo/render/_example_h44_front.png

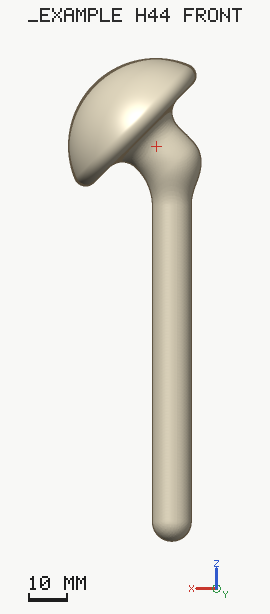
positivo/render/_example_h44_front.png
