bgobbato/spacer_shoulder/positivo/render/_example_h44_lateral.png

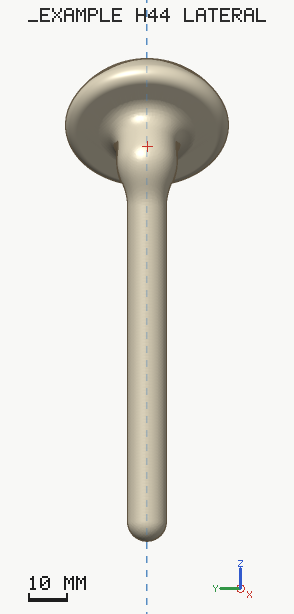
positivo/render/_example_h44_lateral.png
