bgobbato/spacer_shoulder/positivo/render/_example_h44_oblique.png

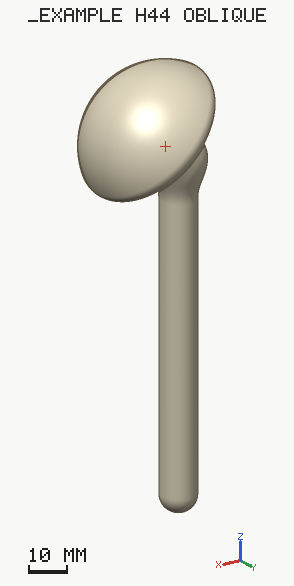
positivo/render/_example_h44_oblique.png
