bgobbato/spacer_shoulder/positivo/render/_example_h44_sheet.png

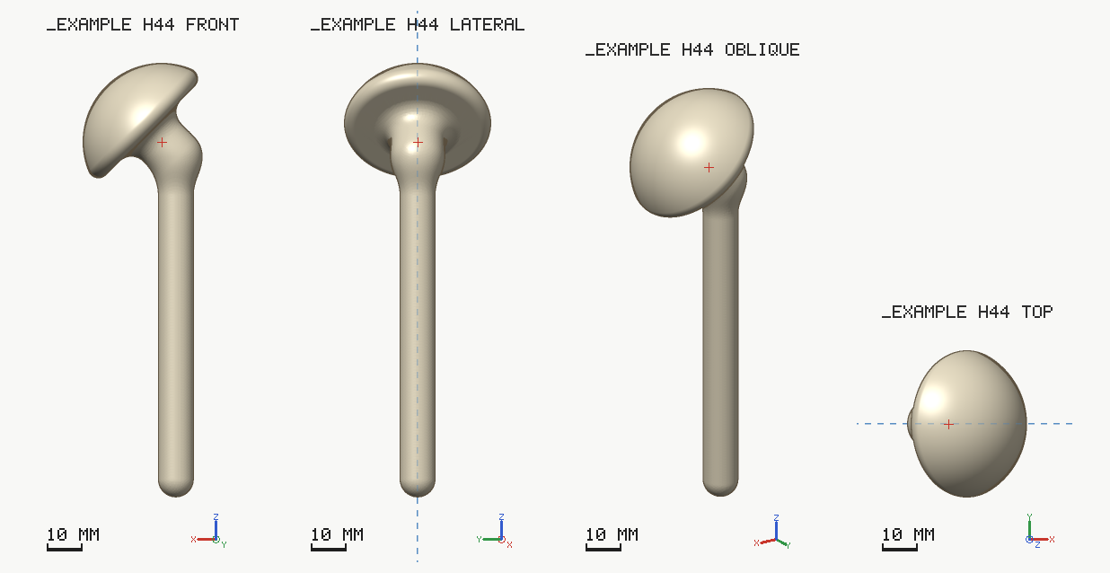
positivo/render/_example_h44_sheet.png
