bgobbato/spacer_shoulder/positivo/render/_example_h44_top.png

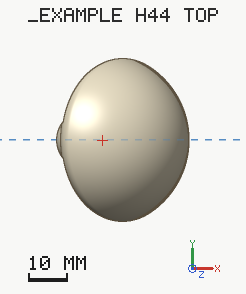
positivo/render/_example_h44_top.png
