bgobbato/spacer_shoulder/positivo/render/_example_h48_front.png

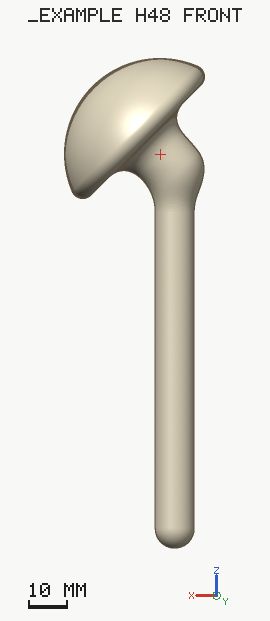
positivo/render/_example_h48_front.png
