bgobbato/spacer_shoulder/positivo/render/_example_h48_lateral.png

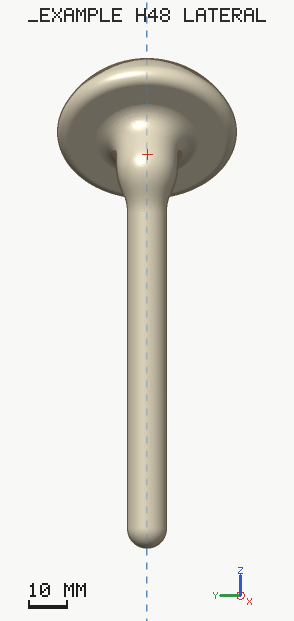
positivo/render/_example_h48_lateral.png
