bgobbato/spacer_shoulder/positivo/render/_example_h48_top.png

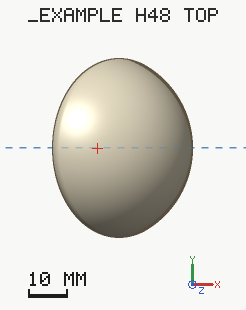
positivo/render/_example_h48_top.png
