bgobbato/spacer_shoulder/positivo/render/_example_h52_front.png

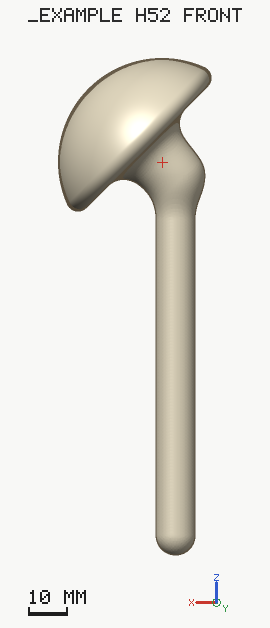
positivo/render/_example_h52_front.png
