bgobbato/spacer_shoulder/positivo/render/_example_h52_top.png

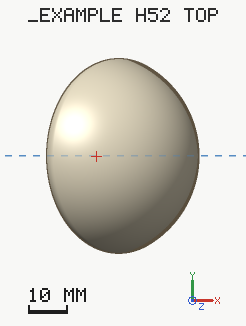
positivo/render/_example_h52_top.png
