bgobbato/spacer_shoulder/positivo/render/A_h44_front.png

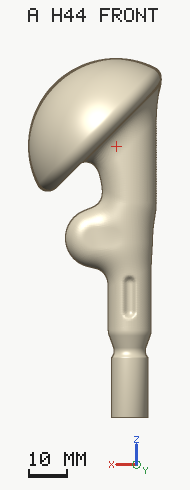
positivo/render/A_h44_front.png
