bgobbato/spacer_shoulder/positivo/render/A_h44_lateral.png

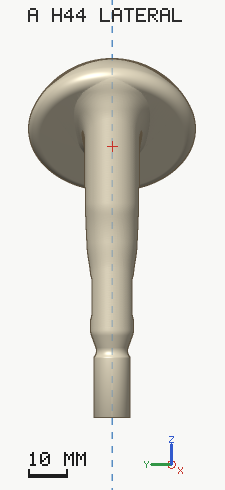
positivo/render/A_h44_lateral.png
