bgobbato/spacer_shoulder/positivo/render/A_h44_oblique.png

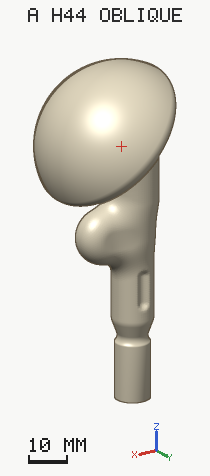
positivo/render/A_h44_oblique.png
