bgobbato/spacer_shoulder/positivo/render/A_h44_sheet.png

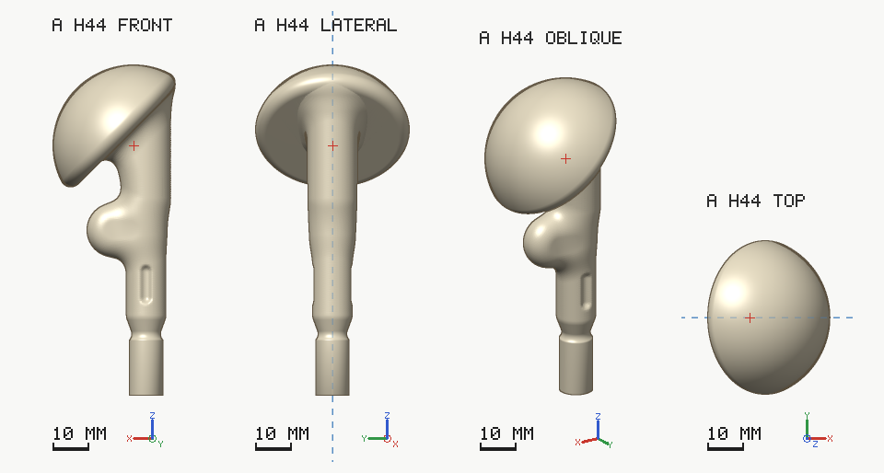
positivo/render/A_h44_sheet.png
