bgobbato/spacer_shoulder/positivo/render/A_h44_top.png

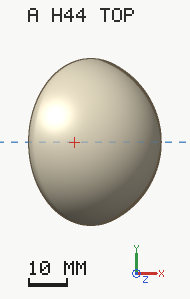
positivo/render/A_h44_top.png
