bgobbato/spacer_shoulder/positivo/render/A_h48_oblique.png

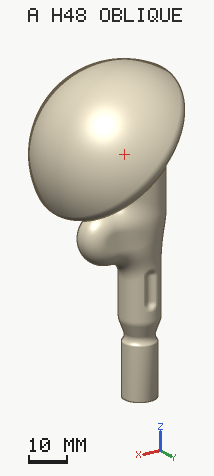
positivo/render/A_h48_oblique.png
