bgobbato/spacer_shoulder/positivo/render/A_h48_top.png

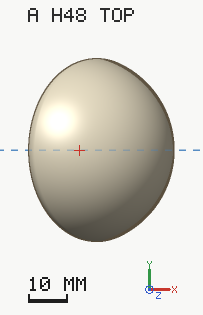
positivo/render/A_h48_top.png
