bgobbato/spacer_shoulder/positivo/render/A_h52_front.png

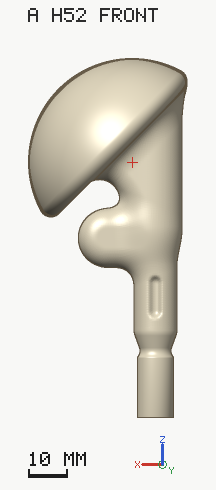
positivo/render/A_h52_front.png
