bgobbato/spacer_shoulder/positivo/render/A_h52_lateral.png

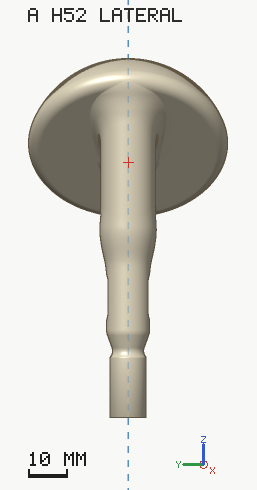
positivo/render/A_h52_lateral.png
