bgobbato/spacer_shoulder/positivo/render/A_h52_oblique.png

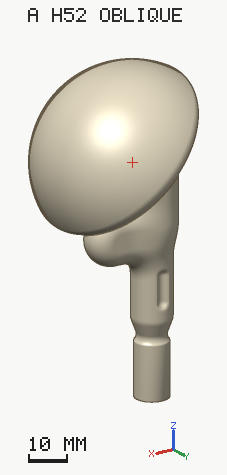
positivo/render/A_h52_oblique.png
