bgobbato/spacer_shoulder/positivo/render/A_h52_top.png

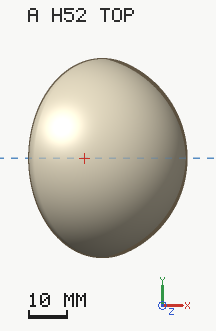
positivo/render/A_h52_top.png
