bgobbato/spacer_shoulder/positivo/render/B_h44_front.png

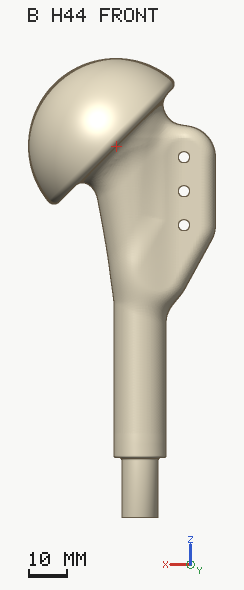
positivo/render/B_h44_front.png
