bgobbato/spacer_shoulder/positivo/render/B_h44_lateral.png

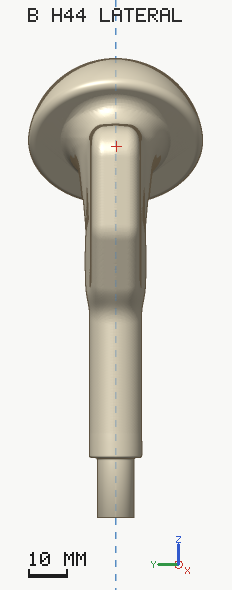
positivo/render/B_h44_lateral.png
