bgobbato/spacer_shoulder/positivo/render/B_h44_oblique.png

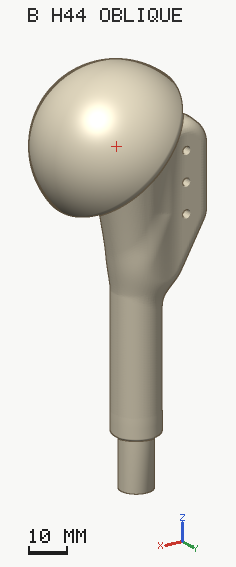
positivo/render/B_h44_oblique.png
