bgobbato/spacer_shoulder/positivo/render/B_h44_top.png

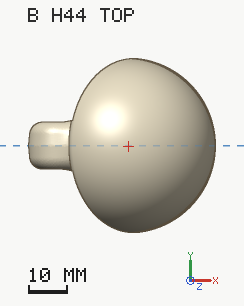
positivo/render/B_h44_top.png
