bgobbato/spacer_shoulder/positivo/render/B_h48_top.png

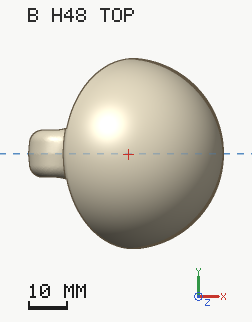
positivo/render/B_h48_top.png
