bgobbato/spacer_shoulder/positivo/render/B_h52_front.png

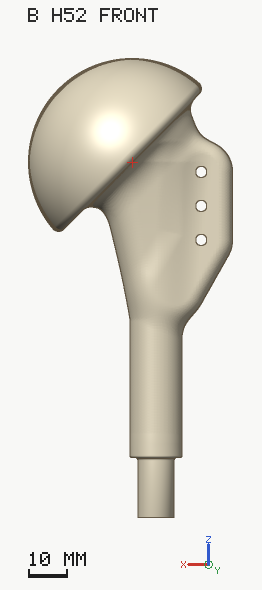
positivo/render/B_h52_front.png
