bgobbato/spacer_shoulder/positivo/render/B_h52_lateral.png

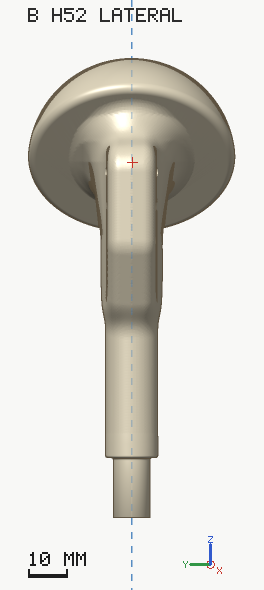
positivo/render/B_h52_lateral.png
