bgobbato/spacer_shoulder/positivo/render/B_h52_oblique.png

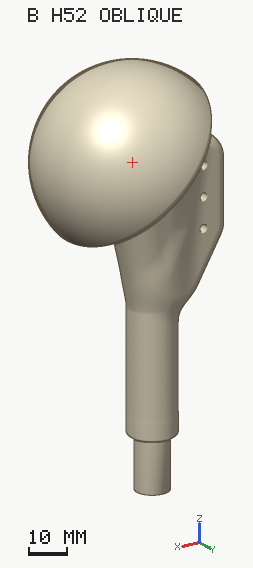
positivo/render/B_h52_oblique.png
