bgobbato/spacer_shoulder/positivo/render/B_h52_top.png

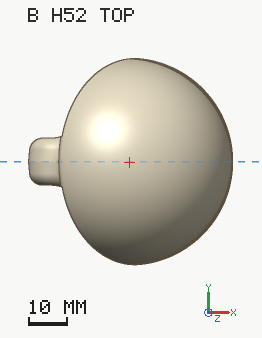
positivo/render/B_h52_top.png
