bgobbato/spacer_shoulder/positivo/render/C_h44_lateral.png

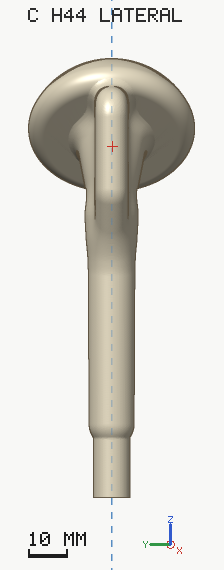
positivo/render/C_h44_lateral.png
