bgobbato/spacer_shoulder/positivo/render/C_h44_oblique.png

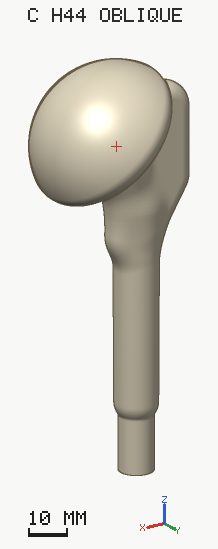
positivo/render/C_h44_oblique.png
