bgobbato/spacer_shoulder/positivo/render/C_h52_front.png

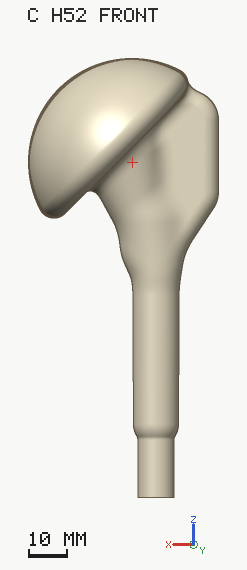
positivo/render/C_h52_front.png
