bgobbato/spacer_shoulder/positivo/render/C_h52_oblique.png

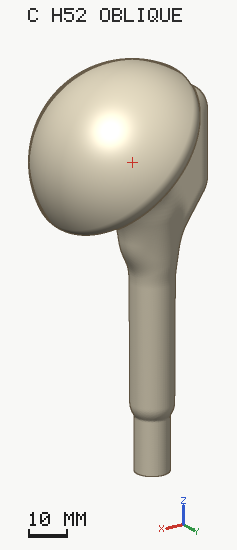
positivo/render/C_h52_oblique.png
