bgobbato/spacer_shoulder/positivo/render/C_longo_h44_oblique.png

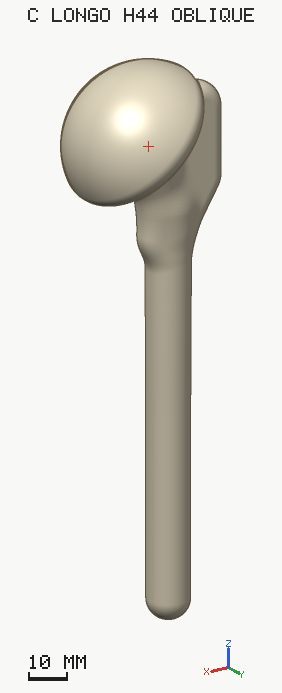
positivo/render/C_longo_h44_oblique.png
