bgobbato/spacer_shoulder/positivo/render/C_longo_h44_top.png

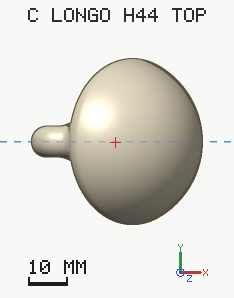
positivo/render/C_longo_h44_top.png
