bgobbato/spacer_shoulder/positivo/render/C_longo_h48_top.png

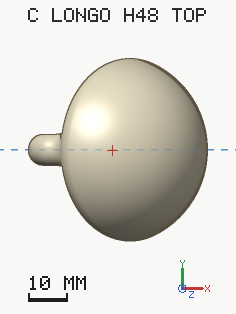
positivo/render/C_longo_h48_top.png
