bgobbato/spacer_shoulder/positivo/render/C_longo_h52_lateral.png

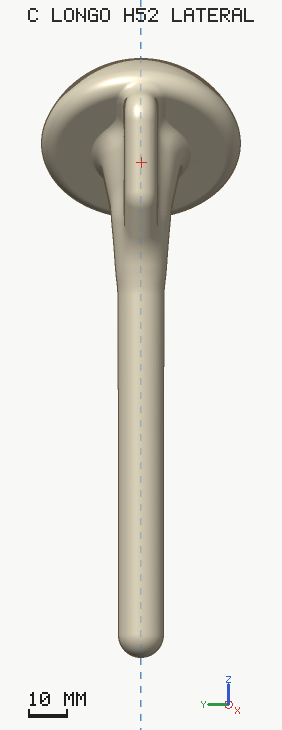
positivo/render/C_longo_h52_lateral.png
