bgobbato/spacer_shoulder/positivo/render/C_longo_h52_top.png

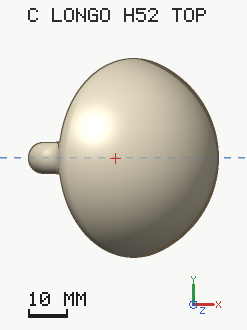
positivo/render/C_longo_h52_top.png
