bgobbato/spacer_shoulder/positivo/render/compare_front.png

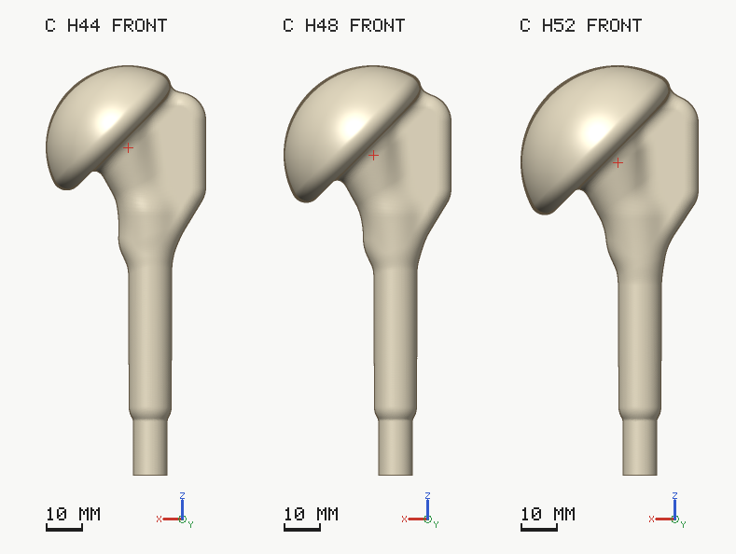
positivo/render/compare_front.png
