bgobbato/spacer_shoulder/positivo/render/compare_lateral.png

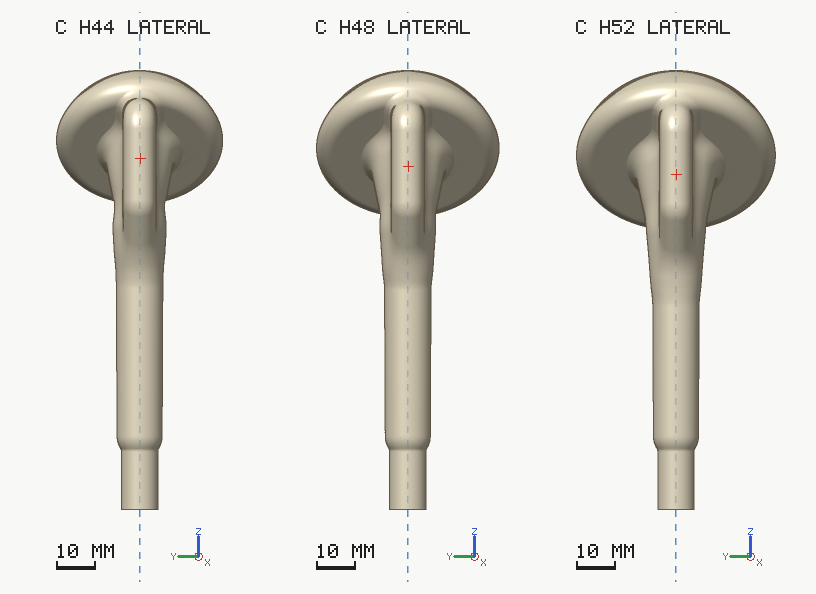
positivo/render/compare_lateral.png
