bgobbato/spacer_shoulder/positivo/render/compare_oblique.png

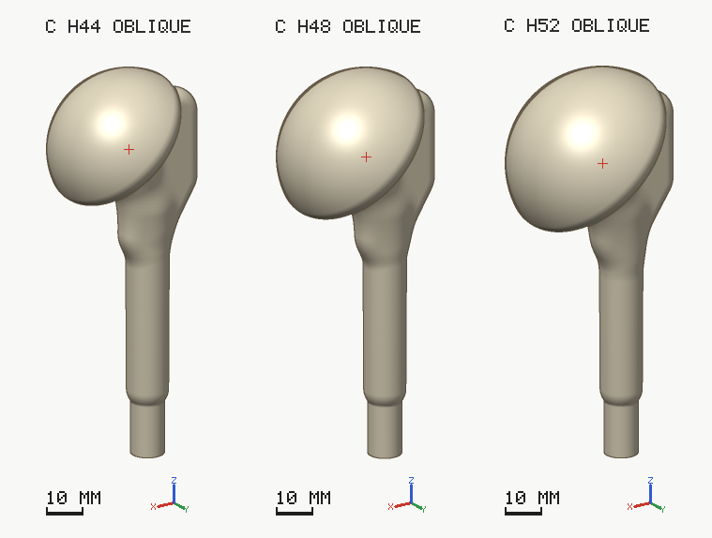
positivo/render/compare_oblique.png
