bgobbato/spacer_shoulder/positivo/render/compare_top.png

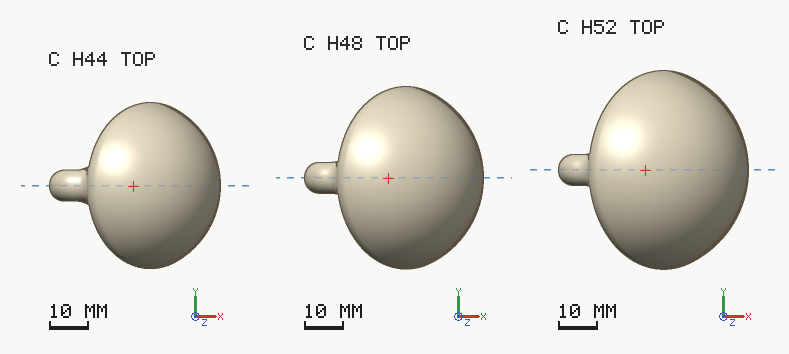
positivo/render/compare_top.png
