bgobbato/spacer_shoulder/review/AVALIACAO_FABLE_secoes_h48_s10.png

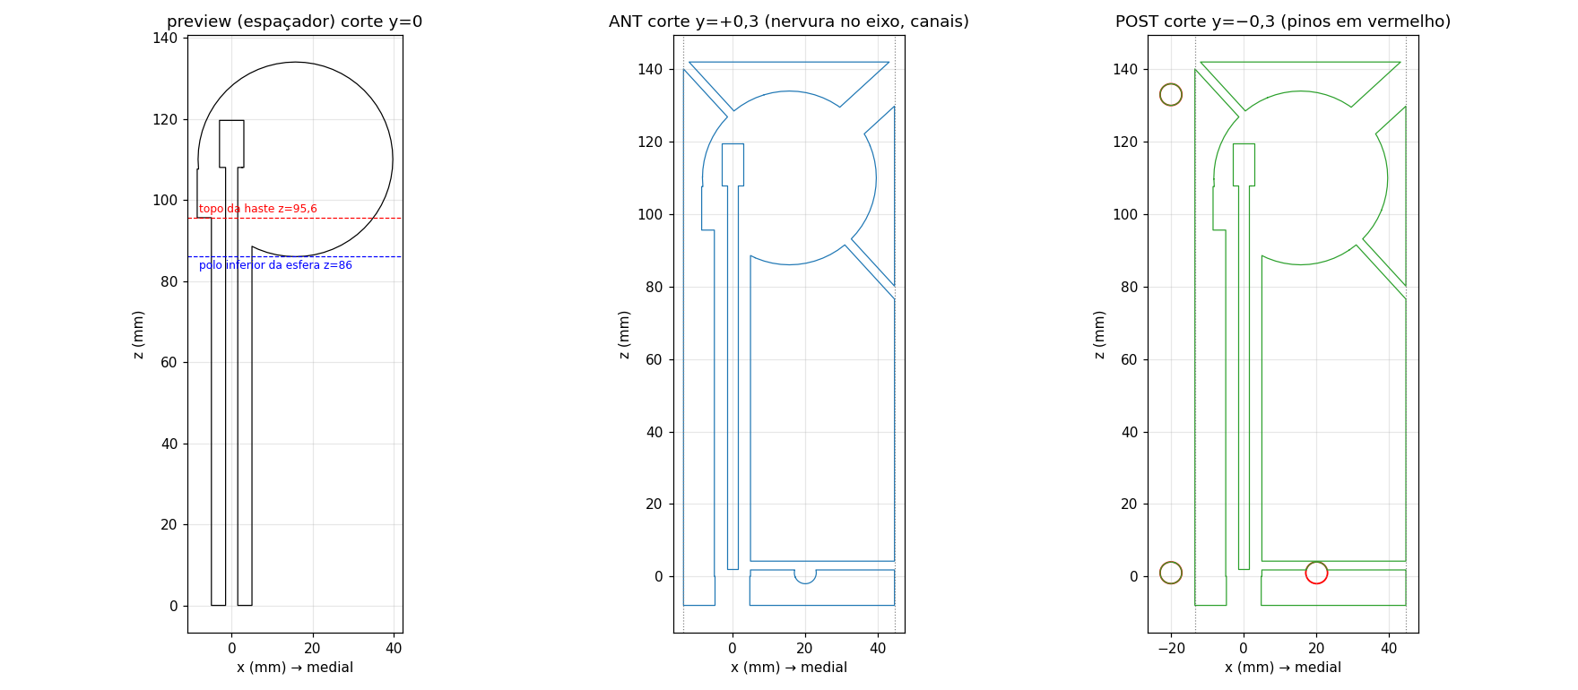
review/AVALIACAO_FABLE_secoes_h48_s10.png
