bgobbato/spacer_shoulder/stl/C_curto_dreno/C_h48_28Fr_ANT.stl

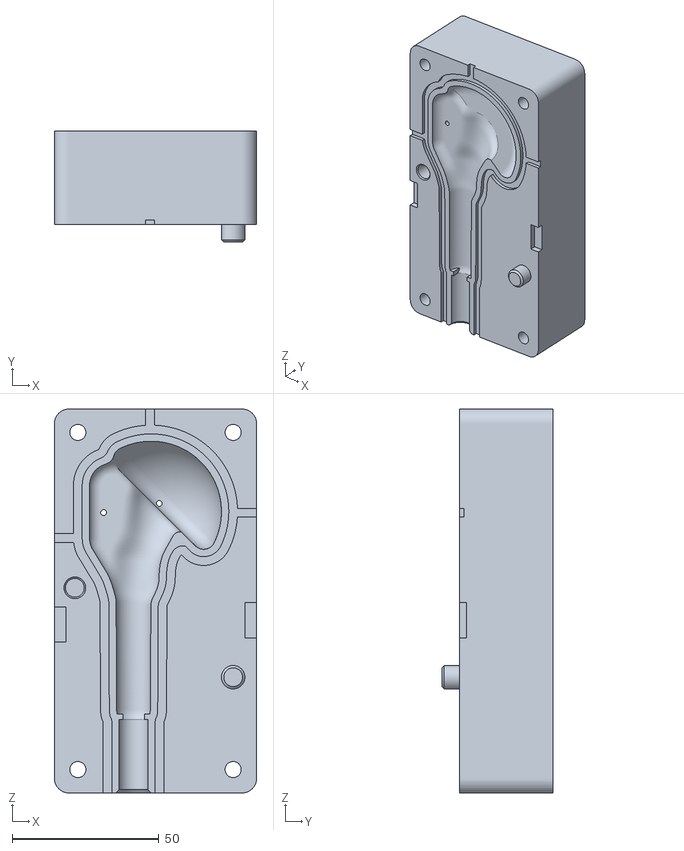
[picture p76: CAD file, 2026-10-12]
stl/C_curto_dreno/C_h48_28Fr_ANT.stl
69.0 x 38.0 x 131.0
