bgobbato/spacer_shoulder/stl/C_longo/C_longo_h52_ANT_mesa.stl

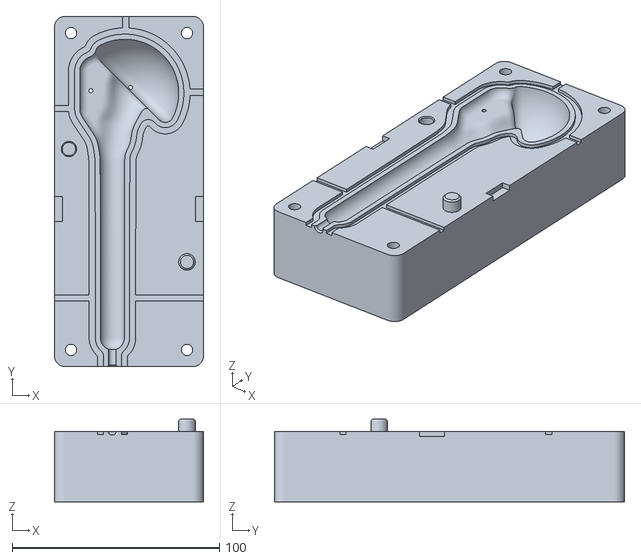
[picture p77: CAD file, 2026-10-12]
stl/C_longo/C_longo_h52_ANT_mesa.stl
72.0 x 169.0 x 40.0
