bgobbato/spacer_shoulder/stl/cupons/cupom_pinos_FEMEA.stl

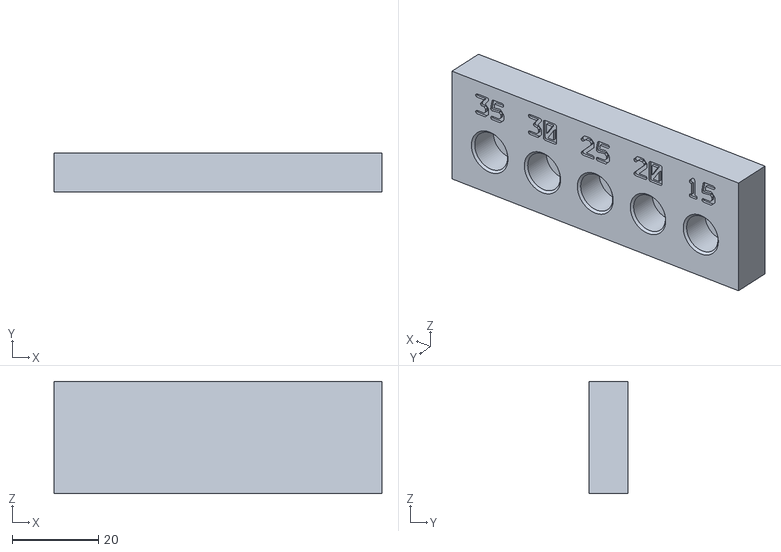
[picture p78: CAD file, 2026-10-12]
stl/cupons/cupom_pinos_FEMEA.stl
76.0 x 9.00 x 26.0
