bgobbato/spacer_shoulder/stl/padrao/C_longo_h52.stl

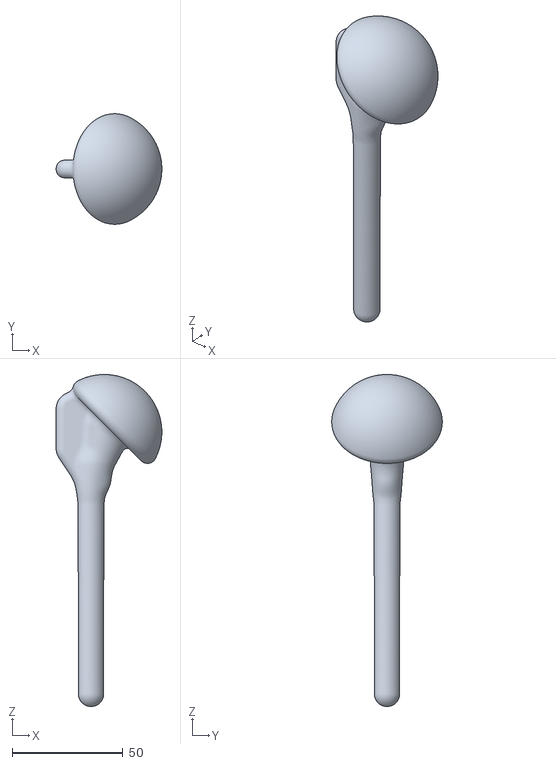
[picture p79: CAD file, 2026-10-12]
stl/padrao/C_longo_h52.stl
47.7 x 50.0 x 150.0
