bgobbato/spacer_shoulder/stl/positivos/C_h52.stl

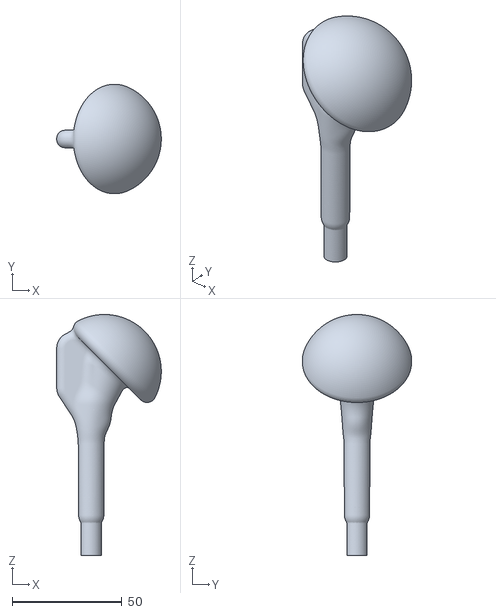
[picture p80: CAD file, 2026-10-12]
stl/positivos/C_h52.stl
47.7 x 50.0 x 110.0
