bgobbato/spacer_shoulder/stl/C_curto_dreno/C_h52_28Fr_ANT.stl

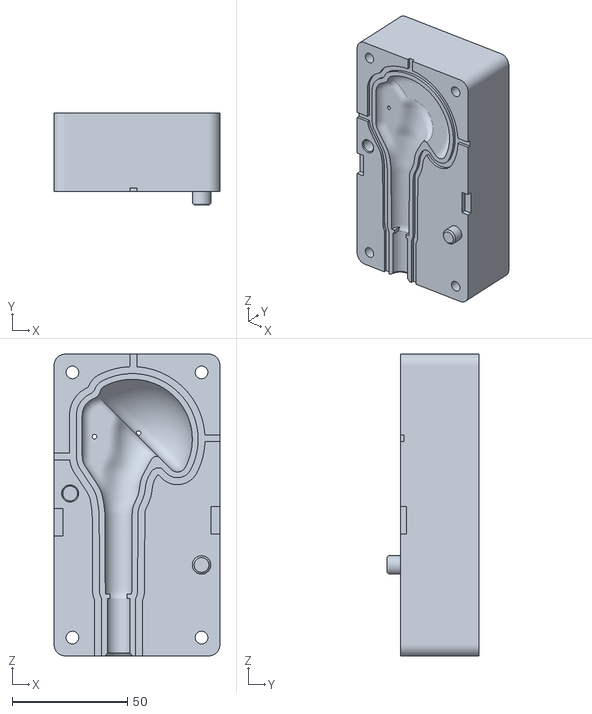
[picture p81: CAD file, 2026-10-12]
stl/C_curto_dreno/C_h52_28Fr_ANT.stl
72.0 x 40.0 x 131.0
