bgobbato/spacer_shoulder/stl/C_longo/C_longo_h44_ANT_mesa.stl

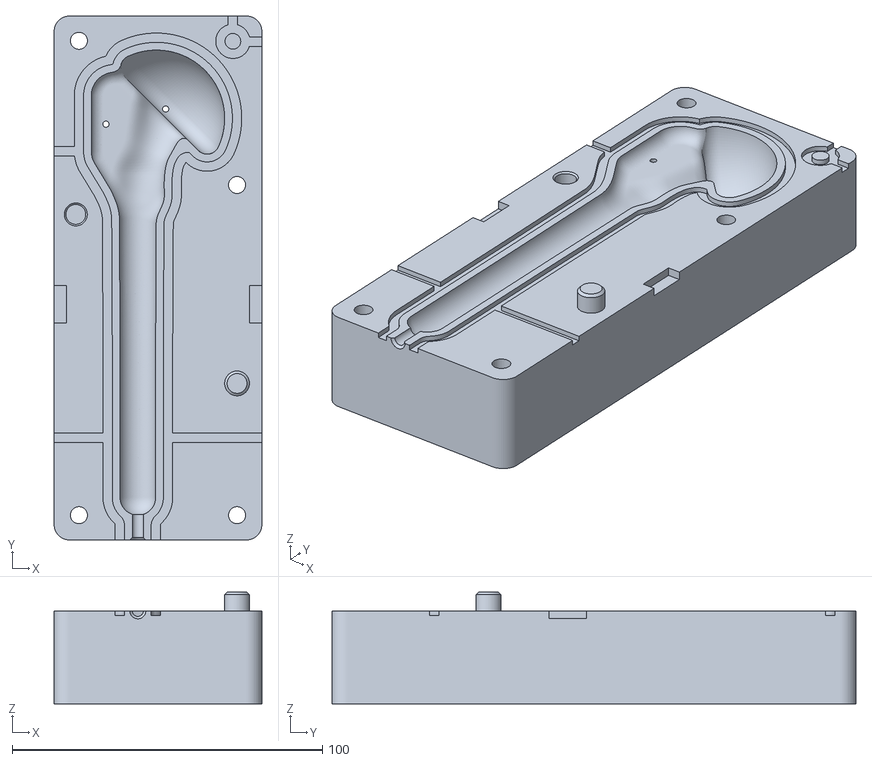
[picture p82: CAD file, 2026-10-12]
stl/C_longo/C_longo_h44_ANT_mesa.stl
67.0 x 169.0 x 36.0
