bgobbato/spacer_shoulder/stl/cupons/cupom_pinos_MACHO.stl

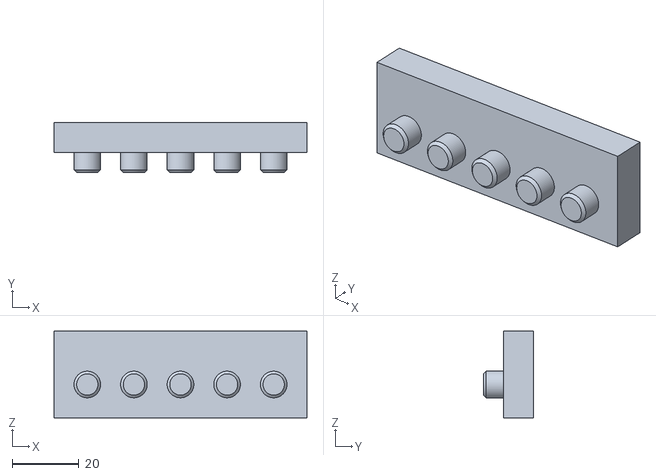
[picture p83: CAD file, 2026-10-12]
stl/cupons/cupom_pinos_MACHO.stl
76.0 x 15.0 x 26.0
