bgobbato/spacer_shoulder/stl/padrao/C_longo_h52_POST_mesa.stl

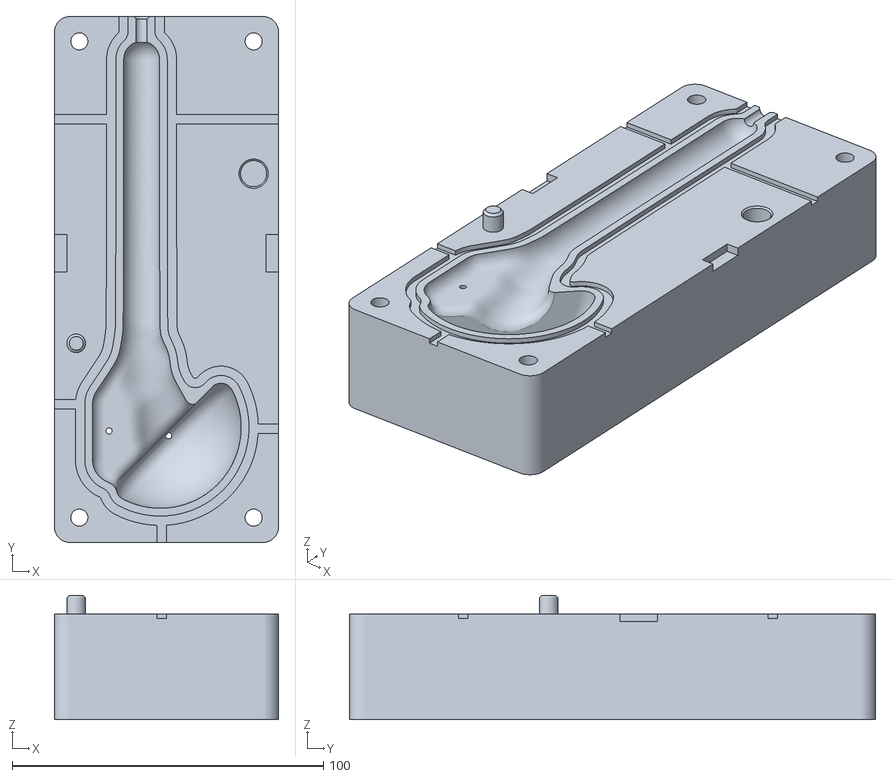
[picture p84: CAD file, 2026-10-12]
stl/padrao/C_longo_h52_POST_mesa.stl
72.0 x 169.0 x 40.0
