bgobbato/spacer_shoulder/stl/C_curto_dreno/C_h44_28Fr_ANT.stl

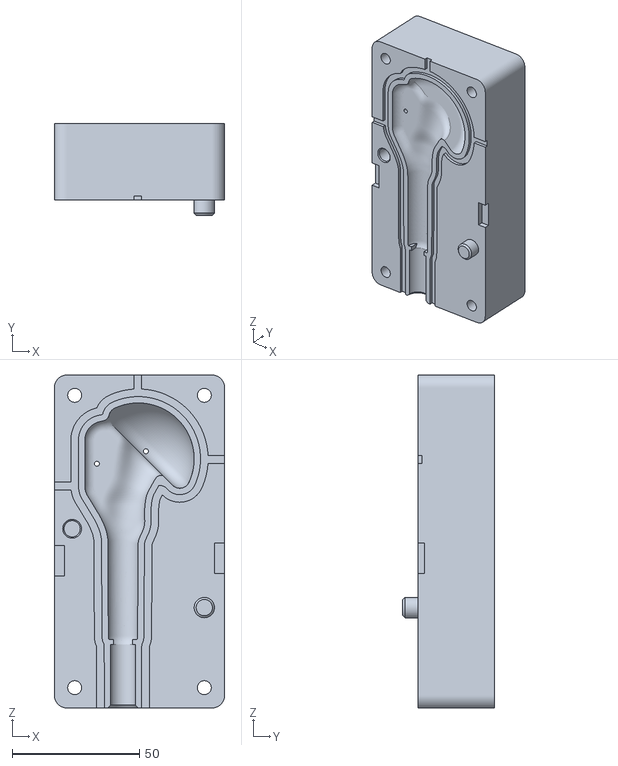
[picture p86: CAD file, 2026-10-12]
stl/C_curto_dreno/C_h44_28Fr_ANT.stl
67.0 x 36.0 x 131.0
