bgobbato/spacer_shoulder/stl/C_longo/C_longo_h48_ANT_mesa.stl

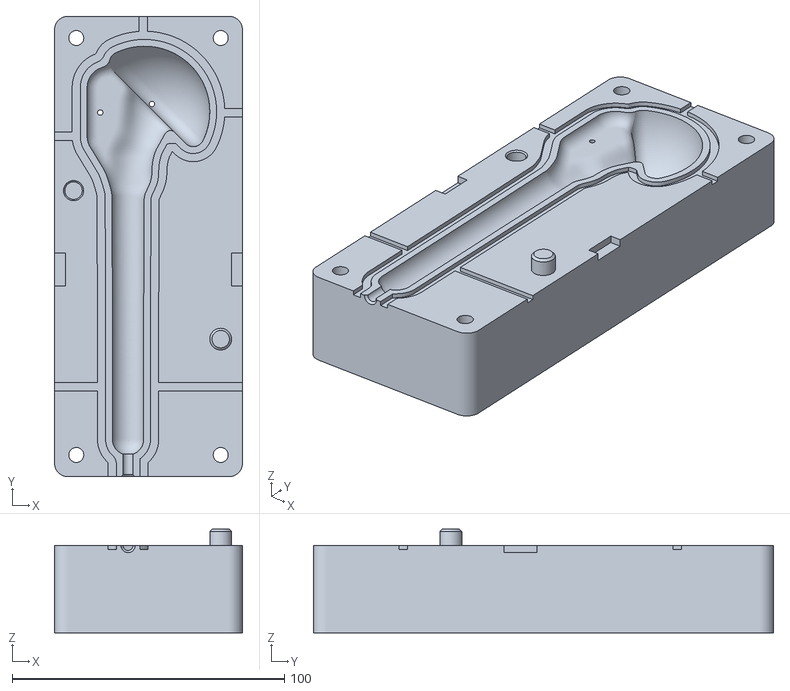
[picture p87: CAD file, 2026-10-12]
stl/C_longo/C_longo_h48_ANT_mesa.stl
69.0 x 169.0 x 38.0
