bgobbato/spacer_shoulder/stl/cupons/cupom_dreno_28Fr.stl

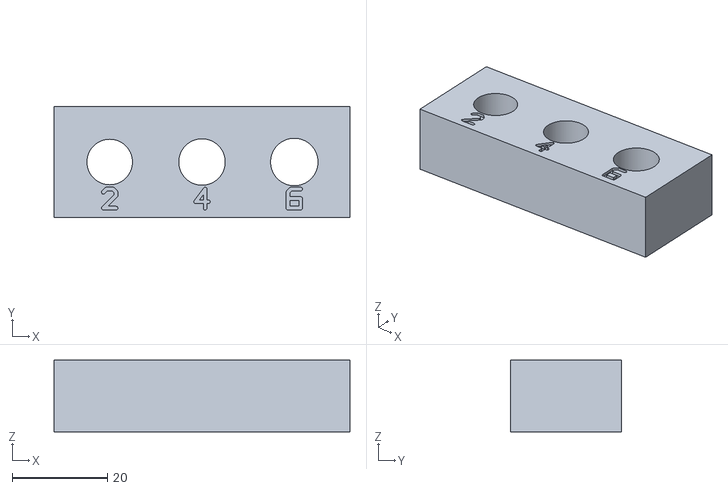
[picture p88: CAD file, 2026-10-12]
stl/cupons/cupom_dreno_28Fr.stl
62.0 x 23.3 x 15.0
