bgobbato/spacer_shoulder/stl/positivos/C_longo_h44.stl

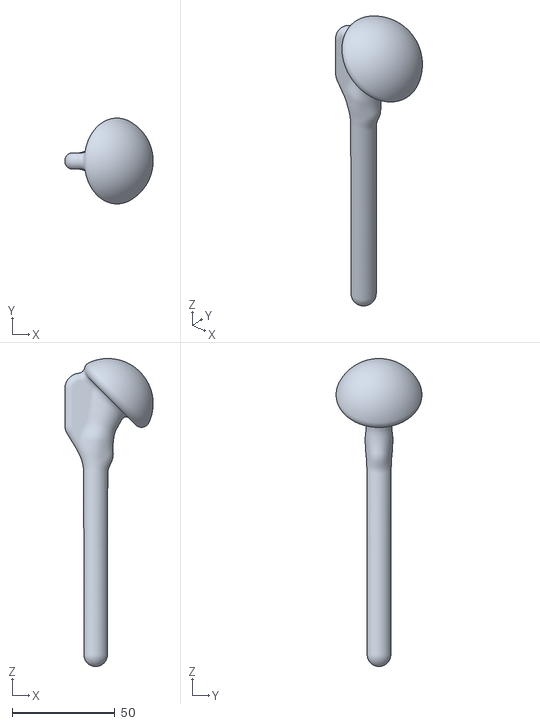
[picture p89: CAD file, 2026-10-12]
stl/positivos/C_longo_h44.stl
43.0 x 41.8 x 150.0
