bgobbato/spacer_shoulder/stl/C_curto_dreno/C_h48_28Fr_POST.stl

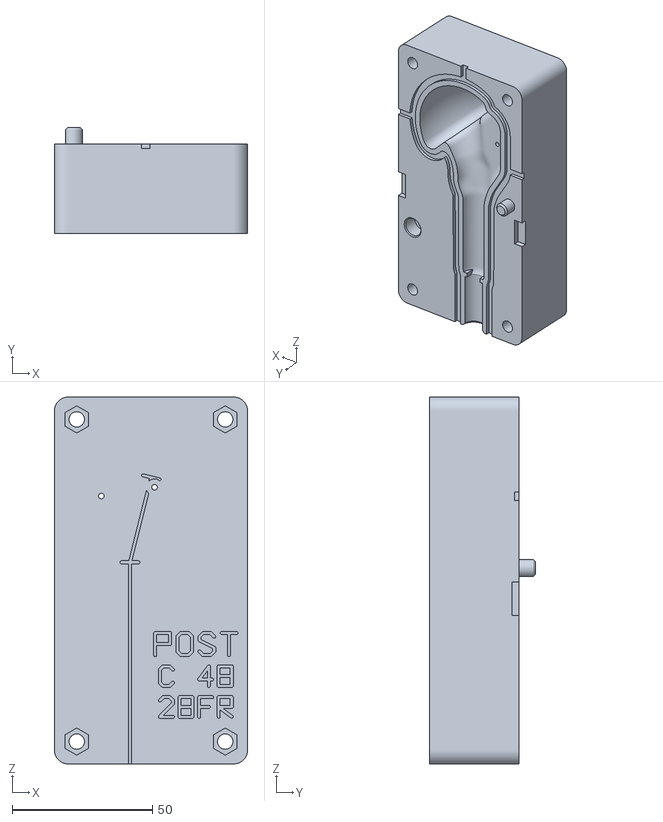
[picture p90: CAD file, 2026-10-12]
stl/C_curto_dreno/C_h48_28Fr_POST.stl
69.0 x 38.0 x 131.0
