bgobbato/spacer_shoulder/stl/positivos/A_h44.stl

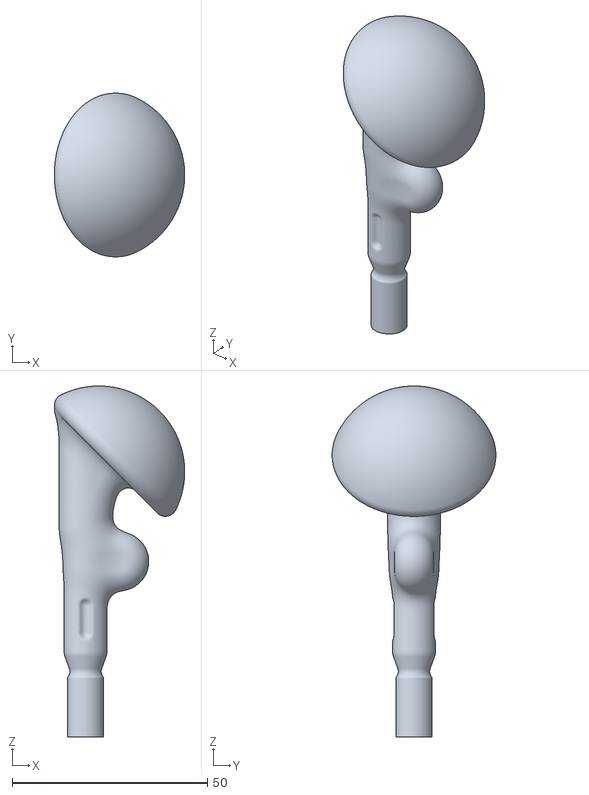
[picture p91: CAD file, 2026-10-12]
stl/positivos/A_h44.stl
33.4 x 42.0 x 90.0
