bgobbato/spacer_shoulder/stl/positivos/A_h48.stl

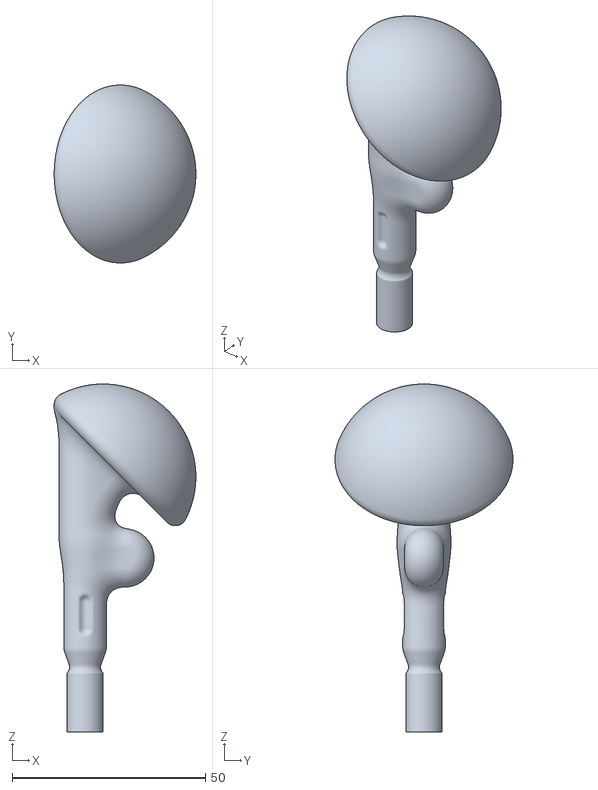
[picture p92: CAD file, 2026-10-12]
stl/positivos/A_h48.stl
36.7 x 46.0 x 90.0
