bgobbato/spacer_shoulder/stl/positivos/C_h48.stl

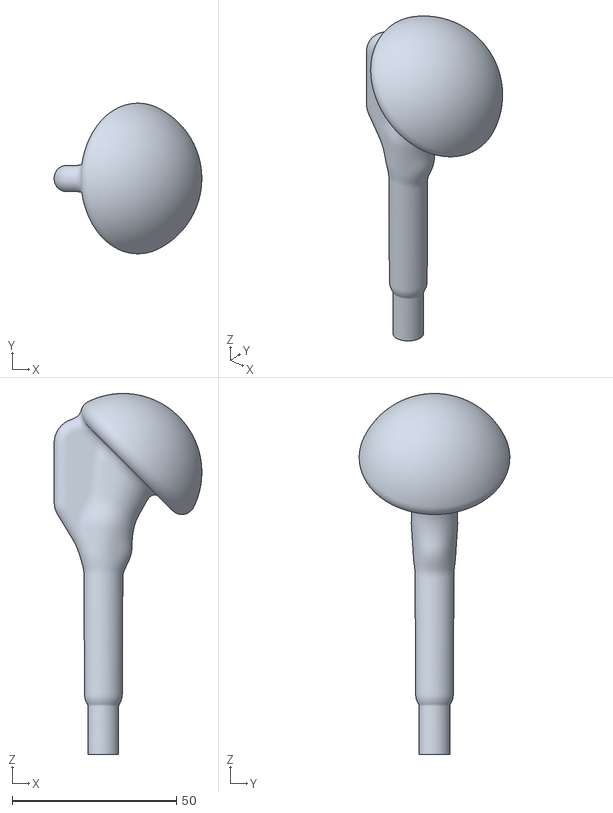
[picture p93: CAD file, 2026-10-12]
stl/positivos/C_h48.stl
45.0 x 45.9 x 110.0
