bgobbato/spacer_shoulder/stl/positivos/B_h48.stl

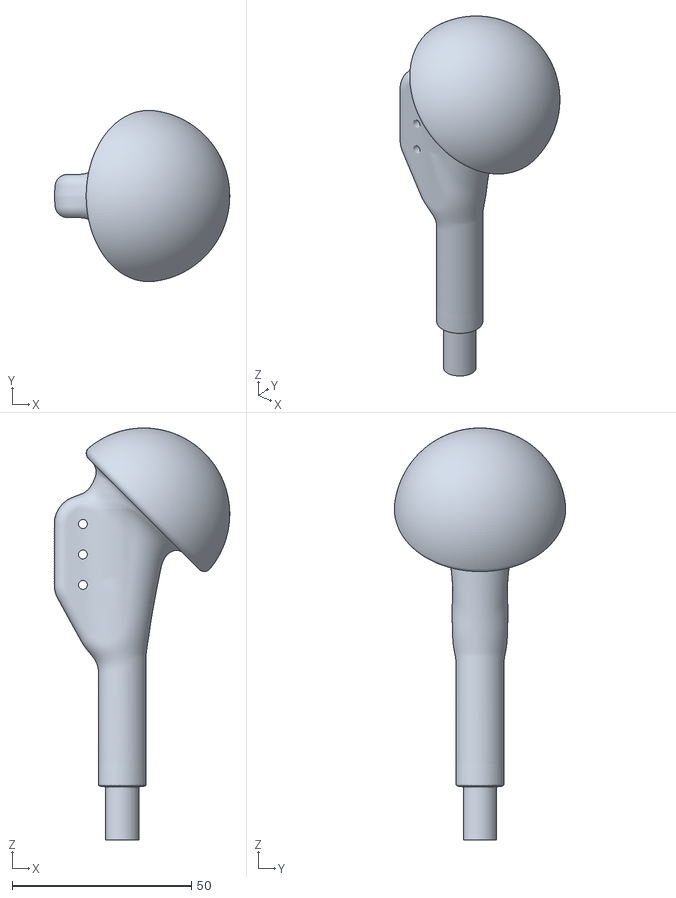
[picture p94: CAD file, 2026-10-12]
stl/positivos/B_h48.stl
49.0 x 47.8 x 115.0
