bgobbato/spacer_shoulder/stl/positivos/A_h52.stl

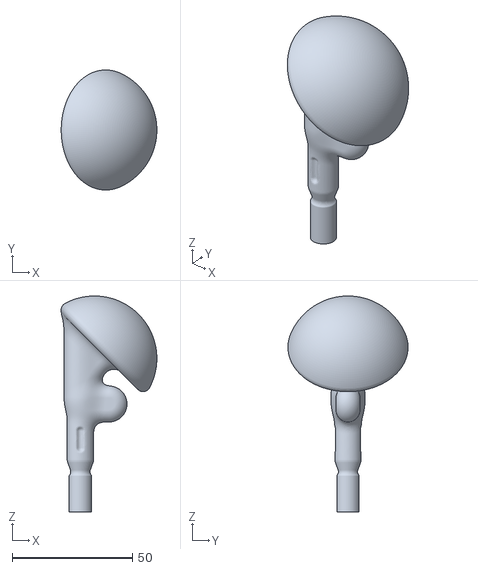
[picture p95: CAD file, 2026-10-12]
stl/positivos/A_h52.stl
39.9 x 50.0 x 90.0
