bgobbato/spacer_shoulder/stl/positivos/B_h52.stl

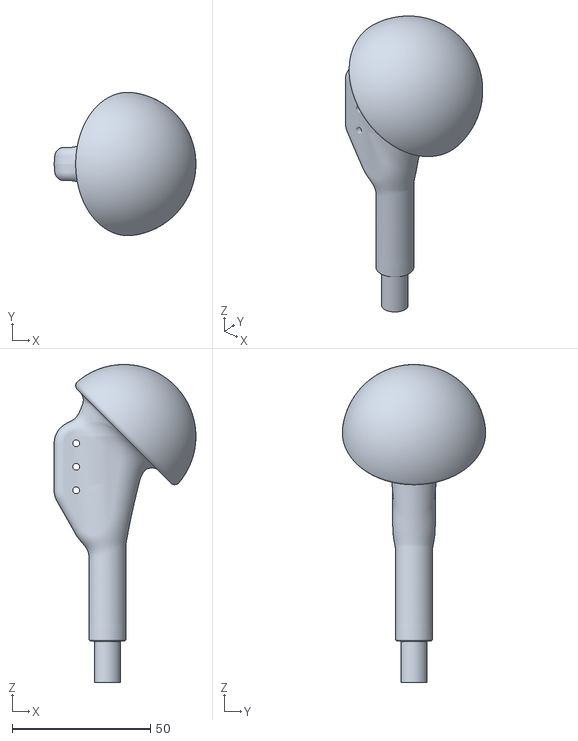
[picture p97: CAD file, 2026-10-12]
stl/positivos/B_h52.stl
51.3 x 51.8 x 115.0
