bgobbato/spacer_shoulder/stl/positivos/B_h44.stl

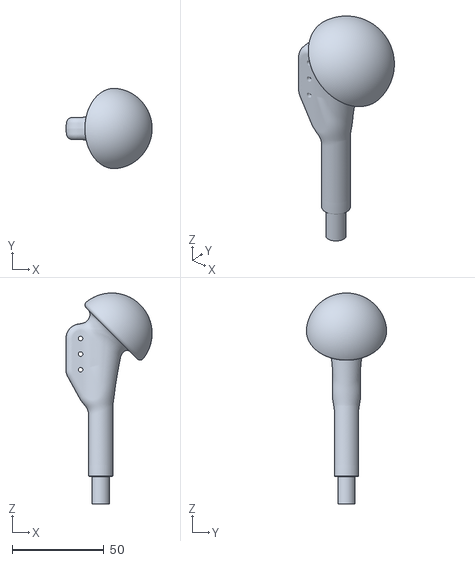
[picture p98: CAD file, 2026-10-12]
stl/positivos/B_h44.stl
47.0 x 43.8 x 115.0
