bgobbato/spacer_shoulder/(list of files, cad)

Other CAD files:
stl/C_longo/C_longo_h52_ANT.stl
stl/C_curto_dreno/C_h52_28Fr_POST.stl
stl/C_longo/C_longo_h48_POST_mesa.stl
stl/C_curto_dreno/C_h44_28Fr_POST.stl
stl/C_longo/C_longo_h44_ANT.stl
stl/C_longo/C_longo_h52_POST.stl
stl/C_longo/C_longo_h48_POST.stl
stl/C_longo/C_longo_h48_ANT.stl
stl/C_longo/C_longo_h44_POST_mesa.stl
